duyphong375/uav_payload/docs/presentation/Doc1.docx

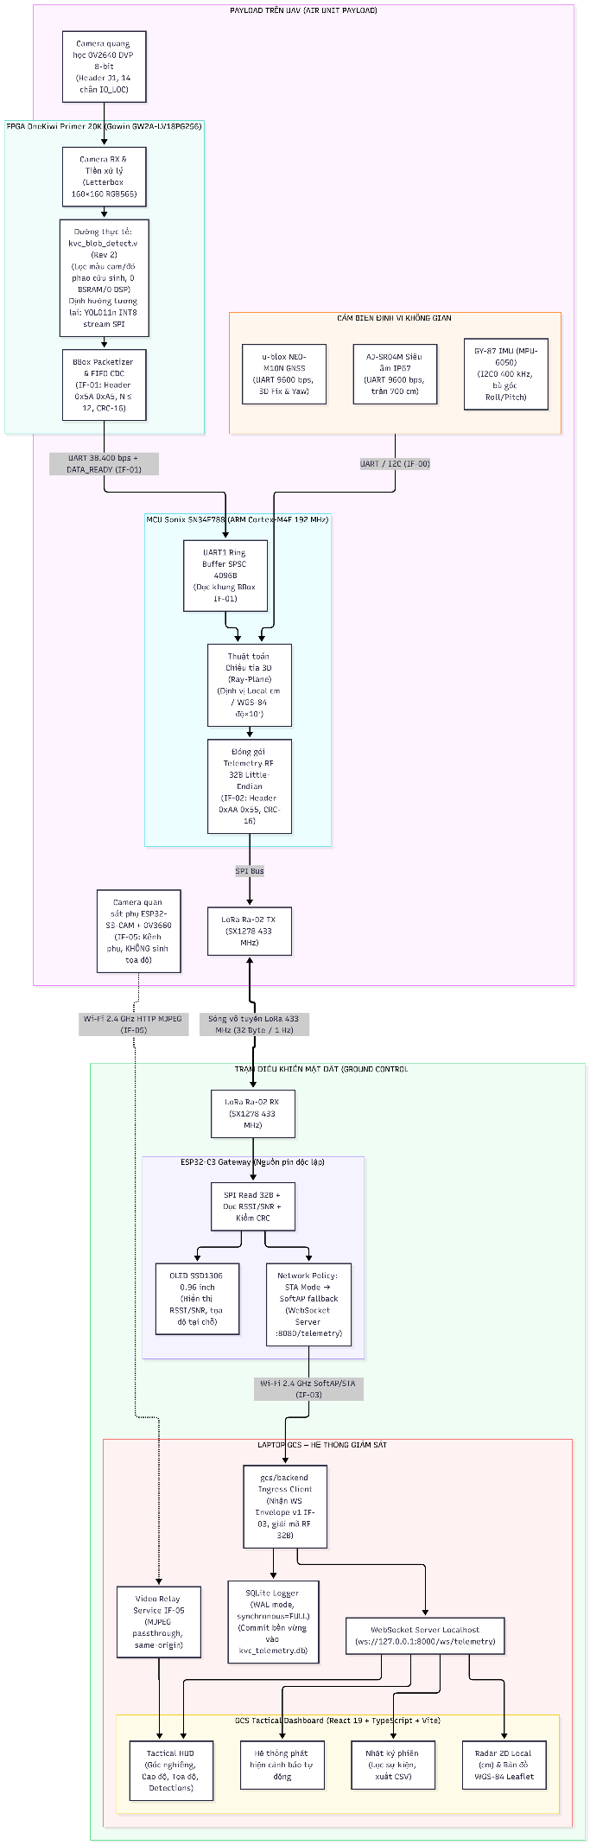
[picture p1: figure]
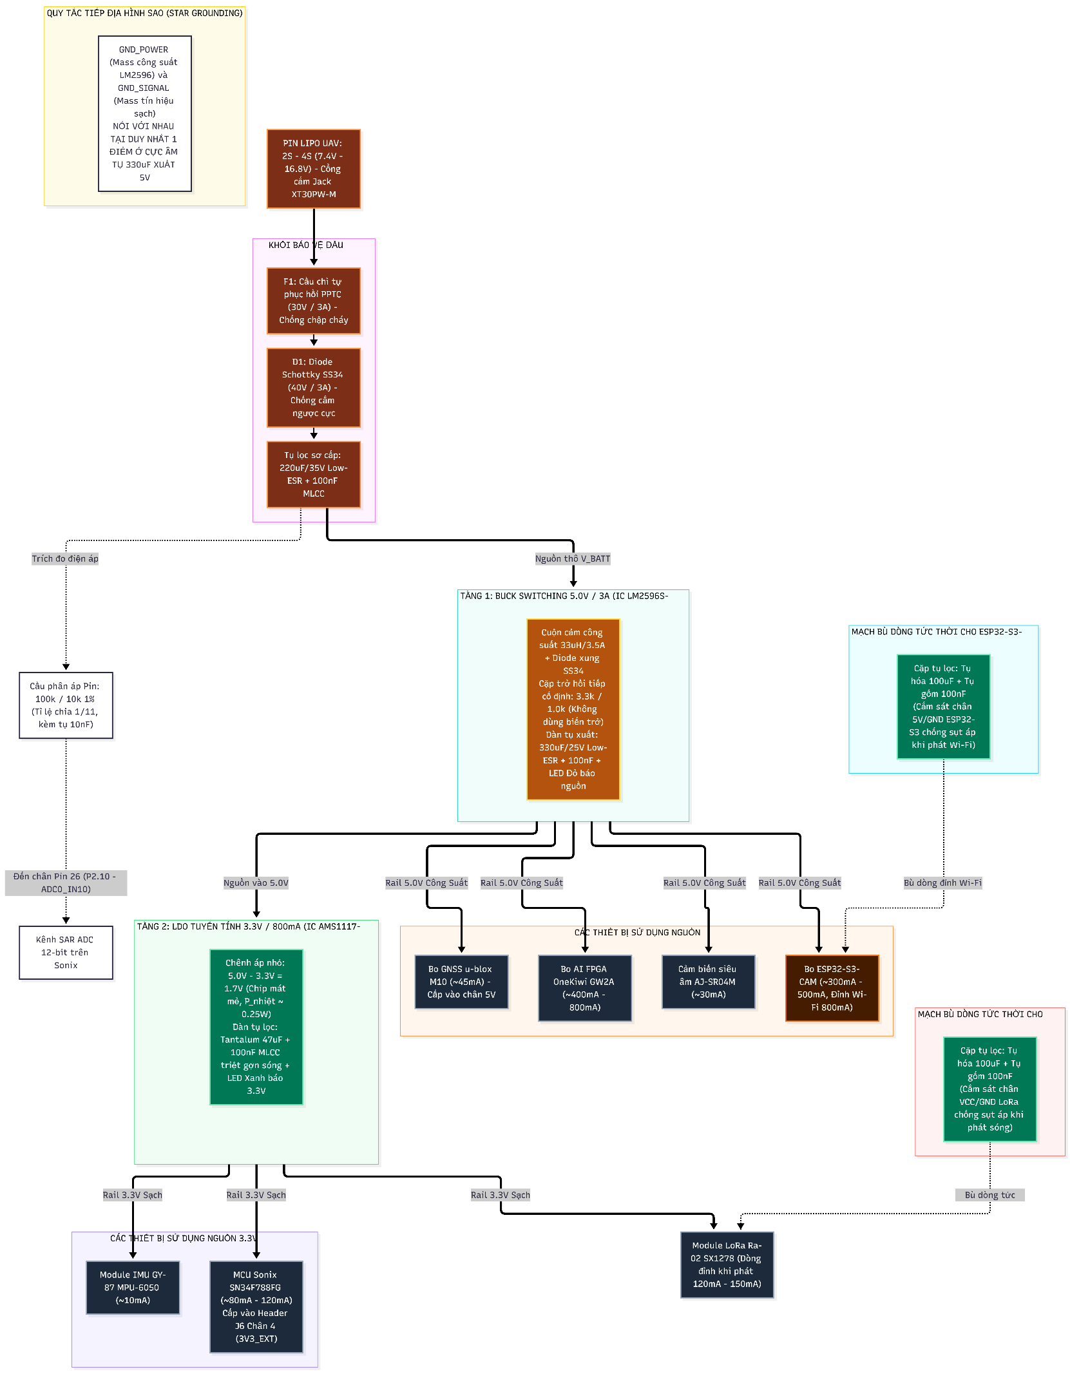
[picture p2: figure]

Kiến trúc toàn hệ thống+Cây phân phối điện năng

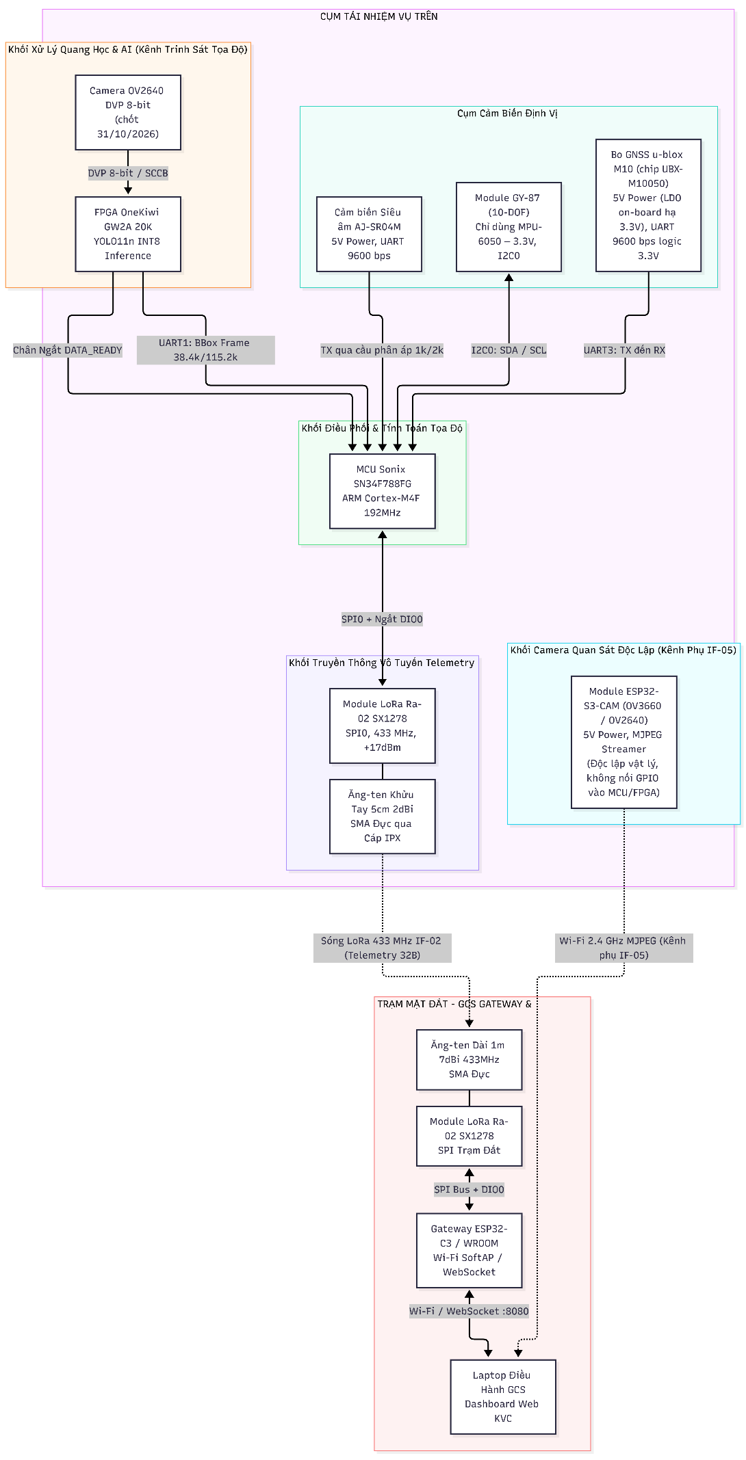
[picture p3: figure]

Sơ đồ khối đấu nối toàn hệ thống

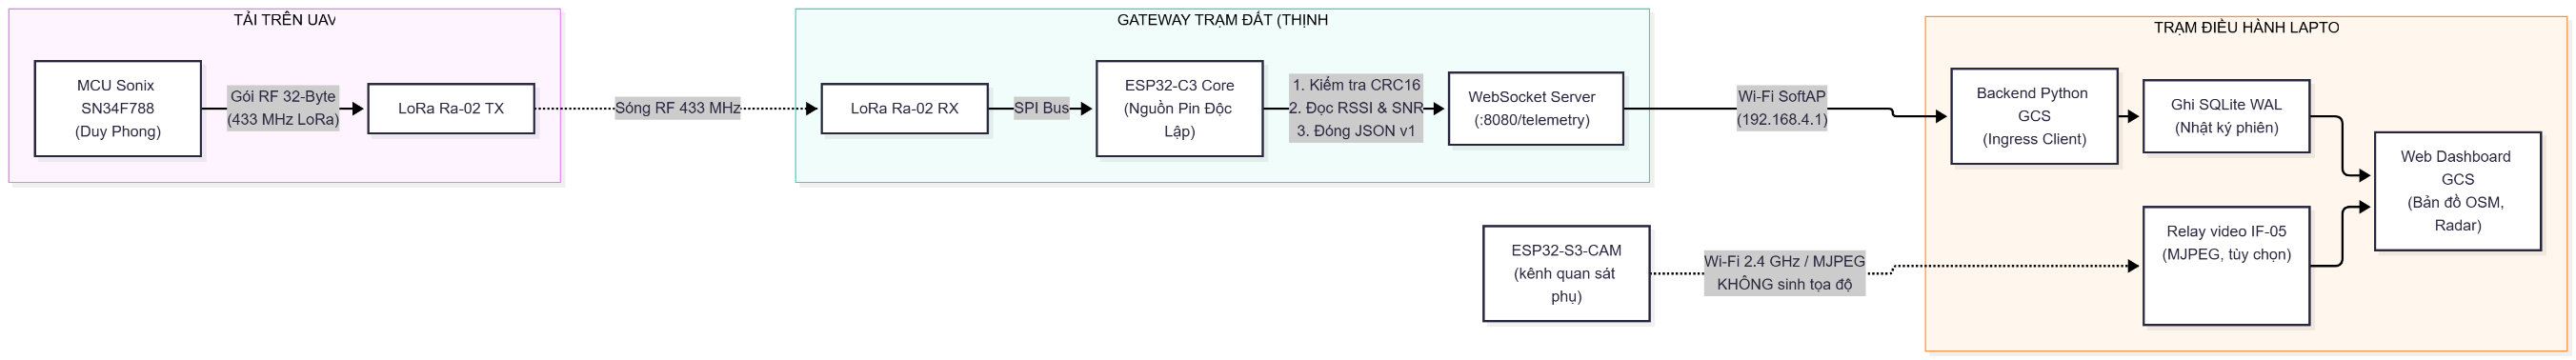
[picture p4: figure]

Luồng telemetry và gateway trạm đất

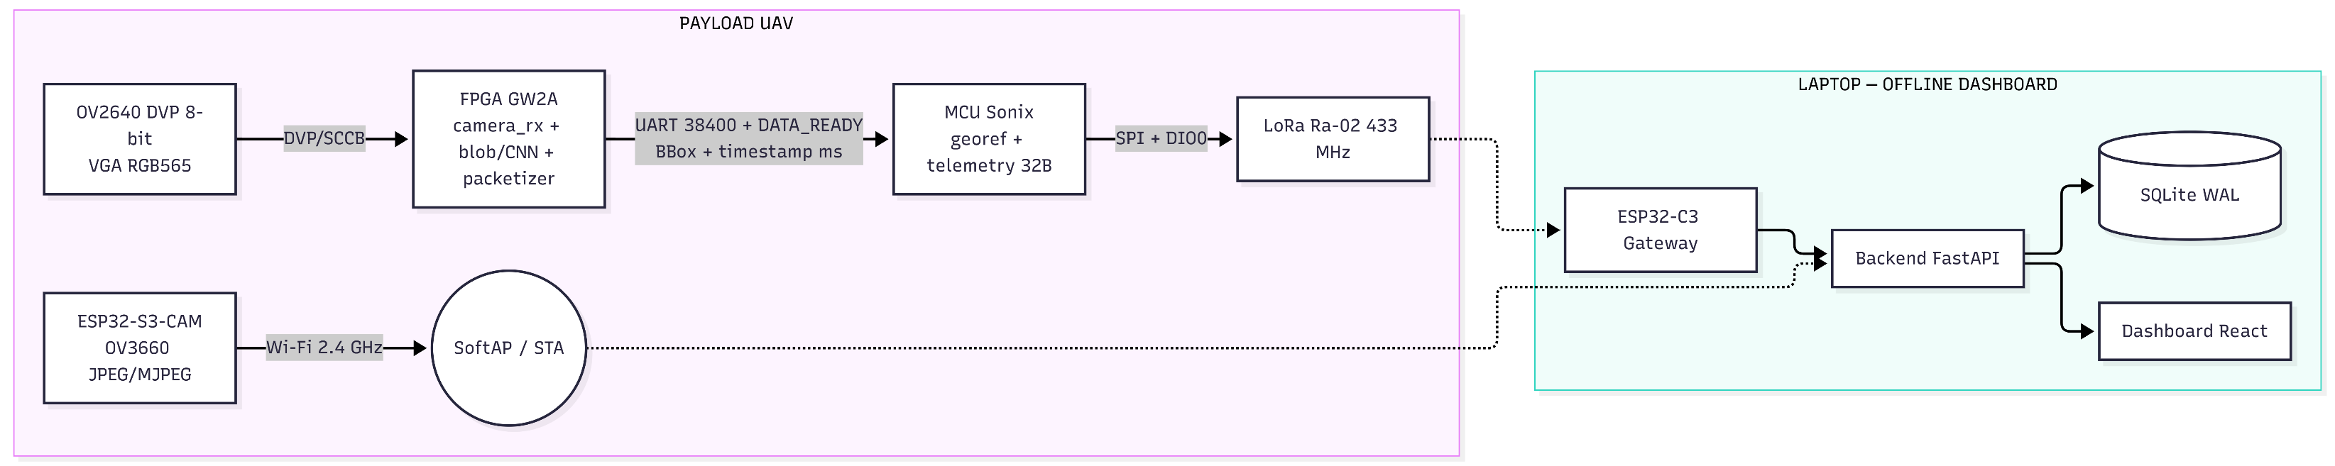
[picture p5: figure]

Sơ đồ phân vai hai camera
