duyphong375/uav_payload/docs/presentation/KVC_Presentation_Deck.pptx

CUỘC THI THIẾT KẾ FPGA VÀ MCU MỞ RỘNG KHU VỰC MIỀN TRUNG 2026
KVC — HỆ THỐNG TẢI NHIỆM VỤ UAV TÌM KIẾM CỨU NẠN BÃO LŨ
Thiết kế tích hợp FPGA Gowin GW2A (Thị giác biên) và MCU Sonix SN34F788 (Định vị 3D) kết hợp truyền tin vô tuyến LoRa 433 MHz
BA ĐỊNH VỊ CỐT LÕI:
• Tải nhiệm vụ (Payload) độc lập, không can thiệp Flight Controller
• Vận hành 100% Offline, không phụ thuộc Internet mặt đất
• Gói tin 32 byte nhị phân thay cho luồng video băng thông cao
Đơn vị: Đội KVC — Đại học Bách Khoa – Đại học Đà Nẵng
Thành viên: Nguyễn Tất Vững (Lead) • Duy Phong • Trường Thịnh • Trung Kiên • Mạnh Cường

## Slide 2

KHỐI 1: TỔNG QUAN
Bài toán cứu nạn thực địa và ràng buộc thiết kế

1:30 | 02/15

Ba nút thắt cứu nạn bão lũ miền Trung
• Hạ tầng tê liệt: Mất điện lưới, trạm BTS ngập úng, không có sóng 4G/5G/Internet.
• Nghịch lý video số: Video HD cần hàng Mbps, sóng cao tần bị mưa bão suy hao cực nặng, trễ lớn hoặc đứt sóng.
• Áp lực thời gian: Cứu hộ viên cần tọa độ trong vài phút, không cần video đẹp; mắt người không quét kịp diện rộng.
• So sánh băng thông: Truyền video HD (Mbps) vs Truyền tọa độ biên (vài chục bps).

Ràng buộc thiết kế & Phạm vi PoC
• Ràng buộc kỹ thuật: Xử lý ảnh tại biên; gói tin siêu nhỏ (Zero-Video); trạm đất tự chủ nguồn pin; offline hoàn toàn.
• Phạm vi trong PoC (Có thể kiểm chứng):
• • Nhận diện trên video lũ có sẵn [SOURCE-VERIFIED]
• • Thử nghiệm bể bơi chứng minh luồng [SIMULATED]
• • Vận hành trực tiếp tại bàn thi, KHÔNG DÙNG SA BÀN.
• Ngoài phạm vi PoC: Khung bay drone, chứng nhận hàng không DO-254/DO-178C, chống nước IP67.

## Slide 3

KHỐI 1: TỔNG QUAN
Kiến trúc tổng thể: Hai nửa hệ thống và bus vật lý

2:00 | 03/15

Phân định phần cứng & Bus truyền dẫn
• AIR UNIT (TẢI UAV):
• ① Camera OV2640 DVP 8-bit nối FPGA OneKiwi 20K.
• ② FPGA nối MCU Sonix qua UART 38.400 bps + DATA_READY.
• ③ Cảm biến: Siêu âm (UART 9600), IMU (I2C0 400k), GNSS (UART 9600).
• ④ MCU nối module LoRa Ra-02 TX qua SPI + DIO0.
• KÊNH VÔ TUYẾN: Sóng LoRa 433 MHz (Khung nhị phân 32 byte).
• GROUND STATION (TRẠM ĐẤT):
• ⑤ LoRa Ra-02 RX nối Gateway ESP32-C3 qua SPI.
• ⑥ ESP32-C3 nối Laptop GCS qua Wi-Fi SoftAP / WebSocket v1.
• Kênh phụ IF-05: ESP32-S3-CAM phát MJPEG Wi-Fi (nét đứt, không qua LoRa).

Bảng phân công nhiệm vụ 5 khối cốt lõi
• FPGA Primer 20K: Trích xuất BBox streaming từ pixel [HARDWARE-VERIFIED]
• MCU Sonix M4F: Dung hợp cảm biến, giải định vị 3D [BUILT]
• LoRa Ra-02 (SX1278): Truyền telemetry 32 byte xuyên bão [HARDWARE-VERIFIED TX]
• ESP32-C3 Gateway: Thu RF, OLED hiện trường, SoftAP [BUILT]
• Laptop GCS: Dashboard, SQLite WAL, Nhật ký phiên [SOURCE-VERIFIED]
• Kênh phụ IF-05: Mắt nhìn video phụ trợ, không sinh tọa độ.

## Slide 4

KHỐI 1: TỔNG QUAN
Nguyên lý cốt lõi: Chỉ truyền kết luận, không truyền video

1:15 | 04/15

Linh hồn thiết kế của đề tài KVC
• CÂU CHỐT CỐT LÕI:
'Biến một luồng video thành một tọa độ trong 32 byte.'
• Ba tầng giá trị thiết kế:
• • Giảm băng thông 5 bậc độ lớn: từ hàng triệu bps xuống đúng 256 bps.
• • Giảm phụ thuộc chất lượng sóng: đường truyền video mất, cứu hộ vẫn chạy.
• • Vẫn bảo đảm đủ 100% dữ liệu để triển khai đội cứu nạn.
• Ranh giới an toàn: Payload không can thiệp điều khiển bay, không arm/disarm, không waypoint.

Chuỗi chuyển hóa 4 bước dữ liệu
• 1. Ảnh quang học thô: OV2640 DVP 640×480 RGB565 (~614 KB/khung).
• 2. Tọa độ BBox: Trích xuất song song trên FPGA (Khung 18 Byte IF-01).
• 3. Tọa độ cứu nạn 3D: MCU giải giao điểm mặt nước (Khung 32 Byte IF-02).
• 4. Hành động cứu hộ: Xuất ca-nô tiếp cận nạn nhân tức thì.
• Ẩn dụ kiến trúc:
• • FPGA = Mắt & Não trích xuất | MCU = Định vị & Đóng gói
• • LoRa = Dây dẫn vô tuyến | ESP32 = Cổng vào | Laptop = Bản đồ chỉ huy
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
