duyphong375/uav_payload/docs/presentation/KVC_ThuyetTrinh_15_Slide.pptx

CUỘC THI THIẾT KẾ FPGA & MCU MỞ RỘNG KHU VỰC MIỀN TRUNG 2026

KVC — Tải nhiệm vụ UAV tìm kiếm cứu nạn bão lũ

Phát hiện tại biên · Định vị bằng cảm biến · Truyền metadata 32 byte · Trạm đất ngoại tuyến

▸ Đội KVC — Trường Đại học Bách Khoa, Đại học Đà Nẵng · 5 thành viên
▸ KVC là payload gắn trên UAV, không phải flight controller
▸ Hai luồng vật lý độc lập: LoRa 433 MHz cho tọa độ, Wi-Fi cho video quan sát
▸ Toàn hệ thống vận hành 100% ngoại tuyến, không phụ thuộc Internet

KVC · Payload UAV tìm kiếm cứu nạn bão lũ

01 / 15

## Slide 2

PHẦN 1 · TỔNG QUAN

Bài toán và ràng buộc thiết kế

Vì sao phải xử lý tại biên thay vì truyền video về trạm đất

▸ Lũ quét: cứu hộ cần vị trí trong vài phút, không cần video chất lượng cao
▸ Mất Internet/4G; truyền video qua sóng dài cần hàng Mbps nên không khả thi
▸ Đánh đổi cốt lõi: truyền video (Mbps) so với truyền metadata (bps)
▸ Ràng buộc rút ra: xử lý tại chỗ, gói tin cực nhỏ, trạm đất tự chủ nguồn, offline hoàn toàn
▸ Phạm vi PoC: video lũ có sẵn, thử bể bơi, test trực tiếp — không chế tạo khung bay
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
