duyphong375/uav_payload/docs/verification/evidence/KVC-CAM-DIAG-20261102-002.md

# `KVC-CAM-DIAG` rev 2 — bucket 2x + bucket glitch + bộ lọc VSYNC

- **Mã:** `KVC-CAM-DIAG-20261102-002` (rev 2, tiếp nối `-001`)
- **Owner:** Kilo · **Ngày:** 02/11/2026
- **Trạng thái:** `BUILT` + `SIMULATED` — **chưa nạp bo**

---

## 1. Vì sao có rev 2

Capture 300 s trên bo (`G6.1_blob_vsyncdiag_20261102-1415.bin`) cho thấy ba vấn
đề của bản rev 1, đều đã phân tích trong
`KVC-CAM-DIAG-20261102-1415-analysis.md`:

| # | Vấn đề rev 1 | Hệ quả |
| :---: | :--- | :--- |
| 1 | `t_bother` ở **trường H slot 9, 8 bit** | 2.191 → 143 (`mod 256`), báo cáo sai một đại lượng quan trọng |
| 2 | **Không có bucket 2x (131 ms)** | 48,3 % chu kỳ rơi vào `other`; không phân biệt được AEC với nhịp 2x |
| 3 | **Không lọc glitch** | `w_min_ms = 1 ms` ở 39/151 cửa sổ; `t_vsync` bị thổi phồng 25 %, làm hỏng kết luận Q2 |

Rev 2 sửa cả ba.

---

## 2. Thay đổi

### 2.1 Bucket mới — phủ kín trục số, không chồng nhau

| Bucket | Dải (ms) | Ghi chú |
| :--- | :--- | :--- |
| **short** | **< 55** | MỚI — gom glitch lọt qua bộ lọc, tách khỏi `other` |
| 1x | 55 – 80 | nhịp 65,5 ms (15,26 fps) |
| **2x** | **120 – 145** | MỚI — nhịp 131 ms (7,6 fps), đúng phép đo 01–02/11 |
| 3x | 180 – 215 | nhịp 197 ms |
| 5x | 310 – 340 | nhịp 328 ms |
| 6x | 380 – 410 | nhịp 394 ms |
| other | còn lại | gồm 4x (~262), 7x…, và giá trị giữa các dải |

### 2.2 Bộ lọc glitch

```verilog
parameter integer GLITCH_MS = 10

wire accept = vsync_pulse && (!have_prev || (since_ok >= GLITCH_TICKS));
wire reject = vsync_pulse && !accept;
```

So sánh với **cạnh đã chấp nhận gần nhất** (`since_ok`), không phải cạnh trước
bất kỳ — nhờ vậy một chuỗi gai ngắn không tự kéo dài thời gian khoá.

### 2.3 `vsync_report` — 12 slot, không còn trường 8 bit

24 giá trị 16 bit ÷ 2 = **12 slot**, vừa đúng `MAX_BBOX = 12` của
`bbox_packetizer` nên không phải đổi tham số đó. Khung 106 byte = 27,6 ms ở
38.400 bps, vẫn ngắn hơn nhiều so với cửa sổ 2.000 ms.

Bản đồ đầy đủ ở đầu `vsync_report.v` và `decode_vsync_diag.py`.

### 2.4 Giới hạn của bộ lọc — đã ghi rõ trong RTL và kiểm bằng testbench

Nếu nhiễu lặp **đầy đủ mỗi 10 ms**, một gai sẽ lọt qua sau mỗi 10 ms. So sánh
thời gian đơn thuần không phân biệt được. Vì vậy:

- `t_rejected` — số gai **bị chặn**
- `t_bshort` — số chu kỳ ngắn **lọt qua**

Cả hai > 0 nghĩa là đường VSYNC **không sạch**, và mọi kết luận về nhịp camera
phải kèm điều kiện đó.

---

## 3. Kiểm chứng

### 3.1 `tb_vsync_monitor` — **42/42 PASS**

| Test | Nội dung | Kết quả |
| :---: | :--- | :--- |
| 1 | 5 xung đều 65,6 ms | `t_b1x=4`, các bucket khác 0 |
| 2 | ngừng bơm 300 ms | `t_vsync` không đổi |
| 3 | 5 xung đều **131 ms** | **`t_b2x=4`** — bucket 2x hoạt động |
| 4 | mẫu 1x/2x/3x/5x/6x | cả 5 bucket = 1, tổng = 5 |
| 5 | **5 gai cách 1 ms** | `t_vsync=2`, `t_rejected=5`, `t_bshort=0` — **lọc đúng** |
| 5b | **gai cách 12 ms** | `t_rejected=0`, `t_bshort=1` — **lọt qua, đúng như tài liệu** |
| 6 | 6 VSYNC / 3 frame | chênh = 3 |
| 7 | chu kỳ 30 ms (> 10, < 55) | `t_bshort=3`, `t_rejected=0` |

Test 5 và 5b cùng tồn tại có chủ đích: 5 chứng minh lọc hoạt động, 5b chứng minh
**giới hạn** của nó để không ai tưởng bộ lọc mạnh hơn thực tế.

### 3.2 Các TB khác

| TB | Kết quả |
| :--- | :--- |
| `tb_vsync_selfmeas` (top-level, `DIAG_MODE=2`) | **10/10 PASS** — N=12, 106 byte, slot order đúng |
| Toàn bộ suite | **24/24 PASS** |

### 3.3 `decode_vsync_diag.py`

- Nhận diện layout theo số slot: **12 → rev 2**, **10 → rev 1** (tự phục hồi
  `t_bother` bị cắt 8 bit và cảnh báo).
- Đọc lại file cũ `…1415.bin` vẫn đúng: `layout N=10`, `t_bother=2191`, cảnh
  báo `other > 40 %`.
- Cảnh báo khi tổng bucket ≠ `t_vsync − 1`.
- Ba phần kết luận Q1 (nhịp) / Q2 (chênh VSYNC-frame) / Q3 (nhiễu).

---

## 4. Bitstream

| Trường | Giá trị |
| :--- | :--- |
| SHA-256 | **`CA6D5137292FEFACAB98DC2097A7611A110F9E052189FDC839D748D4752E4B9D`** |
| File | `review/artifacts/KVC_FPGA_diag_vsync_CA6D5137.fs` |
| Top | `kvc_top_diag_vsync` (`DIAG_MODE = 2`, `DIAG_GLITCH_MS = 10`) |
| Fmax `clk_100m` | **109,546 MHz**, TNS = 0 |
| Fmax `cam_pclk` | **146,857 MHz**, TNS = 0 |
| Tài nguyên | 2.588 LUT / 2.180 FF / 1 BSRAM / 0,5 DSP |
| Đường tới hạn | `bbox_packetizer` 11,365 ns (**không** phải logic mới) |
| Build script | `KVC_PR/tools/build_kvc_diag_vsync.tcl` |

So sánh ba bản:

| Bản | SHA | Fmax | LUT | Slot | Ghi chú |
| :--- | :--- | ---: | ---: | :---: | :--- |
| rev 0 | `C82B9EFE` | 105,030 | 2.437 | 10 | `t_bother` 8 bit |
| rev 1 | `840117FA` | 121,436 | 2.416 | 10 | `t_bother` 16 bit |
| **rev 2** | **`CA6D5137`** | **109,546** | **2.588** | **12** | +2x, +short, +lọc |

Fmax giảm 121 → 110 MHz vì thêm 172 LUT cho bucket và bộ lọc; vẫn trên ngưỡng
100 MHz với biên 9,5 %, và TNS = 0 trên cả ba clock.

---

## 5. Cách dùng

```powershell
# 1. Nạp review/artifacts/KVC_FPGA_diag_vsync_CA6D5137.fs qua SRAM Program

# 2. Kiem chu ky nap: phai thay N=12 va khung 106 byte
python scripts/manual/fpga_uart_capture.py --port COM9 --baud 38400 --seconds 10

# 3. Capture 300 s
python scripts/manual/fpga_uart_capture.py --port COM9 --baud 38400 --seconds 300 `
  --dump docs/verification/evidence/G6.1_blob_vsyncdiag_<YYYYMMDD-HHMM>.bin

# 4. Giai ma
python scripts/manual/decode_vsync_diag.py `
  --file docs/verification/evidence/G6.1_blob_vsyncdiag_<YYYYMMDD-HHMM>.bin
```

**Bước 2 bắt buộc.** Lần 02/11 11:30 đã capture nhầm bitstream release vì bỏ qua
bước này.

---

## 6. Điều rev 2 sẽ trả lời được

| Câu hỏi | Cách đọc |
| :--- | :--- |
| Nhịp VSYNC có phải 1x/2x/3x/5x/6x không? | `t_b2x` và `t_bshort` khác 0 hay không |
| `other` còn lớn không? | nếu vẫn > 40 %, mô hình bucket vẫn chưa phủ — cần đo lại `w_min`/`w_max` thô |
| Đường VSYNC có nhiễu không? | `t_rejected` và `t_bshort` |
| FPGA có rớt frame không? | `t_vsync − t_frame`, **chỉ khi `t_rejected` nhỏ** |

Rev 2 **không** trả lời được: PCLK (chưa đo), exposure (chưa đo), và nguyên
nhân gốc của nhiễu nếu `t_rejected` lớn — khi đó phải xem phần cứng chân A15 và
`cam_vsync_sync` 3FF.

---

## 7. Bitstream chẩn đoán nói cùng dây với MCU — đã kiểm, hiện KHÔNG xảy ra

**Tình huống:** `CA6D5137` đã nạp (SRAM Program OK, Status `0x00006020`).
Cáp UART đang cắm cho cụm Sonix MCU. `R13 (J2-11)` nối cứng tới `P2.3 (JP3 7/8)`
theo `KVC-MCU-FPGA-LORA-20261101-001.md:23`.

Nghĩa là **cùng một đường dây** đang mang báo cáo chẩn đoán `N = 12` vào MCU.

### 7.1 Parser MCU CHẤP NHẬN N = 12

`firmware/mcu_payload/src/sensors/kvc_fpga_bbox.c:239`:

```c
if (ver != KVC_FPGA_VERSION || count > KVC_FPGA_MAX_CANDIDATES) {
    s_fsm_state = STATE_WAIT_SYNC0;   /* huy frame */
}
```

`KVC_FPGA_MAX_CANDIDATES = 20` (`kvc_fpga_bbox.h:30`). Vậy **N = 12 lọt qua**
kiểm tra và được nhận là frame IF-01 hợp lệ. CRC cũng đúng vì `vsync_report`
dùng đúng `bbox_packetizer`.

### 7.2 Hệ quả nếu telemetry đang chạy

12 "bbox" chẩn đoán có `class = 2`, `conf = 100` cố định:

| Trường chẩn đoán | MCU đọc thành |
| :--- | :--- |
| `x = w_vsync` (vd 19) | `x_center = 19` |
| `y = w_periods` (vd 19) | `y_center = 19` |
| `w = chỉ số slot` (0..11) | `width` 0..11 |
| `h = 0` | `height = 0` |

`main.c:2066-2068` sẽ bật `KVC_FLAG_AI_DETECTED`, đặt `class_id = 2`,
`confidence = 100`, rồi gọi `kvc_georef_target()` với `x_center/y_center` là số
đếm chẩn đoán. Telemetry 1 Hz sẽ báo "AI phát hiện" liên tục đến khi hết hạn
frame (`KVC_GEO_BBOX_MAX_AGE_MS = 300`).

### 7.2b KIỂM TRA TRÊN BO — rủi ro **KHÔNG xảy ra**

Đo trực tiếp ngày 02/11/2026, log `[M3]` của Sonix MCU:

```text
[M3] ... | BB n0 v1 crc0 en1 | LORA d1 ver=0x12 | tx=1759 ...
```

| Trường | Giá trị | Nghĩa |
| :--- | :--- | :--- |
| `n0` | 0 mục tiêu | **không phải 12** |
| `v1` | frame hợp lệ | đang nhận khung IF-01 đều đặn |
| `crc0` | 0 lỗi CRC | khung đúng |
| `en1` | driver FPGA bật | đường UART1 hoạt động |

`n` trong log lấy từ `bbox->candidate_count` (`main.c:890`). Nếu rev 2 đang chạy,
`n` sẽ là **12** ở mọi gói. Thực tế là **0** ⇒

> **Bo đang chạy bitstream release `86CCF5DD`, không phải `CA6D5137`.**

Điều này khớp với chữ ký release: `N = 0` khi không có mục tiêu trước ống kính,
một khung mỗi frame (~4,3 fps), `v1` giữ liên tục.

Nhiều khả năng đã có lần nạp lại release sau lần nạp rev 2, hoặc SRAM mất điện.
Không cần xác định chính xác — điều quan trọng là **rủi ro §7 chưa xảy ra**, và
đây là **bằng chứng trực tiếp**, không phải suy đoán.

**Hệ quả cho kế hoạch:** vì cáp `R13` được giữ nguyên cho chuỗi tích hợp, và bo
đang chạy release, trạng thái hiện tại **an toàn**. Nhưng bất kỳ lần nạp rev 2
nào trong tương lai — kể cả vô tình — sẽ **ngay lập tức** làm `n` nhảy lên 12.
Trước khi nạp lại rev 2, phải chọn một trong hai: rút dây `R13`, hoặc chấp nhận
dữ liệu MCU bị nhiễu trong suốt thời gian đó.

### 7.3 Đây không phải lỗi RTL

`vsync_report` làm đúng việc của nó. Vấn đề là **dùng chung một đường UART cho
hai mục đích** mà không có cơ chế loại trừ. `AGENTS.md` cấm đổi ABI IF-01, nên
không thể "sửa" bằng cách thêm mã nhận dạng vào khung.

### 7.4 Cách tránh

| Mục đích | Việc làm |
| :--- | :--- |
| Cần log MCU | **Nạp lại release `86CCF5DD`** trước khi tin telemetry |
| Cần đo VSYNC | **Rút dây `R13` khỏi `P2.3`**, cắm sang USB-UART CH340 |
| Đọc telemetry trong lúc chẩn đoán | **Không** dùng — `AI_DETECTED` và toạ độ mục tiêu là rác |

Chọn phương án 2 cho phiên capture 300 s tới, và ghi vào log là **đã rút dây
MCU** — nếu không, một lần nữa không quy được trách nhiệm.

### 7.5 Đề xuất cho lần sau (chưa làm, cần duyệt)

Một trong hai, cả hai đều **không đổi ABI**:

1. **Dùng `class` riêng** cho báo cáo chẩn đoán (ví dụ `class = 0xFF`) để MCU
   lọc được. Hiện `vsync_report` đặt `class = 2` chỉ để khung "hợp lệ" — nhưng
   `class` **không** tham gia kiểm tra hợp lệ nào trong parser MCU, nên đổi
   sang giá trị riêng an toàn hơn.
2. **Thêm bit chế độ** vào trường `reserved` của header IF-01 nếu ABI cho phép —
   cần HUMAN duyệt vì đụng layout.

Phương án 1 rẻ hơn và không đụng ABI. Nhưng nó vẫn không giải quyết việc MCU
nhận 12 khung sai mỗi 2 s, chỉ giúp lọc.
