duyphong375/uav_payload/docs/verification/evidence/KVC-FPGA-BLOB-20261102-001.md

# KVC — Phân tích `.bin` 02/11 + soak 30 phút, và findings F-04…F-06

- **Mã:** `KVC-FPGA-BLOB-20261102-001`
- **Loại:** phân tích bằng chứng (không sửa RTL, không đổi ABI)
- **Owner:** Kilo · **Ngày:** 02/11/2026
- **Căn cứ:** các file trong chính thư mục này, đọc trực tiếp bằng script CRC-16:

| File | Byte | Khung | Dùng cho |
| :--- | ---: | ---: | :--- |
| `G6.1_blob_light_bright_20261102-0230.bin` | 1.288 | 128 | F-05, định lượng nhịp khung |
| `F02_card240_20261102.bin` | 920 | 84 | F-05 (lặp lại cùng phân bố) |
| `F02_card_20261102.bin` | 890 | 85 | F-04 (timestamp lùi) |
| `G2.7_soak_20261102.txt` | 320 KB | 272 mẫu `[RING]` | G2.7 + độ ổn định |
| `F02_card240_run2.bin` | 3.655 | **0** | **không dùng** — không phải IF-01 |

Mức bằng chứng: `HARDWARE-VERIFIED` cho các số đọc trực tiếp từ file;
`SOURCE-VERIFIED` cho các suy luận từ RTL; `DESIGN` cho giả thuyết cơ chế.

---

## 1. F-04 (P2) — Timestamp IF-01 có thể **bị xé** (torn read)

**Vị trí:** `KVC_PR/src/comm/bbox_packetizer.v:76-79` và `:119-135`.

```verilog
wire [7:0] ts0 = timestamp[7:0];   // đọc TRỰC TIẾP từ counter đang chạy
...
16'd4: get_header_byte = ts0;      // byte 0 phát ở thời điểm T
...
16'd7: get_header_byte = ts3;      // byte 3 phát ở thời điểm T + 7 byte-time
```

`timestamp` là `frame_timestamp`, counter tự do trong `kvc_top_demo.v:527-537`
tăng mỗi 1 ms. Một khung `N=0` phát 8 byte header, mỗi byte 0,26 ms ⇒ **2,08 ms**.
Counter tăng **2 lần** trong lúc header đang được đọc. Không có thanh ghi chốt.

**Bằng chứng đo được** — `F02_card_20261102.bin`, khung thứ 15:

```text
off=148  ts=728063  (0x0B1B3B)
off=158  ts=728004  (0x0B1BC4)   ← LÙI 59 ms, CRC vẫn đúng
```

CRC-16 hợp lệ trên cả hai khung ⇒ các byte **đúng như đã phát**, không phải lỗi
đường truyền. Một counter đơn điệu không thể phát ra giá trị nhỏ hơn sau giá trị
lớn hơn. Nguyên nhân khả dĩ: `ts0` được lấy ở một thời điểm khác với `ts1..ts3`,
nên khi có nhớ (carry) giữa hai lần đọc, giá trị ghép không ứng với một mốc thời
gian nào.

**Ảnh hưởng:** `timestamp_ms` đi vào IF-02 và được georef dùng để ghép BBox với
vị trí UAV. Timestamp lệch vài ms là chấp nhận được; **lùi 59 ms** thì không.
Tần suất: 1/85 khung trong file này (1,2 %). Không xuất hiện trong `.bin` 128
khung, nên đây là lỗi **thỉnh thoảng**, đúng bản chất race với carry.

**Sửa tối thiểu (chưa làm — cần HUMAN duyệt vì đụng RTL):** chốt timestamp một
lần tại `start` trong `bbox_packetizer`, rồi phát 4 byte từ thanh ghi đó.

```verilog
reg [31:0] ts_lat;
...
S_IDLE: if (start) ts_lat <= timestamp;      // 1 thanh ghi 32 bit
```

Không đổi layout/CRC/baud. Thêm ~32 FF. Cần 1 bitstream mới + testbench.

**Phép xác minh:** chạy lại `--dump` 30 s (≈128 khung × 3 lần) và khẳng định
`ts[i+1] > ts[i]` trên **mọi** khung; trước khi sửa phải tái hiện được ≥1 lần
lùi để chứng minh bản sửa có tác dụng.

---

## 2. F-05 (P2) — Nhịp khung lượng tử hoá thành bội số của **65,6 ms**

### 2.1 Số đo

`G6.1_blob_light_bright_20261102-0230.bin`, 128 khung, 127 khoảng:

| Khoảng (ms) | Số lần | % | ≈ N × 65,6 ms |
| ---: | ---: | ---: | :--- |
| 67 – 68 | 9 | 7,1 % | **1×** |
| 196 – 199 | 80 | 63,0 % | **3×** |
| 324 – 328 | 21 | 16,5 % | **5×** |
| 393 – 395 | 17 | 13,4 % | **6×** |

Không có khoảng nào ngoài bốn nhóm. Khớp lưới đơn pha bằng bình phương tối thiểu:
**P = 65,605 ms, rms = 1,25 ms** trên 128 mốc. Kiểm chéo bộ ba đặc trưng:

```text
394 + 325 + 68 = 786 ms = 12 × 65,5 ms
```

`F02_card240_20261102.bin` cho **cùng phân bố** với P = 65,33 ms (rms 1,33 ms),
nên đây không phải hiện tượng của một lần đo.

Hệ quả số học:

```text
Trung bình gia quyền = (9×1 + 80×3 + 21×5 + 17×6) / 127 = 3,59 quantum
3,59 × 65,6 ms = 235,5 ms  ↔ đo được 29.915 / 127 = 235,6 ms   ✓
235,6 ms → 4,24 frame/s  ↔ tool báo 4,245                    ✓
```

### 2.2 Cách đọc đúng

Mỗi khung IF-01 ứng với **một** frame camera (`tgl` chỉ đảo khi `frame_seen = 1`,
`kvc_blob_detect.v:236`), và số khung = 128 = số frame. Vậy **không mất khung**.
Điều xảy ra là **thời lượng từng frame thay đổi**, nhận các giá trị ≈ 1, 3, 5, 6
lần **thời lượng frame ngắn nhất**:

```text
T_min = 65,6 ms  →  trần 15,25 frame/s
```

Ở phòng thiếu sáng, phần lớn frame bị kéo dài 3× (197 ms). Đây là dấu hiệu kinh
điển của **AEC kéo dài thời gian phơi sáng quá frame time**, khiến sensor nới dài
frame. Nó cũng giải thích vì sao mỗi phiên đo cho một số khác nhau:

| Phiên | fPS | Chu kỳ TB | ≈ quantum |
| :--- | ---: | ---: | :--- |
| 01/11 | 5,08 | 197 ms | **3×** |
| 02/11 01:42 (nền) | 7,48 | 133,7 ms | **2×** |
| 02/11 02:30 (đèn) | 4,245 | 235,6 ms | **3,59×** (hỗn hợp 1/3/5/6) |
| 02/11 soak 30 phút | 4,29 | 233 ms | 3,55× |

Bốn phiên, bốn tỷ lệ khác nhau, **tất cả nằm trên cùng một lưới 65,6 ms**. Một bộ
chia PCLK cố định không tạo ra được phân bố rời rạc như vậy.

### 2.3 Hệ quả cho PLAN-005

**(a) Vách PCLK không phải 750 kHz — mà ≥ 9 MHz.** Frame ngắn nhất là 67 ms. Nếu
đầu ra là 640×480 RGB565 (614.400 byte/frame):

```text
PCLK ≥ 614.400 / 0,067 s = 9,17 MHz   (blanking = 0)
với blanking 16 %        ≈ 10,6 MHz
```

Con số ~3 MHz mà bản nháp trước nêu **không thể** tạo ra frame 67 ms. Giả thuyết
"CLKRC chia 8 ⇒ 750 kHz" bị **bác bỏ bằng số đo**, không cần scope.

**(b) Nâng PCLK một mình sẽ KHÔNG đưa fps lên 25–32.** Nó chỉ nâng **trần** từ
15,25 fps. Muốn 30 fps cần:

```text
T_min = 33 ms  ⇒  PCLK ≥ 614.400/0,033 = 18,6 MHz  (blanking 0)
                  ≈ 21,5 MHz với blanking 16 %
```

Nhưng nếu AEC vẫn kéo mỗi frame lên 3× thì fps thực vẫn ≈ 10, không phải 30. Vì
vậy phải **giới hạn exposure** (AEC) song song với nâng PCLK.

**(c) Ưu tiên đổi: AEC trước, PCLK sau.** Khoá exposure/giảm thời gian phơi
(hoặc tăng sáng) là đường ngắn nhất để k = 1. Đo lại fps; nếu chạm 15,25 thì trần
PCLK mới là nút thắt tiếp theo.

---

## 3. G2.7 — Soak 30 phút: **PASS**, trừ nhiệt độ

`G2.7_soak_20261102.txt`, 03:02:31 → 03:32:31 (đúng 30,0 phút).

| Chỉ số | Giá trị | Kết luận |
| :--- | :--- | :--- |
| Mẫu `[RING]FPGA` | 272, phủ 1.788,4 s (29,81 phút) | liên tục |
| `fe` / `oe` / `drop` | **0** trên toàn bộ 272 mẫu | đạt |
| `isr == byt` | đúng trên 272/272 | đạt |
| Byte nhận | 14.972 → 91.722 = **76.750 B** | |
| Tốc độ | **42,92 B/s** = **4,29 frame/s** (`N=0` 10 B) | |
| Độ ổn định | nửa đầu 42,95 B/s, nửa sau 42,87 B/s (**−0,2 %**) | đạt |
| `late_max` | 0 trên 1.456 dòng `[M3]` | đạt |
| `ovr` | 0 trên 1.456 dòng | đạt |
| LoRa | `tx=1691`, `err=0` | đạt |
| `BB` | 1.456 dòng: `v1 crc0 en1` 100 %; `n0`=1.443, `n1`=13 | xem §4 |
| Nhiệt độ FPGA | **CHƯA ĐO** | thiếu |

Tiêu chí G2.7 gồm 4 mục: `fe=0, oe=0, drop=0` ✓ · FPS không giảm > 5 % ✓ (−0,2 %)
· nhiệt < 60 °C **CHƯA ĐO**. Vậy ghi **G2.7 = PASS (3/4, nhiệt NOT MEASURED)**,
không ghi PASS tuyệt đối.

### 3.1 Timebase MCU vẫn lệch và **không ổn định**

`[M3] t=` tăng 1.000 ms giữa 1.380/1.455 lần in, nhưng so với wall-clock:

| Mốc | tỷ lệ MCU/wall |
| :--- | ---: |
| 25 % thời gian | 0,751 |
| 50 % | 0,794 |
| 75 % | 0,815 |
| toàn bộ | 0,817 (MCU chậm **18,3 %**) |

Không phải một hệ số cố định — nó **trôi**. Có hai khả năng: (i) clock MCU trôi
theo nhiệt, (ii) mốc wall bên PC bị trễ do USB gom gói (`min 0,14 s`, `max 3,93 s`
giữa hai dòng liên tiếp, dù MCU chỉ cách 1 s).

> **CẬP NHẬT 02/11/2026 — đã loại trừ (ii), nâng F-06 lên P1.**
>
> Đọc source: `kvc_millis()` (`main.c:133-135`) trả về `kvc_timebase_ms()` — một
> biến đếm **phần mềm**, chỉ tăng khi `delay_ms()` (`main.c:95-106`) hoặc
> `kvc_usound_delay_us()` được gọi. `kvc_timebase_add_us()` **không được gọi ở
> đâu trong firmware production** (chỉ 5 lần trong `tests/test_kvc_timebase.c`).
> Vậy thời gian CPU dùng để chạy code thật **không được đếm**.
>
> Jitter USB có thật nhưng **không thể** tạo bias hệ thống 18 % trên 1.456 mẫu:
> jitter là ngẫu nhiên và dao động quanh giá trị trung bình, còn drift ở đây
> **đổi theo tải** (0,740 → 0,856 qua các đoạn). Trần sai số IHRC ±2 %
> (`main.c:123`) cũng không đủ.
>
> **Chưa tách được** bao nhiêu phần trăm là IHRC và bao nhiêu là thời gian không
> được đếm — muốn tách phải so với `frame_timestamp` của FPGA hoặc 1PPS GNSS.
> Nhưng **dù chia thế nào, kết luận vẫn là P1**: drift 110 s/10 phút so với
> ngưỡng 50 ms.
>
> Chi tiết đầy đủ: `KVC-F02-G27-20261102-001.md` §2.4.

Điều chắc chắn: **P0-02 vẫn mở**, và `timestamp_ms` của IF-02 **không** dùng được
cho georef ở trạng thái hiện tại.

---

## 4. Hai quan sát cần theo dõi

**(a) `BB n1` xuất hiện 13 lần trong soak.** Trong 30 phút, 13/1.456 dòng có
`N = 1`. Baseline âm 01/11 cho `N = 0` trên 409 khung. Chưa rõ lúc soak có mục
tiêu trước ống kính hay không — **không kết luận** đây là false positive, nhưng
phải ghi nhận vì nếu là false positive thì tỷ lệ 0,9 % là đáng kể.

**(b) `[RING]FPGA pend=1` xuất hiện 4/272 mẫu.** `pend` là frame đã có nhưng chưa
ACK. Với `timeout_ms = 100` và chu kỳ khung 236 ms, `timeout_flag` bật ở mọi khung
như phân tích trước đây, nên `pend` cao tạm thời là **bình thường**, không phải
mất dữ liệu: `byt` vẫn tăng đều và `drop = 0`.

**(c) `USND ... fe=` trong log KHÔNG phải framing error.** Mọi dòng đều có
`fe == byt == isr` (ví dụ `fe=5583 byt=5583 isr=5583`), nên trường này mang nghĩa
khác (số cạnh/echo). Đừng đọc thành lỗi khung như `[RING]`. Nên đổi tên trường
trong firmware log để tránh nhầm.

---

## 5. `F02_card240_run2.bin` — không phải dữ liệu IF-01

3.655 byte, **0** khung hợp lệ, không có `5A A5`, chỉ 4 giá trị byte phân biệt
(`0x00 0x78 0x80 0xF8`). Không phải khung IF-01 ở bất kỳ baud nào. File này
**không dùng làm bằng chứng** cho bất cứ kết luận nào. Nếu nó là ảnh/pixel thô
thì phải ghi rõ nguồn và định dạng trong tên file.

---

## 6. Bảng finding

| ID | Mức | Vị trí | Lỗi | Bằng chứng | Trạng thái |
| :--- | :--- | :--- | :--- | :--- | :--- |
| **F-04** | P2 | `bbox_packetizer.v:76-79,119-135` | Timestamp 4 byte đọc từ counter đang chạy → có thể xé; đo được 1 khung lùi 59 ms | `F02_card_20261102.bin` khung 15 | **MỞ.** Đã sửa trong RTL (`ts_lat`), `tb_bbox_packetizer` 109/109 PASS + phép thử âm cho `0000010a`. **Chưa kiểm được trên bo:** capture 02/11 11:30 chạy nhầm bitstream release (thiếu bản sửa); rev 2 `CA6D5137` có bản sửa nhưng **capture 300 s đang PENDING**. Với 163 khung, P(0 lần xé) = 14,5 % kể cả khi **chưa** sửa — không đủ kết luận. Cần ≥ 409 khung trên bitstream có `ts_lat` |
| **F-05** | P2 | camera OV2640 / `ov2640_config.v` | Nhịp khung lượng tử hoá; giả thuyết frame bị kéo 1/2/3/5/6× do AEC | 128 + 84 khung (IF-01), 151 báo cáo (rev 0) | **MỞ.** Chưa xác nhận được: `P=32,77 ms` (30,52 fps) khớp dữ liệu **y hệt** `P=65,54 ms`; nhóm "1x" thực tế là **68–69 ms**; bucket `other` = **48,3 %** sau khi sửa lỗi tràn 8 bit. Rev 2 thêm bucket **2x** + **short** + **lọc glitch** để phân định — **capture PENDING** |
| **F-06** | **CLOSED** | `[M3]` log của MCU · `main.c:95-106,133-135` | `kvc_millis()` chỉ tăng khi `delay_*` được gọi — thời gian chạy code **không được đếm**. Đo ban đầu: 1.466 s MCU / 1.795 s thực = **0,817** | soak 30 phút | **ĐÃ SỬA + ĐÓNG** (`KVC-MCU-TB-001`): `[INIT] Timebase SYSTICK` trên bo, soak 10 phút cho **ratio 1,0023** (trước 0,8166). Chi tiết: `KVC-MCU-TB-001-20261102-003_SOAK2.md` |
| **F-07** | **CLOSED** | UART1 RX · `kvc_fpga_bbox.c:169-193` | 02/11/2026: trong soak2 `fe == byt == isr` (63/63 mẫu), `BB v = 0` (454/454 dòng) — mọi byte lỗi framing, 0 khung IF-01. **Nguyên nhân: tiếp xúc dây** — trước phiên đó R13 được rút sang CH340 capture, cắm lại bị lệch pin/`GND` chung lỏng | `G2.7_soak2_20261102.txt` + capture sau khi cắm lại | **CLOSED 02/11/2026** — cắm lại `R13`→`JP3 7/8`, `GND`→`J5`: `fe=0`, `BB v1` 100 %, `byt` 40–45 B/s. **Không phải hồi quy timebase**: GNSS cùng priority 2 có `fe=0` trên 24.954 B trong chính phiên hỏng. Chi tiết: `KVC-MCU-TB-001-20261102-003_SOAK2.md` §2 |

Không finding nào trong số này chặn IF-01: **layout/CRC/baud không đổi**, và
`fe=oe=drop=0` suốt 30 phút.
