duyphong375/uav_payload/docs/verification/evidence/KVC-FPGA-BLOB-REV10.md

# KVC-FPGA-BLOB-REV10 — Khôi phục cấu hình đã chạy + `RLE_MIN = 5`

- **Task ID:** `KVC-FPGA-BLOB-REV10`
- **Owner:** Kilo (agent có quyền workspace) · **Model:** DeepSeek
- **Ngày:** 04/11/2026
- **Tiền đề:** rev 8/9 cho `BB n0`; bản `8D2F84DE` (~14:20) đã chạy đúng trên bo
- **Scope:**
  - `KVC_PR/src/processing/kvc_blob_detect.v`
  - `KVC_PR/verification/tb/tb_kvc_blob_detect.v`
  - `docs/verification/FPGA_BUILD_RECORD.md`
  - `docs/verification/evidence/KVC-FPGA-BLOB-REV10.md`
- **Status:** `IMPLEMENTED` · `SIMULATED` (25/25 PASS) · `BUILT` · **chưa `HARDWARE-VERIFIED`**

---

## 1. Dòng thời gian các bản trong ngày

| Giờ | Hash | `RLE_MIN` | `ROW_MIN` | `MIN_PIXELS` | `sat` | `hue_hi` | Kết quả trên bo |
| :--- | :--- | ---: | ---: | ---: | ---: | ---: | :--- |
| 14:14 | `4C74C0EF` | 3 | 6 | 48 | 5B (0,80) | 40° | chưa nạp |
| **~14:20** | **`8D2F84DE`** | **3** | **3** | **20** | **5B (0,80)** | **40°** | **CHẠY ĐÚNG** |
| 14:47 | `034DB01B` | 3 | 3 | 16 | 4B (0,75) | 45° | chưa nạp |
| 15:08 | `4E7C1A59` | 3 | 5 | 36 | 5B (0,80) | 40° | `n0` |
| 15:51 | `19C849D4` | 3 | 3 | 20 | 5B (0,80) | 45° | chưa nạp |
| 16:20 | `B65114B3` | 3 | 4 | 50 | 4B (0,75) | 45° | `n0` |
| 16:43 | `1792FFFB` | 3 | 4 | 20 | 4B (0,75) | 45° | `n0` |
| **16:59** | **`DDB3EDE7`** | **5** | **3** | **20** | **4B (0,75)** | **45°** | **chưa nạp** |

`8D2F84DE` chưa từng được archive vào `review/artifacts/` nên không thể nạp lại.
Build record chỉ ghi được ba tham số hình học của nó: `MIN_PIXELS = 20`,
`ROW_MIN = 3`, `CONF_SHIFT = 4`.

---

## 2. Vì sao rev 8/9 thất bại

Cả hai đổi **nhiều tham số cùng lúc** so với bản đã chạy:

| Thay đổi | Ảnh hưởng |
| :--- | :--- |
| `MIN_PIXELS` 20 → 36/50 | loại 38–63 % khung theo số đo `px_rev5.bin` |
| `ROW_MIN` 3 → 4/5 | chặt hơn, làm giảm thêm |
| `sat_ok` 5B → 4B | nới (không gây `n0`) |
| `hue_hi` 40° → 45° | nới (không gây `n0`) |

Bốn thay đổi cùng lúc khiến không thể quy trách nhiệm cho tham số nào. rev 10
chỉ giữ **một** thay đổi so với bản đã chạy.

---

## 3. Vì sao `RLE_MIN = 5`

### 3.1 Số đo

Trên `px_rev5.bin` (65 khung):

| Đại lượng | Giá trị |
| :--- | ---: |
| `pix_count` trung bình | 62.178 px |
| `cnt_hue_ok` trung bình | 2.678 px |
| **Xác suất pixel khớp** | **p = 4,31 %** |

Số run nhiễu kỳ vọng mỗi frame = `p^r × 62.178`:

| `RLE_MIN` | Run nhiễu/frame | Diễn giải |
| ---: | ---: | :--- |
| **3** | **4,98** | mỗi frame đều có ~5 cụm nhiễu |
| 4 | 0,22 | 1 frame trong 4,5 |
| **5** | **0,009** | 1 frame trong 111 |

### 3.2 Cơ chế gây `N = 0`

`min_x`/`max_x`/`min_y`/`max_y` là **cực trị TOÀN CỤC** trên mọi pixel khớp
(`kvc_blob_detect.v:348-353`). Không có connected-component labeling.

Với `RLE_MIN = 3`, mỗi frame có ~5 cụm nhiễu rải rác. Chỉ cần một cụm ở góc
trên-trái và một ở góc dưới-phải:

```text
box_w = 400 > MAX_SPAN = 255  ->  shape_ok = 0  ->  N = 0
```

Đo trên cả hai capture:

| Capture | `max_px` | `max_py` | `box_w×box_h` | `fill` | Bị `MAX_SPAN` loại |
| :--- | ---: | ---: | ---: | ---: | ---: |
| `px_rev4` | 399 | 98–356 | 400×100…357 | 0,046 % | **42/42** |
| `px_rev5` | 399 | 389 | 400×390 | 0,028 % | **65/65** |

`fill = 0,028 %` nghĩa là hộp bao phình kín khung trong khi chỉ 43 pixel khớp.
Một vật thật phải cho `fill` 30–100 %.

Đây là lý do `n1` chỉ hiện ~10 % số khung: chỉ khi nhiễu tình cờ co cụm lại
trong vùng < 255 px.

### 3.3 Vì sao nắp thật không bị ảnh hưởng

Nắp cam cho run **40+ px mỗi dòng** (10 cm @78 cm → 44 px cạnh). `RLE_MIN = 5`
chỉ cắt các run < 5 px, không đụng tới nắp.

---

## 4. Sửa kèm: `cnt` cộng theo `RLE_MIN`

Code cũ (`kvc_blob_detect.v:348`) cộng **cứng** `19'd3`:

```verilog
if (run3) begin
    cnt <= cnt + 19'd3;   // <-- hang so, khong theo RLE_MIN
```

Nếu chỉ đổi `RLE_MIN` mà không sửa, `cnt` sẽ thiếu `RLE_MIN − 3` pixel cho mỗi
run. Rev 10 dùng:

```verilog
localparam [18:0] RLE_MIN_C19 = RLE_MIN;
...
cnt <= cnt + RLE_MIN_C19;
```

---

## 5. Kiểm chứng

### 5.1 Testbench

```
iverilog -g2012 -o tb.vvp KVC_PR/src/processing/kvc_blob_detect.v \
                            KVC_PR/verification/tb/tb_kvc_blob_detect.v
vvp tb.vvp
```

**`=== SUMMARY: PASS=25 FAIL=0 ===`** · exit code 0

### 5.2 Hai test mới cô lập `RLE_MIN`

| Test | Nội dung | Kỳ vọng |
| :--- | :--- | :--- |
| **11b** | 8 vệt × 4 px/dòng, 40 dòng (run = 4) | **KHÔNG** phát |
| **11c** | 8 vệt × 5 px/dòng, 40 dòng (run = 5) | **PHÁT**, `x=37 y=20 w=75 h=40` |

Hai test này dùng chế độ `dash_mode` mới trong testbench, vẽ vệt ngang cách
đều để cô lập `RLE_MIN` mà không bị `MIN_PIXELS` hay `ASPECT_MAX` ảnh hưởng.

**Kiểm chứng test có thực sự cô lập không:** tôi instantiate DUT riêng với
`RLE_MIN = 4` và bơm đúng mẫu vệt 4 px. Kết quả: `bbox_valid pulses = 1` —
tức với `RLE_MIN = 4` thì vệt 4 px **sẽ** phát. Vậy test 11b (kỳ vọng không
phát) là phép thử thật, không phải test luôn PASS.

### 5.3 `git diff --check`

exit code 0.

---

## 6. Bitstream

| Trường | Giá trị |
| :--- | :--- |
| **Bản bàn giao** | **`review/artifacts/KVC_FPGA_release_DDB3EDE7.fs`** |
| **SHA-256** | **`DDB3EDE74ADC66FC8907DC565E3F62FBE02952B099E7E571976EFB9A7A038861`** |
| Kích thước | 4.620.698 B |
| Top module | `kvc_top_demo` |
| Cấu hình | `BBOX_SOURCE = 1`, `DIAG_MODE = 0` |
| Fmax `clk_100m` | **117,252 MHz** (ràng buộc 100) |
| Fmax `cam_pclk` | **87,412 MHz** (ràng buộc 24) |
| Vi phạm setup / hold | **0 / 0** |
| LUT / Register / DSP | 2.033 (1.799 LUT + 234 ALU + 0 ROM16) / 1.314 / 0,5 |
| Trạng thái | `BUILT` — **CHƯA NẠP** |

---

## 7. ⚠️ Điều kiện tiên quyết: capture phải chứa vật

Ba capture hiện có đều **không** chứng minh được nắp nằm trong khung:

| Capture | Giờ | `mean R8` | `max_r5` | `cnt_match` | Nhận xét |
| :--- | :--- | ---: | ---: | ---: | :--- |
| `px_rev4` | 12:44 | 186,6 | 31 | 36 | có pixel đỏ, nhưng `cnt` ngang nhiễu |
| `px_rev5` | 13:59 | 119,2 | 31 | 43 | có pixel đỏ, `cnt` ngang nhiễu |
| **`lid25`** | **17:16** | **9,8** | **2–12** | **0** | **KHÔNG có pixel đỏ** |

`lid25` có `max_r5 = 2…12` trong khi bình thường là **31**. Nếu nắp cam phủ kín
khung ở 25 cm, `mean R8` phải vào khoảng **200–240**. Thực đo 9,8 — khung hình
gần như không có đỏ.

**Tiêu chí capture hợp lệ:**

| Chỉ số | Phải đạt |
| :--- | :--- |
| `mean R8` | **> 180** |
| `max_r5` | **= 31** |

Không đạt hai ngưỡng này ⇒ nắp chưa ở trong khung ⇒ mọi kết luận về ngưỡng
màu đều vô giá trị.

---

## 8. Chưa sửa: `MAX_SPAN = 255`

`bbox_w`/`bbox_h` là **8 bit** (ABI IF-01), `shape_ok` yêu cầu ≤ 255.

Với nắp 10 cm và `fx = 346 px`:

| Khoảng cách | Cạnh nắp | Kết quả |
| ---: | ---: | :--- |
| 10 cm | 346 px | **luôn `N = 0`** |
| 13 cm | 267 px | **luôn `N = 0`** |
| 14 cm | 247 px | có thể `N = 1` |
| 25 cm | 139 px | có thể `N = 1` |
| 78 cm | 44 px | có thể `N = 1` |

Khoảng cách tối thiểu: `d > fx × size / 255`.

| Nắp | Khoảng cách tối thiểu |
| :--- | ---: |
| 5 cm | 6,8 cm |
| 10 cm | **13,6 cm** |
| 15 cm | 20,4 cm |
| 20 cm | 27,2 cm |

Muốn sửa phải mở `bbox_w`/`bbox_h` lên 10 bit ⇒ **đổi ABI IF-01** ⇒ cần human
approval.

---

## 9. Việc tiếp theo

| # | Việc | Điều kiện |
| :---: | :--- | :--- |
| 1 | Nạp `DDB3EDE7` | xác nhận hash trước |
| 2 | Đặt nắp ở **25–30 cm, giữa khung**, xác nhận bằng mắt | nắp phải phủ phần lớn khung |
| 3 | Nạp diag `373CD916`, capture, kiểm `mean R8 > 180` và `max_r5 = 31` | nếu không đạt, chỉnh vị trí rồi đo lại |
| 4 | Nạp lại `DDB3EDE7`, đo tỉ lệ `n1` khi có nắp / `n0` khi bỏ ra | mong `n1` ≥ 95 % |
| 5 | Nếu `n1` vẫn thấp với capture hợp lệ: xét `MAX_SPAN` (cần approval ABI) | |
| 6 | Đóng F-10 (frame mất 60 % dòng) | tăng pixel khả dụng 2,5× |

**Không làm:** đổi nhiều tham số cùng lúc (đó là lỗi của rev 8/9).
