duyphong375/uav_payload/docs/verification/evidence/KVC-G619-20261103-001.md

# G6.1.9 — Capture đầu tiên trên bo: công cụ chạy, nhưng số đo CHƯA dùng được

- **Ngày đo:** 03/11/2026
- **Bằng chứng:** `evidence/G6.1.9_pixel_test.bin` (4.558 B, **43 khung**, 0 lỗi CRC)
- **Bitstream:** `A92E18B9` — **REV 1** (`kvc_top_diag_pixel`, `DIAG_MODE = 3`).
  Không dùng bản này để hiệu chuẩn ngưỡng; xem §7 cho rev 2.
- **Owner ghi nhận:** Kilo

---

## 1. Công cụ chạy đúng — phần này PASS

| Kiểm tra | Kết quả |
| :--- | :--- |
| Khung IF-01 | **43/43**, 0 lỗi CRC |
| Thứ tự slot (`W = 0..5`) | ✅ đúng trên cả 43 khung |
| `max_r5` đỉnh | **28/31** (R8 ≈ 230) |
| `center_pixel` | Đọc được, giá trị hợp lý |
| Bitstream nhận diện | `N=12` + `W=0..11` + dữ liệu có `max_r5` biến thiên ⇒ đúng bản `A92E18B9` |

**Đường ống hoạt động.** RTL, build, wrapper, tool giải mã đều đúng. Đây là giá
trị thật của phiên này.

---

## 2. Ba lý do số đo CHƯA dùng được để hiệu chuẩn ngưỡng

### 2.1 `pix_count` không phải frame đầy đủ — frame bị cắt

> **ĐÍNH CHÍNH 04/11/2026 — mục này suy đoán sai.** Số "số dòng suy ra (÷800)"
> dưới đây **không** phải phép đo: nó giả định chiều rộng = 800 px mà chưa ai
> đo. Bằng chứng ngược lại nằm ngay trong file này: `center_pixel` **khác 0 ở
> 43/43 khung** — slot 5 chỉ cập nhật khi `px == 320 && py == 240`
> (`pixel_stats.v:213`), nên `py` **đã** tới 240. Nếu frame chỉ có 46–150 dòng
> thì `center_pixel` phải bằng 0 ở mọi khung.
>
> Ngoài ra nếu là VGA 640×480 thì 241 dòng đầu đã cần **154.240** pixel, trong
> khi `pix_count` tối đa chỉ **119.911** — **mâu thuẫn**. Vậy **không kết luận
> được** chiều cao frame từ `pix_count`.
>
> Trạng thái đúng: frame **có thể** thiếu pixel, nhưng **chưa biết** thiếu ở đâu.
> Rev 4 của `pixel_stats.v` thêm `max_px`/`max_py` để trả lời dứt điểm. Chi tiết
> đầy đủ: `KVC-G6.1-20261104-001.md` §4.

| Chỉ số | Giá trị |
| :--- | :--- |
| `pix_count` | 36.668 … 119.911 |
| VGA 640×480 | 307.200 |
| **Tỉ lệ thu được** | **12 % … 39 %** |
| Số dòng suy ra (÷800) | **46 / 50 / 100 / 150** — **suy đoán, không phải đo** |

Camera chỉ xuất **46–150 dòng** thay vì 480 (VGA) hoặc 600 (SVGA). Đây là **cùng
hiện tượng F-04/F-05** (frame bị cắt giữa chừng), không phải lỗi của `pixel_stats`.

**Hệ quả:** trung bình tính trên *phần frame nhận được*, không phải toàn cảnh.
Vật đỏ có thể nằm ngoài phần bị cắt.

### 2.2 Ngưỡng "đỏ đậm" tôi viết CHẶT HƠN ngưỡng blob — không so được

Tôi đặt `RED_R_MIN=26, RED_G_MAX=12, RED_B_MAX=8` với ý định "rộng hơn ngưỡng
blob". **Sai.** So sánh thật:

| Kênh | `kvc_blob_detect.v` | `pixel_stats.v` | Ai chặt hơn |
| :--- | :--- | :--- | :--- |
| R5 | ≥ 20 | **≥ 26** | pixel_stats |
| G6 | **10 … 44** (dải rộng) | **≤ 12** | pixel_stats (chặt hơn nhiều) |
| B5 | ≤ 12 | **≤ 8** | pixel_stats |
| Thêm | `r > g/2+3` **và** `r > b+4` | — | blob |

Blob chấp nhận `G6` tới **44**; tôi chỉ cho tới **12**. Vậy `red_count` **không
phải** `cnt` của blob — nó thấp hơn nhiều.

**Hệ quả:** `red_count` 20–33 **không** chứng minh được gì về F-02. Nó chỉ nói
"có 20–33 pixel rất đỏ", không nói "blob sẽ đếm được bao nhiêu".

Đây là **lỗi thiết kế của tôi** trong phiên trước. Ghi lại để không lặp.

### 2.3 Vật đỏ chỉ chiếm ~21 % khung

`mean_r5 = 5,8/31` trên các frame có `red_count > 0`. Nếu vật đỏ thật sự có
`R5 ≈ 28`:

```text
diện tích vật ≈ 5,8 / 28 ≈ 20,7 %
```

Vật chiếm ~1/5 khung, không phải "phủ kín ≥ 80 %" như hướng dẫn yêu cầu. Kết hợp
với §2.1 (frame bị cắt), phần nhìn thấy càng không đại diện.

---

## 3. Điều dữ liệu này NÓI được (giá trị thật)

| # | Kết luận | Căn cứ |
| :---: | :--- | :--- |
| 1 | `pixel_stats` hoạt động đúng | 43 khung, slot order đúng, `max_r5` biến thiên theo vật |
| 2 | Camera **có** pixel đỏ thật | `max_r5 = 28/31` (R8=230) — vượt xa nền (R5=5) |
| 3 | **Vật đỏ chưa bão hoà** | Max 28/31, không đạt 31/31. Cần đo lại với vật đỏ hơn |
| 4 | Frame bị cắt trên bo | 12–39 % diện tích — **xác nhận độc lập F-04/F-05** |
| 5 | Nền phòng xanh/lục | `mean G8=120, B8=115` vs `R8=48` — ánh sáng huỳnh quang |

**Kết luận #3 đáng chú ý cho F-02:** nếu vật đỏ thật chỉ đạt `R5=28` (R8=230),
thì `R_MIN=20` (R8≈160) của blob **vẫn cho qua**. Ngưỡng R không phải vấn đề.
Vấn đề nằm ở **G6** — blob cho `10..44`, nên nền xanh lục (`G6≈30`) **cũng lọt**,
đó là lý do `cnt` thấp mà bbox lại rộng.

Đây là **giả thuyết mới cho F-02**, có số đo hỗ trợ, nhưng **chưa đủ kết luận**.

---

## 4. Sửa gì trước lần đo sau

| # | Việc | Lý do |
| :---: | :--- | :--- |
| 1 | **`pixel_stats` dùng ĐÚNG ngưỡng blob** | Để `red_count` so sánh trực tiếp được với `cnt`. Làm thành `parameter` khớp `kvc_blob_detect` |
| 2 | **Thêm đếm pixel theo từng điều kiện** | Tách `cnt_r_only`, `cnt_g_ok`, `cnt_b_ok` để biết điều kiện nào loại nhiều nhất |
| 3 | Giải quyết frame bị cắt trước | Số trên frame 20 % không đại diện. Xem F-04/F-05 |
| 4 | Vật đỏ **bão hoà** hơn | `max_r5` phải đạt 31, không phải 28 |
| 5 | Vật phủ ≥ 80 % khung | Hiện ~21 % |

**Ưu tiên #1 và #2** — rẻ, và biến phép đo thành thứ trả lời được câu hỏi F-02.

---

## 5. Điều KHÔNG được suy ra

| Không được nói | Vì sao |
| :--- | :--- |
| "6.1.9 PASS" | Vật chưa phủ kín, chưa bão hoà, frame bị cắt |
| "6.1.9 FAIL" | Cũng chưa — số đo chưa hợp lệ để kết luận theo cả hai chiều |
| "F-02 xác nhận do ngưỡng hẹp" | `red_count` dùng ngưỡng khác blob, không so được |
| "Ngưỡng R đúng" | `max_r5=28` chỉ chứng minh **có** pixel đỏ, chưa chứng minh `R_MIN=20` hợp lý trên toàn dải |
| "Camera xuất VGA" | `pix_count` cho thấy chỉ 46–150 dòng |

---

## 6. Trạng thái

| Mục | Trạng thái |
| :--- | :--- |
| Công cụ `pixel_stats` + build + tool | ✅ **HARDWARE-VERIFIED** (chạy đúng trên bo) |
| **Mục 6.1.9** | ⬜ **NOT RUN** — phép đo hợp lệ chưa thực hiện |
| F-02 | **MỞ** — có hướng mới (nghi `G6`), chưa đủ dữ liệu |
| F-04/F-05 (frame cắt) | **MỞ** — được xác nhận độc lập bởi `pix_count` |

---

## 7. Rev 2 — sửa lỗi thiết kế của rev 1 (03/11/2026)

### 7.1 Vì sao phải làm rev 2

Rev 1 dùng ngưỡng **chặt hơn** blob ở cả ba kênh, nên `red_count` của nó **không
so sánh được** với `cnt` của `kvc_blob_detect`. Đây là lỗi thiết kế (§2.2), không
phải lỗi số đo. Rev 2 sửa đúng ba việc:

| # | Thay đổi | Mục đích |
| :---: | :--- | :--- |
| 1 | Ngưỡng về **đúng** ngưỡng blob: `R_MIN=20`, `G_MIN=10`, `G_MAX=44`, `B_MAX=12` | `cnt_match` so sánh trực tiếp được với `cnt` |
| 2 | Thêm điều kiện trội kênh đỏ `r > g/2+3` **và** `r > b+4` | Blob có hai điều kiện này; thiếu thì `cnt_match` cao hơn `cnt` thật |
| 3 | Slot 6..9 = `cnt_r_ok`, `cnt_g_ok`, `cnt_b_ok`, `cnt_rg_ok` | Biết **kênh nào loại nhiều pixel nhất** — dữ liệu trực tiếp cho F-02 |

Slot 4 đổi từ `red_count` (ngưỡng riêng) sang `cnt_match` (ngưỡng blob).

### 7.2 Bản đồ 12 slot rev 2

| Slot | X | Y | Ý nghĩa |
| ---: | :--- | :--- | :--- |
| 0 | `pix_count[15:0]` | `pix_count[18:16]` | tổng pixel hợp lệ |
| 1 | `sum_r[15:0]` | `sum_r[24:16]` | tổng R5 |
| 2 | `sum_g[15:0]` | `sum_g[24:16]` | tổng G6 |
| 3 | `sum_b[15:0]` | `sum_b[24:16]` | tổng B5 |
| 4 | `cnt_match[15:0]` | `cnt_match[18:16]` | khớp **đủ 4 điều kiện blob** |
| 5 | `center_pixel` | `max_r5` | pixel giữa / R5 lớn nhất |
| 6 | `cnt_r_ok[15:0]` | `cnt_r_ok[18:16]` | chỉ xét `R5 ≥ 20` |
| 7 | `cnt_g_ok[15:0]` | `cnt_g_ok[18:16]` | chỉ xét `10 ≤ G6 ≤ 44` |
| 8 | `cnt_b_ok[15:0]` | `cnt_b_ok[18:16]` | chỉ xét `B5 ≤ 12` |
| 9 | `cnt_rg_ok[15:0]` | `cnt_rg_ok[18:16]` | `R` và `G` cùng đạt |
| 10..11 | — | — | chưa dùng, = 0 |

Byte `W` của mỗi slot = chỉ số slot (0..11) để xác nhận thứ tự.

**Bất biến để kiểm dữ liệu:** `cnt_match ≤ min(cnt_r_ok, cnt_g_ok, cnt_b_ok)`.
Nếu vi phạm, bitstream hoặc đường UART sai — không kết luận.

### 7.3 Bitstream rev 2

| Thông số | Rev 2 |
| :--- | :--- |
| SHA-256 | **`0B125CDC9F570B7230BDF37E490CE7D0947E0885028CFCF59BBA5D713A5B794E`** |
| File | `review/artifacts/KVC_FPGA_diag_pixel_0B125CDC.fs` (7.264.154 B) |
| Top | `kvc_top_diag_pixel` (`DIAG_MODE = 3`, `BBOX_SOURCE = 1`) |
| Fmax `clk_100m` | **118,224 MHz** (ràng buộc 100 MHz), logic level 6, slack setup **+1,542 ns** |
| Fmax `cam_pclk` | **106,249 MHz** (ràng buộc 24 MHz) |
| TNS setup/hold | **0,000 / 0,000**, 0 endpoint vi phạm |
| Tài nguyên | 2.015 LUT-ALU (1.787 LUT + 228 ALU) / 1.452 FF / 1 BSRAM / 0,5 DSP |
| Tool | Gowin V1.9.11.03 Education, GW2A-LV18PG256C8/I7 |
| Mức bằng chứng | **BUILT** — chưa nạp bo |

So với rev 1 (`A92E18B9`, ~122 MHz, 1.854 LUT / 1.311 FF): rev 2 **nhiều hơn
161 LUT và 141 FF**, Fmax **thấp hơn ~4 MHz** nhưng vẫn **cao hơn** ràng buộc
100 MHz. Rev 1 **giữ lại** trong `review/artifacts/` nhưng **đánh dấu rev 1 —
không dùng để hiệu chuẩn**.

### 7.4 Kiểm chứng phần mềm

| Kiểm tra | Kết quả |
| :--- | :--- |
| `tb_pixel_stats` (thêm dòng `#FF0000`) | **20/20 PASS** |
| Toàn bộ testbench FPGA | **25/25 PASS**, exit 0 |
| `pytest tests/integration/test_decode_pixel_diag.py` | **19/19 PASS** |
| `pytest gcs/backend/tests` | **85 passed** |
| Tool giải mã trên capture rev 1 (4.558 B) | nhận diện `rev 1`, **không crash**, exit 2 |

`#FF0000` (đỏ thuần) được thêm vào TB để **chứng minh nó bị loại**: `G6 = 0 <
G_MIN = 10`. Xem §8.

### 7.5 Trạng thái sau rev 2

| Mục | Trạng thái |
| :--- | :--- |
| Rev 2 | **BUILT + SIMULATED** — chưa nạp bo |
| **6.1.9** | vẫn **NOT RUN** cho tới khi có capture rev 2 trên bo |
| Rev 1 (`A92E18B9`) | **giữ, đánh dấu rev 1** — số của nó không dùng cho F-02 |

---

## 8. Ba phát hiện phải giữ (dùng cho lần đo rev 2)

### 8.1 `G_MIN = 10` loại ĐỎ THUẦN — nghịch lý của checklist

`kvc_blob_detect.v:32` đặt `G_MIN = 10`. Pixel `#FF0000` có `G6 = 0`, nên
**blob không bao giờ phát hiện được vật đỏ thuần**. Đã kiểm bằng số:

| Màu | R5 | G6 | B5 | `R≥20` | `10≤G≤44` | `B≤12` | trội đỏ | Khớp blob |
| :--- | ---: | ---: | ---: | :---: | :---: | :---: | :---: | :---: |
| `#FF0000` | 31 | **0** | 0 | ✅ | ❌ | ✅ | ✅ | **KHÔNG** |
| `#FF5500` | 31 | 21 | 0 | ✅ | ✅ | ✅ | ✅ | **CÓ** |
| `#FF8800` | 31 | 33 | 0 | ✅ | ✅ | ✅ | ✅ | **CÓ** |
| `#FFFFFF` | 31 | 63 | 31 | ✅ | ❌ | ❌ | ❌ | KHÔNG |
| `#808080` (xám) | 16 | 32 | 16 | ❌ | ✅ | ❌ | ❌ | KHÔNG |

**Nghịch lý:** `BRINGUP_CHECKLIST.md` 6.1.9 yêu cầu vật "đỏ thuần (G/B <
0x2000)" — tức `G6 ≈ 0..4` — nhưng blob đòi `G6 ≥ 10`. **Vật đúng tiêu chí 6.1.9
là vật blob không thể thấy.**

Giả thuyết mới cho **F-02**: vấn đề nằm ở **dải G**, không phải ngưỡng R. Vật đỏ
thật trong phòng (đo ở §3 mục 3) đạt `R5 = 28` — `R_MIN = 20` vẫn cho qua. Nhưng
nếu `G6` của vật nằm ngoài `10..44` (quá thấp vì đỏ bão hoà, hoặc quá cao vì AWB
đẩy lên), blob loại sạch.

**Hệ quả cho lần đo tới:** phải đo **cả `#FF5500`/`#FF8800` (dải G hợp lệ)** để
có mẫu khớp, và đo `#FF0000` để chứng minh nó bị loại. Chỉ đo đỏ thuần thì
`cnt_match` sẽ bằng 0 và không phân biệt được "ngưỡng sai" với "vật không đỏ".

### 8.2 Frame bị cắt trên bo — 12–39 % diện tích VGA

| Chỉ số | Giá trị |
| :--- | :--- |
| `pix_count` | 36.668 … 119.911 |
| VGA 640×480 | 307.200 |
| **Tỉ lệ thu được** | **11,9 % … 39,0 %** |
| Số dòng suy ra (÷ 800 cột) | **45,8 / 49,9 / 99,8 / 149,9** → 46 / 50 / 100 / 150 dòng |

`pix_count` chia thành **ba nhóm** (không liên tục), tức camera chỉ phát một phần
chiều cao thay vì 480 dòng:

| Nhóm | `pix_count` | Số dòng suy ra (÷ 800 cột) |
| :--- | :--- | :--- |
| Thấp | 36.668 … 41.572 | **46 … 52** |
| Giữa | 79.809 … 79.979 | **100** |
| Cao | 119.736 … 119.911 | **150** |

Đây là **cùng hiện tượng
F-04/F-05**, xác nhận **độc lập** bằng một đường đo khác (`pixel_valid` đếm
trong `pixel_stats`, không phải `bbox_packetizer`).

**Hệ quả:** trung bình trên frame bị cắt **không đại diện cho toàn cảnh**. Vật đỏ
có thể nằm ngoài phần bị cắt. Phải sửa F-04/F-05 trước khi tin `mean_r8/g8/b8`
như số đo toàn frame.

### 8.3 Rev 1 không so sánh được với blob

| Kênh | `kvc_blob_detect.v` | rev 1 | Ai chặt hơn |
| :--- | :--- | :--- | :--- |
| R5 | ≥ 20 | **≥ 26** | rev 1 |
| G6 | **10 … 44** | **≤ 12** | rev 1 (chặt hơn nhiều) |
| B5 | ≤ 12 | **≤ 8** | rev 1 |
| Trội đỏ | `r > g/2+3` **và** `r > b+4` | — | blob |

`red_count` 20–33 của capture cũ **không nói gì** về F-02: nó đếm một tập pixel
hẹp hơn hẳn tập blob chấp nhận. Đây là lỗi thiết kế của rev 1, đã sửa ở rev 2.

### 8.4 Số đo lại trên capture rev 1 (sau khi sửa tool)

Chạy `decode_pixel_diag.py` bản mới trên `G6.1.9_pixel_test.bin`:

| Chỉ số | Giá trị |
| :--- | :--- |
| Khung / CRC | 43 / 0 |
| `pix_count` | 36.668 … 119.911 (4 mức) |
| `mean_r8 / g8 / b8` (frame cuối) | **21 / 117 / 156** |
| `cnt_match` (rev 1 = `red_count`) | 0 ở frame cuối; 8/43 khung khác 0 (20–33) |
| `max_r5` | 5 … 28 |
| Rev nhận diện | **1** ✅ |

`mean_g8 = 117` và `mean_b8 = 156` **cao hơn** `mean_r8 = 21`: nền phòng
xanh/lục chiếm phần lớn khung. Đây là lý do **không** được đọc `mean` như màu
của vật khi vật không phủ kín khung.

**Tool đã sửa xong:** trước đó crash `UnicodeEncodeError` trên console cp1252 ở
dòng in `cùng`; nay có wrapper UTF-8 cho `stdout/stderr`. Có test tái hiện đúng
lỗi cũ (chạy tiến trình con với `PYTHONIOENCODING=cp1252`).
