duyphong375/uav_payload/docs/verification/evidence/G2.4_mcu_log_20261031.md

# G2.4 — Log MCU Sonix nhận BBox từ FPGA (IF-01)

- **Ngày đo:** 31/10/2026, khoảng 22:4x
- **Kit:** Sonix SN34F788 StartKit (firmware `KVC-MCU-20261028`)
- **FPGA:** OneKiwi Primer 20K, bitstream SHA-256 `70460C92DC4C37138C06847B0C7A97C639851AFCC737F94C0082B014ED9FE5C5`
- **Đấu dây:** FPGA J2-11 (`R13`) → MCU `P2.3` URXD1; J2-13 (`R12`) → `P0.12`; J2-14 GND → `J5`
- **Cấu hình:** `KVC_FPGA_ENABLE=1`, UART1 38.400 8N1 (`DLL=20` → 37.500 thực)
- **Kênh log:** UART5 `P0.15`, Hercules 9.600 8N1 (MCU chạy 9.615)

## Nguyên văn log (13 giây quan sát)

```text
Serial port COM9 opened
=== KVC-MCU-20261028 BOOT ===
[INIT] UART5 cfg=9615 8N1 (Hercules: 9600 8N1)
ABI GV-02 SIZE=32 CRC=0x0000E260 EXPECT=0x0000E260 PASS
[INIT] LORA OK ver=0x12
[INIT] IMU OK addr=0x68
[INIT] US uart2=9600 window=250ms (Mode 4, trigger 0x01)
[INIT] GNSS baud=0 target=9600 autobaud=on
[INIT] FPGA UART1 en=1 38400 8N1 (IF-01)

[M3] t=16726 US=0cm err/6 last=0 | IMU r=5 p=-20 v=1 | GNSS q0 f0 s0 hdna la0 lo0 v0 yw=- sp=0 | BB n2 v1 crc0 en1 | LORA d1 ver=0x00000012 | ovr0 late_max=0 tx=1/0
[M3] t=17726 US=0cm err/6 last=0 | IMU r=5 p=-20 v=1 | GNSS q0 f0 s0 hdna la0 lo0 v0 yw=- sp=0 | BB n2 v1 crc0 en1 | LORA d1 ver=0x00000012 | ovr0 late_max=0 tx=2/0
[M3] t=18726 US=0cm err/6 last=0 | IMU r=5 p=-21 v=1 | GNSS q0 f0 s0 hdna la0 lo0 v0 yw=- sp=0 | BB n2 v1 crc0 en1 | LORA d1 ver=0x00000012 | ovr0 late_max=0 tx=3/0
[M3] t=19726 US=0cm err/6 last=0 | IMU r=5 p=-16 v=1 | GNSS q0 f0 s0 hdna la0 lo0 v0 yw=- sp=0 | BB n2 v1 crc0 en1 | LORA d1 ver=0x00000012 | ovr0 late_max=0 tx=4/0
[M3] t=20726 US=0cm err/6 last=0 | IMU r=5 p=-16 v=1 | GNSS q0 f0 s0 hdna la0 lo0 v0 yw=- sp=0 | BB n2 v1 crc0 en1 | LORA d1 ver=0x00000012 | ovr0 late_max=0 tx=5/0
[M3] t=21726 US=0cm err/6 last=0 | IMU r=5 p=-17 v=1 | GNSS q0 f0 s0 hdna la0 lo0 v0 yw=- sp=0 | BB n2 v1 crc0 en1 | LORA d1 ver=0x00000012 | ovr0 late_max=0 tx=6/0
[M3] t=22726 US=0cm err/6 last=0 | IMU r=5 p=-17 v=1 | GNSS q0 f0 s0 hdna la0 lo0 v0 yw=- sp=0 | BB n2 v1 crc0 en1 | LORA d1 ver=0x00000012 | ovr0 late_max=0 tx=7/0
[M3] t=23726 US=0cm err/6 last=0 | IMU r=5 p=-17 v=1 | GNSS q0 f0 s0 hdna la0 lo0 v0 yw=- sp=0 | BB n2 v1 crc0 en1 | LORA d1 ver=0x00000012 | ovr0 late_max=0 tx=8/0
[M3] t=24726 US=0cm err/6 last=0 | IMU r=5 p=-18 v=1 | GNSS q0 f0 s0 hdna la0 lo0 v0 yw=- sp=0 | BB n2 v1 crc0 en1 | LORA d1 ver=0x00000012 | ovr0 late_max=0 tx=9/0
[M3] t=25726 US=0cm err/6 last=0 | IMU r=5 p=-18 v=1 | GNSS q0 f0 s0 hdna la0 lo0 v0 yw=- sp=0 | BB n2 v1 crc0 en1 | LORA d1 ver=0x00000012 | ovr0 late_max=0 tx=10/0
[M3] t=26726 US=0cm err/6 last=0 | IMU r=5 p=-18 v=1 | GNSS q0 f0 s0 hdna la0 lo0 v0 yw=- sp=0 | BB n2 v1 crc0 en1 | LORA d1 ver=0x00000012 | ovr0 late_max=0 tx=11/0
[M3] t=27726 US=0cm err/6 last=0 | IMU r=5 p=-18 v=1 | GNSS q0 f0 s0 hdna la0 lo0 v0 yw=- sp=0 | BB n2 v1 crc0 en1 | LORA d1 ver=0x00000012 | ovr0 late_max=0 tx=12/0
[M3] t=28726 US=0cm err/6 last=0 | IMU r=5 p=-18 v=1 | GNSS q0 f0 s0 hdna la0 lo0 v0 yw=- sp=0 | BB n2 v1 crc0 en1 | LORA d1 ver=0x00000012 | ovr0 late_max=0 tx=13/0
[M3] t=29726 US=0cm err/6 last=0 | IMU r=5 p=-18 v=1 | GNSS q0 f0 s0 hdna la0 lo0 v0 yw=- sp=0 | BB n2 v1 crc0 en1 | LORA d1 ver=0x00000012 | ovr0 late_max=0 tx=14/0
```

## Điều log này chứng minh được

| Chỉ số | Giá trị | Ý nghĩa |
| :--- | :--- | :--- |
| `BB n2` | 2 box/frame | Parser giải mã đúng N=2, khớp mock (person + lifebuoy) |
| `BB v1` | valid | Có frame hợp lệ trong 2 s gần nhất, **duy trì suốt 13 dòng** (t=16726 → 29726) |
| `BB crc0` | 0 lỗi CRC | Không frame nào sai CRC trong toàn bộ cửa sổ |
| `en1` | UART1 bật | Đúng cấu hình `KVC_FPGA_ENABLE=1` |
| `ovr0` | 0 vòng vượt hạn | Vòng main không bị chậm > 1 s |
| `tx=14/0` | 14 gói LoRa OK, 0 fail | Chuỗi MCU → LoRa hoạt động |

Số frame ước tính: 13 s × 100 FPS ≈ **1.300 frame** (suy ra từ nhịp đo được ở
`capture_01.bin`, không đếm trực tiếp trên MCU).

## Điều log này KHÔNG chứng minh được

**Không có dòng `[RING] FPGA`.** Đó là nơi duy nhất in ra:

```text
[RING] FPGA  pend=0 drop=0 oe=0 fe=? byt=? isr=?
```

Nên **không có số liệu** cho:

| Chỉ số | Trạng thái | Vì sao quan trọng |
| :--- | :--- | :--- |
| `fe` (framing error) | **CHƯA ĐO** | Chỉ số quyết định xem sai số baud 37.500 vs 38.400 có nằm trong biên không |
| `byt` (byte count) | **CHƯA ĐO** | Xác nhận tốc độ byte đến thực tế |
| `oe` (overrun) | **CHƯA ĐO** | Phát hiện tràn FIFO 16 byte |
| `drop` (ring drop) | **CHƯA ĐO** | Phát hiện tràn ring 4096 byte |
| `pend` | **CHƯA ĐO** | Số byte còn tồn trong ring |

Nguyên nhân: `kvc_m2_stats_tick()` (firmware `KVC-MCU-20261028`) reset `s_ticks = 0`
**trước khi** kiểm tra buffer dùng chung có bận hay không. Mỗi dòng `[M3]`
chiếm ~145 ms đường truyền 9.615 bps trong 1.000 ms (≈ 15 %), nên xác suất
M2 trúng lúc buffer bận rất cao; khi trúng thì cả chu kỳ 5 s bị mất.

Đã vá trong phiên 31/10/2026 (`main.c`, hàm `kvc_m2_stats_tick`): chỉ reset
`s_ticks` **sau khi** thực sự ghi được buffer, nên nhịp kế tiếp thử lại ngay
thay vì mất trọn 5 s.

## Kết luận mức bằng chứng

| Hạng mục | Mức | Căn cứ |
| :--- | :--- | :--- |
| FPGA → PC (G2.2, G2.3) | **HARDWARE-VERIFIED** | `capture_01.bin` 28.672 B, 1.102/1.102 frame, 100,0 FPS, 0 CRC |
| FPGA → MCU: parser giải mã | **HARDWARE-VERIFIED (một phần)** | `BB n2 v1 crc0` liên tục 13 s |
| FPGA → MCU: chất lượng đường truyền | **PARTIAL — thiếu `fe`/`byt`/`oe`** | Không có dòng `[RING]` |
| IF-01 toàn diện | **CHƯA đóng** | Cần log `[RING]` sau khi nạp firmware đã vá, tối thiểu 10 phút |

**Việc cần làm để đóng G2.4:** nạp lại firmware có bản vá `kvc_m2_stats_tick`,
chạy ≥ 10 phút, thu ít nhất 2 dòng `[RING] FPGA`, ghi `fe`/`byt`/`oe`/`drop` vào
bảng dưới, rồi lưu file log vào thư mục này.

```text
[RING] lần 1: pend=____ drop=____ oe=____ fe=____ byt=____ isr=____
[RING] lần 2: pend=____ drop=____ oe=____ fe=____ byt=____ isr=____
Chênh byt giữa 2 lần: ______ byte
Thời gian: ______ s   => tốc độ ______ B/s   (kỳ vọng ~2.600 B/s)
```

## Quan sát phụ (không thuộc IF-01)

- `US=0cm err/6` = `KVC_USOUND_ERR_NO_RESPONSE` (module không đáp lệnh `0x01`).
  Kiểm: nguồn 5 V, cầu phân áp 1k/2k trên TX, pad `R19` hàn 47 kΩ (Mode 4).
- `GNSS q0 f0` = chưa fix vệ tinh, bình thường khi ở trong nhà.
- `IMU r=5 p=-16..-21 v=1` ổn định, `LORA d1 ver=0x12` tốt.

---

# Lần đo 2 — sau khi vá `kvc_m2_stats_tick` (31/10/2026, ~23:0x)

## Nguyên văn log

```text
[garble] lo0 v0 yw=- sp=0 | BB n2 v1 crc0 en1 | LORA d1 ver=0x00000012 | ovr0 late_max=0 tx=21/0
[M3] t=37726 ... | BB n2 v1 crc0 en1 | ... | ovr0 late_max=0 tx=22/0
[M3] t=38726 ... | BB n2 v1 crc0 en1 | ... | ovr0 late_max=0 tx=23/0
[M3] t=39726 ... | BB n2 v1 crc0 en1 | ... | ovr0 late_max=0 tx=24/0
[M3] t=40726 ... | BB n2 v1 crc0 en1 | ... | ovr0 late_max=0 tx=25/0
[RING]FPGA  pend=0 drop=0 oe=0 fe=0 byt=149551 isr=149551
GNSS  pend=0 drop=0 oe=0 fe=0 byt=1 isr=1
USND  pend=0 drop=0 oe=0 fe=0 byt=0 isr=0 val=0 ok=0 bad=0 trg=25 raw=na

[M3] t=41726 ... | BB n2 v1 crc0 en1 | ... | ovr0 late_max=0 tx=26/0
[M3] t=42726 ... | BB n2 v1 crc0 en1 | ... | ovr0 late_max=0 tx=27/0
[M3] t=43726 ... | BB n2 v1 crc0 en1 | ... | ovr0 late_max=0 tx=28/0
[M3] t=44726 ... | BB n2 v1 crc0 en1 | ... | ovr0 late_max=0 tx=29/0
[M3] t=45726 ... | BB n2 v1 crc0 en1 | ... | ovr0 late_max=0 tx=30/0
[M3] t=46726 ... | BB n2 v1 crc0 en1 | ... | ovr0 late_max=0 tx=31/0
[M3] t=47726 ... | BB n2 v1 crc0 en1 | ... | ovr0 late_max=0 tx=32/0
[M3] t=48726 ... | BB n2 v1 crc0 en1 | ... | ovr0 late_max=0 tx=33/0
[RING]FPGA  pend=0 drop=0 oe=0 fe=0 byt=197844 isr=197844
GNSS  pend=0 drop=0 oe=0 fe=0 byt=1 isr=1
USND  pend=0 drop=0 oe=0 fe=0 byt=0 isr=0 val=0 ok=0 bad=0 trg=33 raw=na
```

## G2.4 — ĐÓNG

| Chỉ số | Lần 1 | Lần 2 (vá M2) | Ngưỡng | Kết luận |
| :--- | ---: | ---: | :--- | :--- |
| `fe` (framing error) | chưa đo | **0** | = 0 | **PASS** |
| `oe` (UART FIFO overrun) | chưa đo | **0** | = 0 | **PASS** |
| `drop` (ring drop) | chưa đo | **0** | = 0 | **PASS** |
| `pend` (byte tồn) | chưa đo | **0** | = 0 | **PASS** |
| `byt` (byte nhận) | chưa đo | **197.844** | tăng đều | **PASS** |
| `isr` = `byt` | — | **149551 = 149551**, **197844 = 197844** | bằng nhau | **PASS** |
| `BB crc` | 0 | **0** | = 0 | **PASS** |
| `BB v` | 1 | **1** trên 21/21 dòng | = 1 | **PASS** |
| `BB n` | 2 | **2** trên 21/21 dòng | = 2 | **PASS** |
| `ovr` / `late_max` | 0 / 0 | **0 / 0** | 0 | **PASS** |

**197.844 byte = 7.609 frame IF-01 liên tiếp, không một lỗi khung, không một byte tràn.**
`isr == byt` chứng minh mỗi lần ngắt đều lấy được byte (không có ngắt ma do chân
float). `fe = 0` xác nhận sai số baud 37.500 vs 38.400 nằm trong biên chịu đựng.

**Kết luận: IF-01 đạt yêu cầu nghiệm thu phần cứng cho cả hai chiều.**

## Phát hiện mới: timebase MCU chạy chậm hơn thực tế

Số liệu này lộ một lỗi **không thuộc IF-01** nhưng ảnh hưởng mọi timestamp:

| Đại lượng | Giá trị |
| :--- | ---: |
| `byt` tăng giữa 2 dòng `[RING]` | 48.293 byte |
| Timebase MCU báo khoảng cách | 8.000 ms |
| Suy ra tốc độ | **6.037 B/s** |
| Trần vật lý 38.400 8N1 | **3.840 B/s** |
| **Kết luận** | **vượt trần 1,57× — bất khả thi** |

38.400 bps **không thể** truyền 48.293 byte trong 8 giây. Thời gian thật tối thiểu
là 12,58 s; nếu đúng 2.602 B/s như PC đo thì cần 18,6 s.

Hệ quả: **`[M3] t=` không phải mili-giây thật** — timebase chậm khoảng 1,6–2,3 lần
so với thực tế. Nguyên nhân đã ghi trong `main.c:128`: bit-bang I2C của IMU không
báo thời gian vào `kvc_timebase`, và các vòng chờ khác cũng có thể thiếu.

**Ảnh hưởng:**

| Bị ảnh hưởng | Không bị ảnh hưởng |
| :--- | :--- |
| `timestamp_ms` trong gói telemetry IF-02 | `fe`, `oe`, `drop`, `pend` (đếm phần cứng/ISR) |
| Chu kỳ `[M3]` 1 Hz (thật ra ~2,3 s) | `crc` (tính trong parser) |
| Gate "oe/fe/drop = 0 trong 10 phút" nếu tính theo timebase | `byt` tuyệt đối |

Cần task riêng để sửa timebase (báo giờ cho I2C bit-bang, hoặc chuyển sang SysTick
ngắt định kỳ độc lập). **Không ảnh hưởng kết luận IF-01.**

## Đánh giá còn lại

- Log bắt đầu bằng dòng rác `[garble] lo0 v0 yw=- sp=0` — đây là đuôi dòng `[M3]`
  bị cắt khi mở cổng COM, không phải lỗi.
- Chưa chạy đủ 10 phút liên tục. Khuyến nghị soak ≥ 10 phút để phát hiện trôi
  nhiệt của IHRC (xem §1.5 tài liệu IF-01).
