duyphong375/uav_payload/docs/verification/evidence/KVC-CAM-DIAG-20261102-001.md

# KVC — Hướng dẫn bitstream CHẨN ĐOÁN TỰ ĐO VSYNC (`DIAG_MODE = 2`)

- **Mã:** `KVC-CAM-DIAG-20261102`
- **Bitstream:** `C82B9EFE7F6D7232867FB552495F8E76BF367D4CCA1DE666473843F9E171764C`
  (`review/artifacts/KVC_FPGA_diag_vsync_C82B9EFE.fs`)
- **Owner:** Kilo · **Ngày:** 02/11/2026
- **Trạng thái bằng chứng:** `BUILT` + `SIMULATED` — **chưa nạp bo, chưa có số đo**
- **Cảnh báo 02/11/2026 11:30:** capture `G6.1_blob_vsyncdiag_20261102-1130.bin`
  **KHÔNG** phải của bitstream này. File đó có 163 khung `N=0`/`N=1` và **không có
  khung `N=10`** nào ⇒ bo đang chạy release `86CCF5DD`, không phải `C82B9EFE`.
  Xem `G6.1_blob_vsyncdiag_20261102-1130.txt` §1. Bitstream này vẫn **chưa được
  kiểm trên phần cứng**.

---

## 1. Bitstream này để làm gì

Bàn thí nghiệm **không có scope/LA**, nên Pha 0 của `KVC-CAM-PCLK-20261102-001`
(bước 0.5: đếm ≥ 200 chu kỳ VSYNC) không thực hiện được bằng dụng cụ ngoài.
Module `vsync_monitor` làm việc đó **bên trong FPGA**, dùng clock 100 MHz làm
tham chiếu, rồi đẩy kết quả ra UART qua khung IF-01 — **không đổi layout, không
đổi CRC, không đổi baud**.

## 2. Nạp và chạy

```powershell
# 1. Nap qua SRAM Program (mat dien la ve bitstream cu)
#    File: review/artifacts/KVC_FPGA_diag_vsync_C82B9EFE.fs

# 2. Thu 40 s de co >= 2 bao cao (cua so 2 s)
python scripts/manual/fpga_uart_capture.py --port COM8 --baud 38400 --seconds 40 `
  --dump docs/verification/evidence/G6.1_blob_vsyncdiag_20261102-HHMM.bin

# 3. Giai ma
python scripts/manual/decode_vsync_diag.py `
  --file docs/verification/evidence/G6.1_blob_vsyncdiag_20261102-HHMM.bin
```

`--seconds 40` chứ không 30: cửa sổ là 2.000 ms, cần ít nhất 2 cửa sổ để thấy
báo cáo ổn định. Ở 4,28 Hz, 40 s cho ~171 xung.

## 3. Đọc kết quả

`decode_vsync_diag.py` in sẵn phần **Kết luận** cho hai câu hỏi. Bảng dưới là
cách tự đọc nếu cần.

### 3.1 Câu hỏi 1 — nhịp VSYNC có đều không?

| Điều kiện | Kết luận | Hành động |
| :--- | :--- | :--- |
| `t_b1x = tổng`, các bucket khác `= 0` | Nhịp **đều ~65,6 ms** | Camera phát 15,25 Hz đều ⇒ **F-05 SAI**; lưới 65,6 ms là alias của timestamp. Quay lại đo exposure |
| `t_b1x > 0` và có bucket khác `> 0` | Nhịp **KHÔNG đều** 1/3/5/6× | **F-05 ĐÚNG** ⇒ xử lý AEC (Pha 0b của PLAN-005) |
| `t_bother = tổng` | Đều nhưng **KHÁC** 65,6 ms | Lưới 65,6 ms là alias. Ghi lại giá trị `w_min_ms`/`w_max_ms` thật |

### 3.2 Câu hỏi 2 — FPGA có rớt frame không?

```text
t_vsync − t_frame  =  số frame bị rớt
```

| Kết quả | Nghĩa | Hành động |
| :--- | :--- | :--- |
| `= 0` | Không rớt | Đường FPGA ↔ camera sạch; FPS thấp là do camera |
| `> 0` | **Rớt frame trong FPGA** | Mở task điều tra `camera_rx` / `blob`; **dừng** PLAN-005 |

`t_frame` lấy từ `bbox_last_raw`, tức là frame **nguồn** phát ra trước khi bị
ghi đè bởi báo cáo chẩn đoán — không phải số bao cáo.

### 3.3 Ví dụ đọc

Giả sử báo cáo cuối cho:

```text
t_vsync        : 2261
t_frame        : 2256
t_b1x/t_b3x    : 9 / 80
t_b5x/t_b6x    : 21 / 17
t_bother       : 40
w_min / w_max  : 67 / 395
```

Đọc là: camera phát **2.261** VSYNC, FPGA phát **2.256** frame ⇒ **rớt 5**
(0,2 %). Trong 167 chu kỳ đo được, **9** chu kỳ ~65 ms, **80** chu kỳ ~197 ms,
**21** ~328 ms, **17** ~394 ms, **40** ngoài bucket ⇒ nhịp **không đều**, xác
nhận F-05. Nhưng 40 chu kỳ `other` (24 %) là điểm **chưa giải thích được** —
cần xem `w_min_ms`/`w_max_ms` thật để biết chúng rơi ở đâu.

> Đây là **ví dụ minh hoạ cách đọc**, không phải số đo. Đừng trích vào báo cáo.

## 4. Ràng buộc kỹ thuật đã kiểm

| Hạng mục | Kết quả |
| :--- | :--- |
| **Fmax `clk_100m`** | **105,030 MHz**, TNS setup & hold = 0 |
| **Fmax `cam_pclk`** | **167,628 MHz**, TNS = 0 |
| Tài nguyên | 2.437 LUT / 2.100 FF / 1 BSRAM / 0,5 DSP |
| Đường tới hạn | `bbox_packetizer` 11,757 ns (**không** phải `vsync_monitor`) |
| Testbench | **24/24 PASS** (suite đầy đủ) |

Bản `vsync_monitor` đầu tiên đo bằng `now_ms − prev_ms` (trừ 32 bit) và cho
Fmax **100,153 MHz** — chỉ hơn ngưỡng 0,15 %. Đổi sang bộ đếm reset-theo-VSYNC
đưa Fmax lên 105,030 MHz và giảm 234 LUT. **Không** quay lại cách trừ 32 bit.

## 5. Giới hạn của phương pháp

1. **Không đo được PCLK.** Bitstream này đo **VSYNC**, không đo `cam_pclk`. Muốn
   biết PCLK phải đếm byte giữa hai HREF — chưa làm.
2. **Không đo được exposure.** Chỉ suy ra từ phân bố chu kỳ. AEC và chia xung
   cho cùng một phân bố rời rạc; phép phân biệt là **`t_bother`**: nếu mọi chu kỳ
   đều là bội số của cùng một P thì đó là chia xung, không phải AEC.
3. **Clock tham chiếu là `clk_100m` từ PLL nội.** Nếu PLL sai thì mọi số đều
   sai theo cùng tỷ lệ. Nhưng timestamp IF-01 đã khớp wall-clock trong nhiều
   phiên, nên `clk_100m` được coi là đúng.
4. **Cửa sổ 2 s ở 4,28 Hz chỉ có ~8 xung.** Đọc **bản tích luyện** (`t_*`) khi
   cần kết luận; bản cửa sổ (`w_*`) chỉ để xem xu hướng tức thời.
5. **Chưa nạp bo.** Mọi kết luận ở trên là `BUILT` + `SIMULATED`.

## 6. Sửa F-04 trong cùng bitstream

`bbox_packetizer.v` đã chốt `timestamp` vào `ts_lat` tại `start`. Test
`tb_bbox_packetizer` có 3 case F-04, và **phép thử âm** (tạm bỏ latch) cho:

```text
FAIL F-04: ts phat ra = 0000010a, phai = 000000ff (bi xe)
FAIL F-04: ts phat ra = 0001000a, phai = 0000ffff (bi xe)
FAIL F-04: ts phat ra = 0100000a, phai = 00ffffff (bi xe)
```

Đúng kiểu xé timestamp quan sát được trên bo (`728063 → 728004`). Với latch:
**109/109 PASS**, timestamp phát ra đúng giá trị tại `start` dù counter đổi
50 lần trong lúc phát.

> **Bitstream này KHÔNG sửa lỗi nào khác.** `MIN_PIXELS`, ngưỡng màu RGB565,
> `camera_rx`, `ov2640_config` đều giữ nguyên. Đây là điều kiện để kết quả đo
> quy được trách nhiệm.
