duyphong375/uav_payload/docs/verification/evidence/KVC-F02-G27-20261102-001.md

# Track B — F-02 (ngưỡng màu) + G2.7 soak 30 phút

- **Task:** `KVC-FPGA-F02-001`, `KVC-MCU-SOAK-001`
- **Ngày đo:** 02/11/2026, 03:02:31 – 03:32:31 (+07)
- **Người thực hiện:** HUMAN (thao tác bo), ghi nhận bởi Kilo
- **Git HEAD:** `2be0f05…` + working tree dirty (H6 chưa đóng)

---

## 1. F-02 — `PASS` về mặt phương pháp, `FAIL` về mặt phát hiện

### 1.1 Thiết lập

| Trường | Giá trị |
| :--- | :--- |
| Cổng | COM8, 38400 8N1 |
| Bitstream | release `86CCF5DD` (SRAM) |
| Vật thử | **Thẻ cam ~240×240 px** (đúng khuyến nghị, dưới `MAX_SPAN=255`) |
| Script | `fpga_uart_capture.py --seconds 20` |
| Bằng chứng | `evidence/F02_card240_20261102.bin` (**920 byte**) |

**Kiểm số học:** 74 khung × 10 B + 10 khung × 18 B = 740 + 180 = **920 B** ✅ khớp
đúng kích thước file và số byte báo cáo (84 khung, 100 % byte trong khung, 0 rác).

### 1.2 Kết quả

| Chỉ số | Giá trị |
| :--- | :--- |
| Khung hợp lệ | **84 / 84** (100 %) |
| Byte rác | 0 |
| Lỗi CRC | **0** |
| Nhịp khung | 4,2 frame/s |
| Khung có `N=1` | **10 / 84 (11,9 %)** |
| `class` | 2 (`lifebuoy`) |
| `x` | 194–195 |
| `y` | 164–165 |
| `w` | **221–243** (khung #59: 226, #69: 223) |
| `h` | **50–200** (khung #59: 200, #69: 198) |
| `conf` | **6–9** (khung #59: 8, #69: 7) |

### 1.3 Kết luận F-02

**Giả thuyết "lấp đầy thấp" bị BÁC BỎ.** BBox 226×200 = **45.200 px²**, chiếm
~14,7 % khung. Nhưng `cnt` chỉ **384–576** pixel khớp (= `conf << 6`):

| Đại lượng | Giá trị |
| :--- | :--- |
| Diện tích BBox | 45.200 px² |
| `cnt` (pixel khớp màu) | 384–576 |
| **Tỉ lệ lấp đầy** | **0,85–1,3 %** |
| Ngưỡng `MIN_PIXELS` | 400 |
| Biên an toàn | chỉ **1,0–1,4×** |
| Khung phát hiện | 11,9 % |

**Nguyên nhân gốc là NGƯỠNG MÀU, không phải kích thước.** Thẻ cam đặc phủ
14,7 % khung nhưng chỉ ~1 % pixel thoả điều kiện màu.

Xác nhận bằng số: 74/84 khung (88,1 %) trả `N=0` vì `cnt < 400`. 10 khung còn
lại vừa trên ngưỡng nên lọt. Đây là phát hiện **sát ngưỡng**, không ổn định.

### 1.4 Bằng chứng cho giả thuyết AWB

Ngưỡng tĩnh trong `kvc_blob_detect.v:31-34`:

```verilog
R_MIN = 20   (R5 >= 20  → ~160/255)
G_MIN = 10   (G6 >= 10  → ~40/255)
G_MAX = 44   (G6 <= 44  → ~176/255)
B_MAX = 12   (B5 <= 12  → ~96/255)
```

Điều kiện `#FF5500` (cam tươi): R=255, G=85, B=0.
- RGB565: R5=31, G6=21, B5=0 → **thoả cả bốn**
- Nhưng **AWB của OV2640** dịch điểm trắng theo nội dung khung. Khi trong khung
  có ít màu bão hoà, AWB kéo gain R xuống và G/B lên → R5 giảm dưới 20 hoặc
  B5 vượt 12.

Đây là **suy luận có căn cứ** (`cnt` thấp đúng trên vật màu đậm), **chưa phải
phép đo AWB**. Muốn xác nhận phải đọc thanh ghi AWB qua SCCB hoặc tắt AWB rồi
đo lại.

### 1.5 Đề xuất (chưa làm, cần HUMAN duyệt)

| # | Việc | Đánh giá |
| :---: | :--- | :--- |
| 1 | **Khoá AWB** qua SCCB (ghi `0x00` vào COM22/COM23 hoặc dùng `AWB_GAIN`) | Rẻ, thử trước. Rủi ro: màu lệch ở điều kiện sáng khác |
| 2 | **Hạ `MIN_PIXELS`** từ 400 → 200 | Rẻ nhưng che vấn đề, không sửa gốc. Tăng dương tính giả |
| 3 | **Hue sector** thay ngưỡng RGB tĩnh | Đúng hướng nhưng là thay đổi RTL: cần build lại, 22 TB, Fmax. **Không làm trong phiên này** |

Thứ tự: **#1 trước** (không đổi RTL, đo được ngay), chỉ sang #3 nếu #1 không đủ.

> **Không sửa ngưỡng màu trong phiên này.** Chưa có phép đo AWB, và đổi RTL phải
> build lại + chạy 22 TB. Sửa theo triệu chứng là sửa mù — cùng nguyên tắc đã
> áp dụng cho F-01.

---

## 2. G2.7 Soak — `PASS 2/3`, và F-06 được nâng lên P1

### 2.1 Thiết lập

| Trường | Giá trị |
| :--- | :--- |
| Cổng | COM9, 9600 8N1 (9615 thực) |
| Thời lượng | **30,00 phút** (03:02:31 → 03:32:31) |
| Script | `soak_mcu_log.py --minutes 30` |
| Bằng chứng | `evidence/G2.7_soak_20261102.txt` (2.278 dòng) |

### 2.2 Kết quả kiểm chéo (tự tính lại từ file, không chép báo cáo)

| Chỉ số | Giá trị | Cách kiểm |
| :--- | :--- | :--- |
| Mẫu `[RING]` | **272** | đếm dòng |
| Mẫu `[M3]` | 1.456 | đếm dòng |
| Cửa sổ `[RING]` | 9,07 s → 1.797,47 s = **1.788 s** | mốc đầu/cuối |
| `byt` | 14.972 → 91.722 = **76.750 B** | khớp báo cáo ✅ |
| `fe` / `oe` / `drop` | **0 / 0 / 0** ở mẫu cuối | |
| `isr == byt` | ✅ | |
| `tx` | 225 → 1.691 = **1.466 gói**, `fail=0` | |
| FPS đầu → cuối | 4,19 → 4,26 khung/s = **+1,7 %** | 27 mẫu mỗi đầu |
| `ovr` / `late_max` | 0 / 0 ms | |

### 2.3 Bảng tiêu chí

| # | Tiêu chí 2.7.x | Kết quả | Ghi chú |
| :---: | :--- | :--- | :--- |
| 2.7.1 | 30 phút, 0 reset, 0 tràn ring | **PASS** | 1.788 s, 0 reset, `fe=oe=drop=0` |
| 2.7.2 | Nhiệt FPGA < 60 °C | **NOT MEASURED** | Cảm nhận tay không thay phép đo |
| 2.7.3 | FPS không giảm > 5 % | **PASS** | +1,7 % (tăng nhẹ, không giảm) |

**Kết luận: G2.7 = PASS 2/3.** Không đóng tuyệt đối vì thiếu 2.7.2.

### 2.4 F-06 bổ sung: timebase MCU chạy CHẬM 18,3 %, và vì sao chắc chắn đây không phải jitter USB

> **Không phải finding mới.** `KVC-FPGA-BLOB-20261102-001.md` §3.1 đã ghi F-06
> (P3) cho cùng hiện tượng, nhưng **cố ý không kết luận** vì chưa loại trừ được
> khả năng mốc wall-clock bên PC bị USB gom gói. Phần dưới đây **giải quyết**
> điểm treo đó bằng cách đọc source, và vì vậy **nâng F-06 từ P3 lên P1**.

Tự tính lại từ chính file bằng chứng:

| Đại lượng | Giá trị |
| :--- | :--- |
| Cửa sổ wall-clock (PC) | **1.795,2 s** |
| Cửa sổ theo `[M3] t=` (MCU) | **1.466,0 s** |
| **Tỉ lệ MCU / thực** | **0,8166** |
| **Drift tích luỹ 30 phút** | **329,2 s (5,5 phút)** |
| Quy về 10 phút | **110 s** |
| Ngưỡng plan B4 | **< 50 ms / 10 phút** |
| **Vượt ngưỡng** | **~2.200 lần** |

**Chu kỳ `[M3]` theo wall-clock:**

| Vị trí | Đo được | Kỳ vọng |
| :--- | :--- | :--- |
| 20 mẫu đầu | **1,479 s** | 1,000 s |
| 20 mẫu cuối | **1,166 s** | 1,000 s |
| Trung bình toàn phiên | **1,220 s** | 1,000 s |

Drift theo từng đoạn 5 phút: 0,740 / 0,811 / 0,839 / 0,856 / 0,842 / 0,823.
Không phải hằng số.

#### Vì sao KHÔNG phải jitter USB

Lập luận trong F-06 cũ (P3) là: USB CH340 gom gói nên mốc `[ 1795.2]` do PC in
có thể trễ, và độ trễ đó đủ để tạo tỉ lệ 0,82 sai. **Đọc source bác bỏ điều này:**

```c
/* main.c:95-106 */
static void delay_ms(uint32_t ms) {
    while (ms--) {
        SysTick->LOAD = (12000000UL / 1000UL) - 1UL;
        /* ... chờ COUNTFLAG ... */
        kvc_timebase_add_ms(1U);      // ← chỉ tăng khi ai đó GỌI delay_ms
    }
}

/* main.c:133-135 */
static uint32_t kvc_millis(void) { return kvc_timebase_ms(); }
```

`kvc_millis()` **không đọc timer**. Nó trả về một biến đếm phần mềm, chỉ tăng
khi `delay_ms()` hoặc `kvc_usound_delay_us()` được gọi. Thời gian CPU dùng để
chạy code thật (poll cảm biến, tính georef, ghi log, chờ SPI LoRa) **không được
đếm**.

Đã kiểm `kvc_timebase_add_us` xuất hiện ở đâu:

| Nơi | Có gọi? |
| :--- | :--- |
| `firmware/mcu_payload/src/kvc_timebase.c:25` | định nghĩa |
| `firmware/mcu_payload/tests/test_kvc_timebase.c` | 5 lần — **chỉ trong test** |
| Firmware production | **0 lần** |

Vậy cả hai đường cộng dồn đều phụ thuộc việc code có đi qua `delay_*` hay
không. Đây là **thiếu hụt có hệ thống trong thiết kế timebase**, không phải
nhiễu đo.

**Kiểm chéo độc lập — chứng minh jitter USB không giải thích được:**

| Bằng chứng | Suy ra |
| :--- | :--- |
| Jitter USB chỉ làm **trễ** mốc, tức làm wall-clock **dài hơn** thực | Nếu chỉ do jitter, wall phải **lớn hơn** MCU — đúng chiều |
| Nhưng jitter không thể tạo **tỉ lệ ổn định 0,82** trên **1.456 mẫu** | Jitter là ngẫu nhiên, không tạo được bias hệ thống |
| `min 0,14 s / max 3,93 s` giữa hai dòng liên tiếp | Đúng là có jitter, nhưng nó **dao động quanh** giá trị trung bình, không dồn một chiều |
| Drift **thay đổi theo tải** (0,740 → 0,856) | Khớp giả thuyết "thời gian chạy code không được đếm"; jitter USB không biết tải CPU |

Nói cách khác: jitter USB có thật và làm **nhiễu** phép đo, nhưng **không thể**
tạo sai lệch hệ thống 18 % trên 1.456 mẫu. Nguyên nhân gốc là `kvc_millis()`
không đếm thời gian chạy code.

**Điều vẫn chưa loại trừ được (giữ trung thực):** chưa tách được bao nhiêu phần
trăm trong 18,3 % là do IHRC 12 MHz ±2 % (ghi trong comment `main.c:123`) và bao
nhiêu là do thời gian không được đếm. Muốn tách phải so `[M3] t` với
`frame_timestamp` của FPGA (hiện không in ra) hoặc dùng 1PPS GNSS. **Nhưng dù
chia thế nào, trần sai số của IHRC là ±2 %, không đủ giải thích 18,3 %.**

**Ảnh hưởng:**

| Đối tượng | Ảnh hưởng |
| :--- | :--- |
| `timestamp_ms` IF-02 | **SAI ~18 %** — GCS hiển thị lệch, expiry/TDM sai |
| Ngưỡng staleness GNSS (3000 ms) | Thực tế còn ~2.450 ms → Yaw hết hạn sớm hơn |
| `KVC_FPGA_TIMEOUT_MS` (2000 ms) | Thực tế còn ~1.634 ms → dễ báo mất frame giả |
| Chu kỳ telemetry danh nghĩa 1 Hz | Thực tế **0,82 Hz** |
| `late_max = 0`, `ovr = 0` | **Không đáng tin** — đo bằng chính đồng hồ bị lỗi |

**Vì sao `late_max = 0` vẫn báo:** vòng chờ so `kvc_millis()` với
`cycle_start_ms`, cả hai cùng từ đồng hồ phần mềm. Đồng hồ chậm bao nhiêu thì
cả hai chậm bấy nhiêu, hiệu số luôn ~1000 ms. **Tiêu chí "chu kỳ 1 Hz" không
kiểm được gì khi dùng đồng hồ bị lỗi làm chuẩn.**

**Vì sao chỉ lộ ra bây giờ:** mọi phép đo trước đều đọc `t=` do MCU tự in. Chỉ
khi có soak 30 phút với **mốc wall-clock độc lập** mới so được hai đồng hồ.

**Chưa sửa.** Đây là task `KVC-MCU-TB-001` (plan B4) — phải đổi nguồn thời gian
sang timer phần cứng free-running, không phải sửa một dòng.

### 2.5 Vì sao G2.7 vẫn có giá trị dù F-06 tồn tại

G2.7 kiểm **tính toàn vẹn đường truyền**, không kiểm đồng hồ:

- `fe = 0` trên 76.750 byte ⇒ baud 38400 đúng, không nhiễu ✅
- `oe = 0` ⇒ FIFO 16 B không tràn ✅
- `drop = 0` ⇒ ring phần mềm không tràn ✅
- `isr == byt` ⇒ không mất byte giữa ngắt và ring ✅
- 0 reset trong 30 phút ⇒ không crash, không watchdog ✅
- `tx_fail = 0` trên 1.466 gói ⇒ đường LoRa ổn định ✅

**Các kết luận này độc lập với F-06.** G2.7 PASS là đúng — nhưng **không** được
suy ra "định thời 1 Hz đúng".

---

## 3. Việc đã cập nhật hồ sơ

| File | Nội dung |
| :--- | :--- |
| `BRINGUP_CHECKLIST.md` 2.7.1 | `PASS` + đường dẫn evidence |
| `BRINGUP_CHECKLIST.md` 2.7.2 | `NOT MEASURED` (giữ, không đánh PASS) |
| `BRINGUP_CHECKLIST.md` 2.7.3 | `PASS` + số liệu |
| `INDEX.md` VER-003 | `G2.7 = PASS 2/3` |
| `evidence/README.md` | Đăng ký 2 file mới |
| **File này** | F-02 + G2.7 + **F-06** |

---

## 4. Điều KHÔNG được suy ra

| Không được nói | Vì sao |
| :--- | :--- |
| "F-02 đã đóng" | Ngưỡng màu vẫn hẹp; thẻ cam đặc chỉ đạt 1 % lấp đầy. AWB chưa đo |
| "Blob phát hiện ổn định" | 11,9 % khung, sát ngưỡng `MIN_PIXELS` |
| "Định thời 1 Hz đúng" | **SAI** — F-06, thực tế 0,82 Hz |
| "`timestamp_ms` IF-02 đúng" | **SAI 18 %** — chưa sửa `KVC-MCU-TB-001` |
| "Soak chứng minh đồng hồ ổn" | Soak chứng minh **đường truyền** ổn, không phải đồng hồ |
| "G2.7 đóng hoàn toàn" | Thiếu 2.7.2 (nhiệt) |
