duyphong375/uav_payload/docs/verification/evidence/KVC-FPGA-BLOB-20261101-001_T1-T13.md

# KVC-FPGA-BLOB-20261101-001 — Bằng chứng thực hiện (T1–T13)

- **Ngày:** 01/11/2026
- **Task:** `KVC-FPGA-BLOB-20261101-001`, các bước T1–T13 của plan
  `.kilo/plans/1793469962520-fpga-blob-real-bbox.md`
- **Owner:** Kilo (agent/công cụ), model `deepseek-ai/deepseek-v4.1-flash-1017`
- **Git HEAD khi thực hiện:** `2be0f05f92a0a31e0bd80d237eff2da939995e78`
  (working tree có thay đổi chưa commit — đúng với trạng thái bàn giao)
- **Mức bằng chứng:** `SIMULATED` + `BUILT`. **Không phải**
  `HARDWARE-VERIFIED`. Chưa nạp bo, chưa có capture UART thật.
- **Review:** **CHƯA CÓ REVIEW ĐỘC LẬP.** Người dùng đã quyết định bỏ qua
  (01/11/2026). Toàn bộ kiểm chứng dưới đây là **self-check của owner**, không
  được coi là approval. Không nâng mức bằng chứng cho tới khi có capture trên
  bo.

---

## 1. Tóm tắt

| Hạng mục | Kết quả |
| :--- | :--- |
| Testbench | **22 PASS, 0 FAIL, 0 SKIP** (`scripts/run_fpga_tb.ps1`, exit 0) |
| Build release (`BBOX_SOURCE=1, DIAG_MODE=0`) | OK, exit 0 |
| Fmax `clk_100m` | **113,277 MHz** (constraint 100 MHz) — dư 13,3 % |
| Fmax `cam_pclk` | **140,757 MHz** (constraint 24 MHz) |
| TNS setup/hold | **0,000 / 0,000** trên cả ba clock |
| LUT | 1.616 / 20.736 (8 %) |
| Register | 1.218 / 16.173 (8 %) |
| BSRAM | 1 / 46 (3 %) — **không tăng**, blob chỉ dùng thanh ghi |
| DSP | 0,5 / 24 (3 %) — **không tăng**, chỉ là `data_ready_ctrl` sẵn có |
| SHA-256 bitstream release | `86CCF5DDAA12DED9D66C9729E27EBB828FF3A3D2B1B46170E79B61277C38ED13` |
| SHA-256 bitstream diag (G0.1) | `3620B802C010993DCF98E56691C5496132CB5347D6776D5B5EAA88BD5DFC5EBB` |

Build release được chạy **hai lần từ cùng source** (`814A9987` và `86CCF5DD`);
timing và tài nguyên giống hệt, chỉ SHA khác — đúng hiện tượng PnR không tất
định đã ghi ở `FPGA_BUILD_RECORD.md` §7.

## 2. File thay đổi

### 2.1 File mới

| File | Nội dung |
| :--- | :--- |
| `KVC_PR/src/processing/kvc_blob_detect.v` | Module phát hiện blob (304 dòng) |
| `KVC_PR/verification/tb/tb_kvc_blob_detect.v` | Unit test, 12 kịch bản |
| `KVC_PR/verification/tb/tb_kvc_top_blob.v` | Integration test qua top-level |

### 2.2 File sửa

| File | Sửa |
| :--- | :--- |
| `KVC_PR/src/kvc_top_demo.v` | `USE_MOCK_BBOX` → `parameter BBOX_SOURCE` (0 mock / 1 blob / 2 CNN); `DIAG_VSYNC_IN_X` → `parameter DIAG_MODE` + ghi đè Y = `{14'd0,cfg_error,cfg_done}`; thêm generate `g_blob_gen`; mux 3 nguồn; drive CNN net = 0 ở nhánh không dùng CNN để hết `EX1998` |
| `KVC_PR/KVC_FPGA.gprj` | Thêm `src/processing/kvc_blob_detect.v` |
| `KVC_PR/constraints/kvc_top_demo.sdc` | Thêm `set_false_path -from cam_pclk -to clk_100m` |
| `scripts/run_fpga_tb.ps1` | Thêm 2 entry TB (20 → 22) |
| 4 TB cũ | Override `#(.BBOX_SOURCE(0), .DIAG_MODE(...))` |

## 3. Testbench

| TB | PASS | Nội dung |
| :--- | ---: | :--- |
| `tb_kvc_blob_detect` | 12 | 10 kịch bản plan + hồi phục sau skip + nguồn gốc |
| `tb_kvc_top_blob` | 8 | Blob thật → IF-01: N=1, x=130 y=80 w=60 h=40 class=2 conf=37; khung rỗng N=0; R7 |

Hai bổ sung so với 8 kịch bản trong plan §11:

- **Test 9** (25×25 = 625 px, span 24) — chứng minh `MAX_SPAN` không chặn oan
  blob nhỏ, tức `MIN_PIXELS` không phải cổng duy nhất.
- **Test 10** (20×20 = 400 px đúng bằng `MIN_PIXELS`) — chặn biên `>=` vs `>`
  bị đảo khi refactor.

## 4. Khác biệt so với plan (có lý do)

### 4.1 Công thức hộp bao

Plan §7.3 ghi `q_w = span_x = max-min` và `q_x = (min+max)>>1`. Với khối rộng
100 px tại x∈[200,299], công thức đó cho `w=99, x=249`, **lệch so với chính
bảng kỳ vọng của plan** (`w=100, x=250`). Module dùng định nghĩa hình học:

```verilog
w = max - min + 1
x = (min + max + 1) >> 1
```

Nhờ vậy `w <= MAX_SPAN` bảo đảm W/H 8-bit không bị cắt, và test 1 khớp bảng.

### 4.2 `frame_valid` không dùng trực tiếp được

`camera_rx.frame_valid` chỉ cao trong lúc `vsync` cao (duty < 2 %), vì
`camera_rx.v:95,121` hạ nó khi `vsync` xuống. Nếu `kvc_blob_detect` dùng trực
tiếp tín hiệu này làm cổng tích lũy, **không pixel nào được đếm**. Module chốt
`frame_valid` vào `frame_active` tại **cạnh xuống VSYNC** rồi dùng cờ đó suốt
frame. Đã kiểm bằng test 8/8b.

### 4.3 Thêm `bbox_last` cho frame rỗng

Plan yêu cầu "0 hoặc 1 bbox/frame" và "tgl đảo mỗi VSYNC rising". Nếu frame
rỗng mà không phát `bbox_last`, packetizer không bao giờ `start` → MCU không
nhận được gì, mất khả năng phân biệt "không có phao" với "FPGA chết". Module
phát `bbox_last` một mình khi `q_valid = 0`, cho khung N=0 (8 header + 2 CRC =
10 byte). Layout IF-01 không đổi.

### 4.4 `tgl` chỉ đảo khi frame có pixel

Nếu camera ngừng quét (VSYNC nhiễu hoặc mất XCLK), `vsync_rising` vẫn có thể
xuất hiện. Đảo `tgl` vô điều kiện sẽ phát khung N=0 liên tục, trông giống
"camera sống, không thấy phao" — sai. Module chỉ đảo khi `frame_seen = 1`, tức
đã thực sự nhận pixel trong frame đó.

## 5. Cảnh báo của tool sau build

| Mã | Nội dung | Đánh giá |
| :--- | :--- | :--- |
| `CV0016` ×1 | `spi_miso` không dùng | Đúng thiết kế (không cóCNN/SPI ở chế độ blob) |
| `CK3000` | Không tính được quan hệ `cam_pclk` ↔ `clk_100m` | Đúng — hai clock bất đồng bộ; đã có `set_clock_groups` + `set_false_path` |
| `PR1014` | `cam_pclk_d` dùng generic routing clock | **Không đổi so với bitstream trước**. Ở 24 MHz (`cam_pclk` Fmax 140,757 MHz) biên rất rộng. Cần xem lại nếu nâng tần số hoặc kéo dài dây camera |

**Đã hết `EX1998`** (8 cảnh báo net không driver cho `cnn_out_*`) bằng cách
gán 0 ở nhánh `g_mock_path`.

Không có cảnh báo trùng constraint của `set_false_path`; không có cảnh báo
đường không được constrain mới.

## 6. Gate G0.1 (T12) — build diag

| Task | Kết quả |
| :--- | :--- |
| G0.1 — `gw_sh tools/build_kvc_fpga.tcl` với `BBOX_SOURCE=0, DIAG_MODE=1` | ✅ **BUILT**, exit 0. SHA `3620B802C010993DCF98E56691C5496132CB5347D6776D5B5EAA88BD5DFC5EBB`. Fmax `clk_100m` 127,823 MHz / `cam_pclk` 170,149 MHz, TNS 0. LUT 1.349, Register 839, BSRAM 1, DSP 0,5 |
| G0.2 — nạp `.fs` | **NOT RUN** |
| G0.3 — capture UART ≥ 10 s, kỳ vọng `x` tăng 27–33/giây | **NOT RUN** |
| G0.4 — đọc `y` của bbox 1, kỳ vọng `y = 1` | **NOT RUN** |

**Lưu ý khi thực hiện G0.3/G0.4:** build diag không chứa `kvc_blob_detect`
(`BBOX_SOURCE=0`), nên `cam_href`/`cam_data` không dùng — Gowin báo `CV0016` cho
hai cổng này. Đó là đúng thiết kế: build diag chỉ để trả lời "camera có phát
VSYNC và SCCB có ACK không", không phải để kiểm blob.

Sau khi G0 PASS, phải **nạp lại bitstream release `86CCF5DD`** (build diag không
có blob). Hai file được giữ ở `review/artifacts/`.

## 7. Việc chưa làm (T14, T15)

| Task | Trạng thái | Lý do |
| :--- | :--- | :--- |
| T14 — nạp bo + A1–A10 | **NOT RUN** | Không có phần cứng trong phiên |
| T15 — capture `.bin` | **NOT RUN** | Phụ thuộc T14 |

Rollback: bản `948D697E...` (mock, camera-capable) đã được giữ tại
`review/artifacts/KVC_FPGA_948D697E.fs` (thư mục `review/` nằm trong `.gitignore`).

## 8. Giới hạn đã biết — phải ghi vào tài liệu nghiệm thu

| # | Giới hạn | Nguồn |
| :--- | :--- | :--- |
| 1 | Da người (200,160,120) → RGB565 (25,40,15) **lọt ngưỡng** → false positive | Plan §8 |
| 2 | `W/H` là 8-bit, không biểu diễn span > 255 px; cần khoảng cách ≥ 1,6 m | Plan H3 |
| 3 | Chỉ 1 blob/frame; nhiều vật cam gộp thành một hộp bao | Plan §2 |
| 4 | `CONF_SHIFT = 6` cho conf thấp (phao 130 px → conf 2). Cần tinh chỉnh sau A2 | Bàn giao |
| 5 | Ngưỡng màu là **ước lượng**, chưa đo dưới nắng thật | Plan R3 |
