duyphong375/uav_payload/docs/verification/evidence/KVC-FPGA-G0G6-20261101-001.md

# Track B trên bo thật — G0 (gián tiếp) + G6.1 (pixel thật → blob → IF-01)

- **Task:** `KVC-FPGA-G0-001` (B1), `KVC-FPGA-G6-001` (B2)
- **Ngày đo:** 01/11/2026 (Asia/Saigon)
- **Người thực hiện:** HUMAN (đo trên bo), ghi nhận bởi Kilo
- **Mức bằng chứng:** **`HARDWARE-VERIFIED`** cho *"pixel OV2640 thật → kvc_blob_detect
  → khung IF-01 hợp lệ CRC"*. **KHÔNG** `HARDWARE-VERIFIED` cho A8 (nhịp khung) và
  cho G6.1 §6.1.9 (ngưỡng màu).
- **Git HEAD:** `2be0f05f92a0a31e0bd80d237eff2da939995e78` + working tree dirty
  (H6 chưa đóng — HUMAN quyết định giữ nguyên)

---

## 1. Thiết lập đo

| Trường | Giá trị |
| :--- | :--- |
| Kit | FPGA Gowin **GW2A-18C** trên OneKiwi **Primer 20K** |
| Camera | **OV2640** (cắm qua FPC 24 chân, XCLK 24 MHz từ `J1-12/B13`) |
| Bitstream | **`86CCF5DD…`** — bản **RELEASE**, `BBOX_SOURCE=1`, `DIAG_MODE=0` |
| Nạp | Gowin Programmer, **SRAM Program** |
| Cổng đo | **COM8**, USB-UART **CH340**, baud **38400 8N1** |
| Dây | `R13` (J2 pin 11) → RX; GND chung |
| Script | `scripts/manual/fpga_uart_capture.py` |
| MCU Sonix | **KHÔNG nối** trong lần đo này |

**Lưu ý quan trọng về cấu hình:** lần này nạp **release**, không phải bản diag
`3620B802`. Hệ quả ở §4.

---

## 2. Kết quả đo

### 2.1 Nền (không có mục tiêu)

| Chỉ số | Giá trị |
| :--- | :--- |
| Số khung hợp lệ | **67** |
| Byte nhận | **670** = 67 × 10 |
| Byte trong khung | **100,0 %** |
| Byte rác | **0** |
| Lỗi CRC | **0** |
| `N` | **0** ở toàn bộ 67 khung |
| Timestamp | tăng đơn điệu, ~**197 ms/khung** |
| Nhịp khung | **~4,5–5,1 khung/s** |

### 2.2 Có mục tiêu (màn hình phát màu cam `#FF5500`)

| Chỉ số | Giá trị |
| :--- | :--- |
| Số khung hợp lệ | **69** |
| Byte nhận | **746** = 62 × 10 + 7 × 18 |
| Byte trong khung | **100,0 %** |
| Byte rác | **0** |
| Lỗi CRC | **0** |
| Khung `N = 1` | **7 / 69** (10,1 %) |
| Khung `N = 0` | 62 / 69 |
| `class` | **2** (`lifebuoy`) ở cả 7 khung |
| `x` | 202 … 211 |
| `y` | 80 … 92 |
| `w` | 236 … 253 |
| `h` | 50 … 56 |
| `conf` | 9 … 12 % |

**Kiểm tra số học:** 62 × 10 + 7 × 18 = 620 + 126 = **746** — khớp đúng số byte
nhận được, 0 byte rác. Đây là dấu hiệu mạnh cho thấy bộ tách khung phía PC tách
đúng layout IF-01, không phải "đọc được gì cũng tính".

---

## 3. Điều bằng chứng này CHỨNG MINH

| # | Kết luận | Vì sao chắc chắn |
| :---: | :--- | :--- |
| 1 | **OV2640 phát pixel thật vào FPGA** | `86CCF5DD` có `BBOX_SOURCE=1` → đường dữ liệu là `blob_sel`, **không** phải `mock_sel`. Không có mạch nào khác sinh ra bbox này |
| 2 | **SCCB cấu hình sensor thành công** | Sensor không được cấu hình thì không phát DVP; không có DVP thì `frame_seen` không bật và không có khung nào được phát |
| 3 | **VSYNC / HREF / PCLK tới FPGA thật** | `kvc_blob_detect` chỉ phát khi `tgl` đảo, mà `tgl` chỉ đảo khi `frame_seen`, tức khi đã có `pixel_valid` trong một frame `frame_active` |
| 4 | **BBox phụ thuộc PIXEL, không phải hằng số** | `N` chuyển 0 → 1 khi đưa mục tiêu vào, và 62 khung còn lại vẫn `N = 0`. Nếu là hằng số thì `N` không đổi |
| 5 | **Đúng layout IF-01** | Khung `N=1` đo được đúng **18 byte**, khung `N=0` đúng **10 byte**; 746 = 62×10 + 7×18 |
| 6 | **`class_id = 2` (lifebuoy) đúng IF-01/IF-02** | `CLASS_LIFEBUOY = 8'd2` trong `kvc_blob_detect.v:62` |
| 7 | **CRC-16/CCITT-FALSE đúng, 0 lỗi** | Trên **136 khung** (01/11) + **409 khung** (02/11) = **545 khung**, 0 lỗi |
| 8 | **Timestamp FPGA đúng đơn vị ms** | `MS_DIV = 100_000` tại 100 MHz; nhịp ~197 ms là số hợp lý, không tràn như lỗi trước 01/11 |
| 9 | **Hình học hộp bao khớp công thức đã sửa** | `w = max−min+1`, `x = (min+max+1)>>1`; `w ≤ MAX_SPAN = 255` được tôn trọng (w max 253) |
| 10 | **Đường blob → packetizer → UART TX hoạt động end-to-end** | 136 khung liên tiếp (01/11) + 409 khung (02/11), 0 byte rác, 0 CRC |

Đây là **lần đầu tiên** đường blob thật được chứng minh trên phần cứng. Trước đó
chỉ có `SIMULATED` (`tb_kvc_blob_detect` 12/12, `tb_kvc_top_blob` 8/8).

---

## 4. Điều bằng chứng này KHÔNG chứng minh

### 4.1 G0.3 / G0.4 chưa chạy đúng thủ tục

`BRINGUP_CHECKLIST.md` §6.1.8b định nghĩa G0.3/G0.4 dựa trên **bitstream diag
`3620B802`** (`BBOX_SOURCE=0, DIAG_MODE=1`), trong đó trường `x` **bị ghi đè**
bằng bộ đếm VSYNC và `y` bằng trạng thái SCCB.

Lần đo này dùng **release `86CCF5DD`** (`DIAG_MODE=0`), nên:

- `x`, `y` là **toạ độ bbox thật**, không phải số đếm chẩn đoán.
- **Không thể** đọc "x tăng 27–33/giây" hay "y = 1" từ capture này.

**Nhưng:** hai sự thật mà G0.3/G0.4 muốn chứng minh lại được chứng minh **mạnh
hơn** bằng đường khác:

| Gate | Cách G0 định nghĩa | Cách lần đo này chứng minh | Đánh giá |
| :--- | :--- | :--- | :--- |
| G0.3 (có VSYNC) | `x` tăng đều | 136 khung IF-01 liên tiếp, mỗi khung ~197 ms, chỉ phát khi có pixel thật | **Mạnh hơn** — số khung thật tốt hơn bộ đếm |
| G0.4 (SCCB OK) | `y = 1` | Sensor phát DVP được ⇒ SCCB đã cấu hình xong | **Mạnh hơn** — hệ quả trực tiếp |

Kết luận: **G0.3 và G0.4 coi như ĐẠT về mặt kỹ thuật**, nhưng ghi rõ là *đạt
qua đường release, không qua thủ tục diag*. Nếu cần bản ghi đúng thủ tục cho hồ
sơ, nạp `3620B802` và capture thêm một lần — chi phí thấp.

### 4.2 G6.1 §6.1.9 (ngưỡng màu) chưa đo

Checklist yêu cầu: *"Chụp vật đỏ thuần, R > 0xF000, G/B < 0x2000"*. Đây là phép
đo **giá trị màu RGB565**, không phải phép đo blob. Lần này không đo.

Bằng chứng thu được (**target cam → 1 bbox**) là loại bằng chứng **khác và có giá
trị hơn**, nhưng **không thay thế** §6.1.9. Ghi `6.1.9 = NOT RUN`.

### 4.3 A8 (nhịp khung 25–32 frame/s) **KHÔNG ĐẠT**

| | Giá trị |
| :--- | :--- |
| Plan A8 yêu cầu | **25–32 frame/s** |
| Đo 01/11/2026 (ánh sáng yếu) | **5,08 frame/s** (197 ms/khung) |
| Đo 02/11/2026 (sáng hơn) | **7,48 frame/s** (133,7 ms/khung) |
| Kết luận | **FAIL / NOT MET** ở cả hai lần |

Hai lần đo cùng bitstream, cùng script, khác ánh sáng ⇒ nhịp khung **phụ thuộc
điều kiện sáng**. Nhưng cả hai đều cách ngưỡng 25–32 rất xa, nên **không thể**
quy toàn bộ khoảng cách cho AEC. Cần kiểm chia tần PCLK và cửa sổ zoom (F-01 ứng
viên 2 và 3).

Đây là finding **F-01**, xem §5.

### 4.4 Các mục A khác

| Mục | Yêu cầu | Trạng thái |
| :--- | :--- | :--- |
| A1 | che ống kính 10 s → `n=0` | **Tương đương** — nền không mục tiêu cho `N=0` trên 67 khung, nhưng không phải "che kính" |
| A2 | phao cam → `n=1`, `class=2` | **PASS** |
| A3 | di chuyển mục tiêu → `x` thay đổi | **NOT RUN** (chỉ có một vị trí) |
| A4 | ra khỏi khung → `n=0` | **Một phần** (thứ tự ngược: nền trước, mục tiêu sau) |
| A5 | áo cam ngoài khung → `w<255` | **NOT RUN** (chưa thử áo cam) |
| A6 | `crc_err=0` / 1.000 frame | **Một phần** — 0 lỗi trên **136 + 409 = 545** frame (01–02/11), vẫn < 1.000 |
| A7 | `fe=oe=drop=0` | **NOT RUN** — cần nối MCU |
| A8 | 25–32 frame/s | **FAIL** — xem F-01 |
| A9 | LUT < 1.800, BSRAM = 0, DSP = 0 | **Chưa đọc lại** — hồ sơ ghi 1.616 LUT / 1 BSRAM / 0,5 DSP, **vượt cả hai ngưỡng** |
| A10 | Fmax ≥ 100 MHz, TNS = 0 | **Đạt theo hồ sơ build** (113,277 MHz, TNS 0) |

> **A9 đáng chú ý:** hồ sơ build ghi `BSRAM = 1` và `DSP = 0,5`, trong khi plan
> yêu cầu `BSRAM = 0, DSP = 0`. Đây là **lệch hồ sơ**, chưa phải lỗi chức năng,
> nhưng phải sửa lại tiêu chí hoặc giải thích. Xem F-03.

---

## 5. Findings

### F-01 (P2) — Nhịp khung ~5 frame/s, thấp hơn kỳ vọng 25–32

**Bằng chứng:** timestamp FPGA tăng ~197 ms/khung trên cả hai lần đo (67 và 69
khung); 1000 × 66 / 13002 ≈ **5,08 frame/s**.

**Ảnh hưởng thực tế:**

| Ảnh hưởng | Mức độ |
| :--- | :--- |
| Băng thông IF-01 | **Không phải vấn đề** — 10–18 byte @ 5 Hz = 50–90 B/s, rất xa trần 3.840 B/s |
| `KVC_FPGA_TIMEOUT_MS` phía MCU | **Không phải vấn đề** — 197 ms ≪ 2.000 ms |
| Cập nhật vị trí mục tiêu | **5 Hz**, không phải 30 Hz. Với UAV tìm kiếm thì chấp nhận được, nhưng phải ghi rõ trong tài liệu thay vì giả định 30 Hz |
| Giả định tải UART 68 % trong tài liệu | **Sai** — thực tế thấp hơn nhiều. An toàn dư, nhưng con số trong docs không còn đúng |

**Chưa xác định nguyên nhân.** Các ứng viên cần kiểm, theo thứ tự rẻ nhất:

1. **Phơi sáng/AGC (khả năng cao nhất).** Trong ánh sáng yếu OV2640 tự kéo dài
   thời gian phơi → giảm khung/giây. Kiểm: chiếu sáng mạnh hơn rồi đo lại.
   Nếu fps tăng → xác nhận.
2. **Chia tần PCLK.** `ov2640_config.v:365-370` đặt `CLKRC = 0x87` (clk_div = 7)
   và `R_DVP_SP = 0x88`. Cần đối chiếu với bảng frame-rate của OV2640 datasheet.
3. **Cửa sổ SVGA → zoom 640×480.** Đang chạy SVGA rồi downscale; nếu cửa sổ/zoom
   đặt sai, frame rate có thể bị chia.

**Cập nhật 02/11/2026 — đo lại trong điều kiện sáng hơn:** **7,48 frame/s**
(133,7 ms/khung, 409 khung). Cùng bitstream `86CCF5DD`, cùng script; chỉ khác ánh
sáng. So với 5,08 frame/s lần trước ⇒ **nhịp khung thay đổi theo ánh sáng**, củng
cố giả thuyết AEC ở ứng viên 1. Chi tiết:
`evidence/G6.1_blob_baseline_neg_20261102-0142.txt`.

Đây là **suy luận từ hai điểm đo**, chưa phải phép đo exposure. Vẫn **không sửa
gì**: muốn kết luận cần đo ở ≥ 3 mức sáng và ghi lại điều kiện chiếu sáng.

**Hệ quả cho tiêu chí A8:** dù 5,08 hay 7,48 frame/s, cả hai đều **FAIL** ngưỡng
25–32. Khoảng cách quá lớn để giải thích bằng ánh sáng đơn thuần; cần kiểm thêm
ứng viên 2 và 3.

### F-02 (P2) — Phát hiện biên: `conf` 9–12 %, chỉ 7/69 khung

**Bằng chứng:** `conf = cnt >> 6` (`kvc_blob_detect.v:207`) với trần 100.

| Suy ra | Giá trị |
| :--- | :--- |
| `conf` 9 … 12 | `cnt` ∈ **[576, 831]** pixel khớp |
| Diện tích hộp `w×h` | 236×50 … 253×56 ≈ **11.800–14.200 px** |
| **Tỉ lệ lấp đầy** | **≈ 5–7 %** |
| Ngưỡng `MIN_PIXELS` | **400** → `cnt` chỉ cao hơn ngưỡng **1,4–2,1 lần** |
| Số khung có mục tiêu | **7 / 69 (10,1 %)** |

**Diễn giải:** hộp bao rộng 236–253 px nhưng chỉ ~600–800 pixel khớp màu. Nếu là
một khối cam đặc phủ kín hộp thì `cnt` phải ~12.000 (conf bão hoà 100). Vậy vùng
khớp là **một dải/strip mảnh**, không phải khối đặc — có thể là **mép màn hình**
hoặc dải màu, không phải toàn bộ màn hình cam.

**Ảnh hưởng:** đây là phát hiện **sát ngưỡng**. Chỉ cần ánh sáng đổi nhẹ hoặc cân
bằng trắng trôi là `cnt` rơi dưới 400 → mất phát hiện. Một mục tiêu cứu hộ cần
được phát hiện trên **phần lớn** khung, không phải 10 %.

**Chưa kết luận đây là bug.** Có thể màn hình chỉ chiếm một dải trong khung nhìn.
Cần một phép thử sạch: **tấm bìa cam đặc, lấp đầy 1/3 khung hình**, rồi đọc
`w`, `h`, `conf`. Nếu `conf` vẫn thấp thì là vấn đề ngưỡng màu.

### F-03 (P3) — Tiêu chí A9 trong plan mâu thuẫn với hồ sơ build

Plan A9 ghi `LUT < 1.800, BSRAM = 0, DSP = 0`. `FPGA_BUILD_RECORD.md` §1 ghi
**1.616 LUT / 1 BSRAM / 0,5 DSP**. Vậy A9 **không đạt** đúng như viết.

Nhiều khả năng tiêu chí A9 được viết cho `kvc_blob_detect` (0 BSRAM) nhưng con số
trong hồ sơ là **toàn top-level** (có BSRAM cho buffer camera/mock). Cần sửa tiêu
chí thành "phần tăng thêm so với baseline" thay vì số tuyệt đối.

---

## 6. Việc cập nhật hồ sơ đã thực hiện

| File | Mục | Nội dung |
| :--- | :--- | :--- |
| `docs/verification/FPGA_BUILD_RECORD.md` | §8 | G0.2–G0.4 và A1–A10 chuyển sang trạng thái đo thật |
| `docs/verification/BRINGUP_CHECKLIST.md` | §6.1 | Cập nhật 6.1.8 và thêm ghi chú G6.1 đạt qua đường blob |
| `docs/verification/BRINGUP_CHECKLIST.md` | §6.2 | Gỡ `BLOCKED` (AJ-SR04M đã hoạt động theo HUMAN), giữ các mục đo là `NOT RUN` |
| `docs/INDEX.md` | dòng VER-003/VER-004 | Mức bằng chứng + ngày |
| `docs/verification/evidence/README.md` | bảng | Thêm dòng cho file này |

---

## 7. Đề xuất bước tiếp theo

Xem câu trả lời trong phiên: nối `R13` → `P2.3` để kiểm IF-01 trên MCU là bước
đúng và rẻ, **nhưng** phải chấp nhận trước rằng **georef sẽ trả `NONE`** khi
không có GNSS fix và không có Yaw (quyết định H4). Giá trị của phép thử là
`fe`/`crc`/`N`/`AI_DETECTED` và khung LoRa 32 byte, **không** phải toạ độ thật.
