duyphong375/uav_payload/docs/verification/evidence/KVC-S3CAM-20261101-001_A3-A5.md

# IF-05 — Relay video: sửa lệch trạng thái, nhịp publish, boundary + công cụ đo

- **Task:** `KVC-S3CAM-004` (A3), `KVC-S3CAM-005` (A4), `KVC-S3CAM-006` (A5)
- **Ngày:** 01/11/2026 (Asia/Saigon)
- **Owner:** Kilo — model/provider `deepseek-ai/deepseek-v4.1-flash-1017`
- **Loại bằng chứng:** `SOURCE-VERIFIED + SIMULATED`. **Không** `HARDWARE-VERIFIED`.
- **Lý do:** chưa có module ESP32-S3-CAM. Mọi kết quả dưới đây chạy trên host với
  camera TCP giả qua loopback.
- **Git HEAD khi làm:** `2be0f05f92a0a31e0bd80d237eff2da939995e78` (working tree
  có thay đổi chưa commit — xem `docs/verification/FPGA_BUILD_RECORD.md:18`)

---

## 1. Việc đã làm

| # | File | Thay đổi | Vì sao |
| :---: | :--- | :--- | :--- |
| 1 | `gcs/backend/video_relay.py` | `status()` tính `last_frame_age_ms` từ `_last_frame_at` trên đồng hồ relay | Trước đó luôn `None`, trong khi `MissionStore.video_with_age()` tính tuổi khác → hai nguồn lệch nhau |
| 2 | `gcs/backend/state.py` | `_apply` neo `times["video"] = now_ms() - reported_age` | Một nguồn tuổi duy nhất; `video_with_age()` cộng thêm thời gian trôi, không reset về 0 |
| 3 | `gcs/backend/video_relay.py` | Nhịp publish `VIDEO_STATUS` theo `_STATUS_INTERVAL_SEC = 1.0` thay cho `frame_count % 30` | Nhịp cũ phụ thuộc FPS thực tế: FPS cao phát dồn, FPS thấp im lặng đúng lúc cần biết khung cuối cũ |
| 4 | `gcs/backend/video_relay.py` + `gcs/backend/main.py` | Hằng `BOUNDARY` dùng chung; header phát `boundary=<token>` (bỏ `--`) | RFC 2046: tham số `boundary=` là token, dấu phân cách trên dây là `--` + token. Trước đó header sai dạng và hardcode ở hai nơi |
| 5 | `gcs/backend/main.py` | Xóa comment sai "kết nối duy nhất", xóa biến `hub` không dùng, ghi rõ `1 + số_người_xem` kết nối | Comment cũ mô tả sai kiến trúc |
| 6 | `gcs/backend/tests/test_video_relay.py` | Thêm 7 test: tuổi khung đo được, neo vào store, `None` khi chưa có khung, camera giả chạy dài, reconnect sau khi đóng stream, lỗi kết nối có `error_message` | A3 yêu cầu "test camera giả chạy dài + reconnect" |
| 7 | `gcs/frontend/src/features/video/VideoPanel.tsx` | `hasStream` chặn `<img src="">`; REAL không cấu hình IF-05 hiện "Chưa có nguồn video" thay vì pattern giả; bỏ chữ "BBOX ĐỒNG BỘ"; `onError` theo URL thay vì cờ kẹt vĩnh viễn; sửa `infoTip` sai | REAL + video NONE đang hiển thị pattern mô phỏng như ảnh thật; nhãn "ĐỒNG BỘ" trái với §2.3 IF-05 |
| 8 | `gcs/frontend/src/features/video/VideoPanel.test.tsx` | **Mới** — 6 test cho nhãn/hành vi panel | A4 trước chỉ có 1 test gián tiếp qua `RealityVerification.test.tsx` |
| 9 | `gcs/frontend/src/state/missionReducer.test.ts` | Thêm 4 test: REAL+video NONE, `source_type` không kẹt MOCK, chỉ RELAY mới LIVE | Ca biên plan nêu ở A4 mục 5 chưa được phủ |
| 10 | `scripts/manual/measure_mjpeg_stream.py` | **Mới** — client MJPEG đo thật, xuất CSV | A5 cần số đo, không suy từ `frame_count` |
| 11 | `docs/interfaces/IF_ESP32_CAM_GCS.md`, `docs/configuration/DASHBOARD_BACKEND.md`, `docs/INDEX.md`, `docs/architecture/KVC_DUAL_CAMERA_DESIGN_PROPOSAL.md` | Sửa §3.1/§3.3/§3.4/§5/§6/§7; ghi `1 + viewers`; số test thực | Tài liệu đang ghi số cũ và mô tả sai kiến trúc |

---

## 2. Lệnh đã chạy và kết quả

Tất cả chạy trong workspace, ngày 01/11/2026.

| Lệnh | Exit | Kết quả |
| :--- | :---: | :--- |
| `.venv/Scripts/python.exe -B -m pytest gcs/backend/tests/test_video_relay.py -q -p no:cacheprovider` | 0 | **22 passed** (sau khi thêm 2 test khung cắt/vượt trần ở phiên A1) |
| `.venv/Scripts/python.exe -B -m pytest gcs/backend/tests -q -p no:cacheprovider` | 0 | **84 passed** (sau A1) |
| `cd gcs/frontend; npm test` | 0 | **173 passed / 27 file** |
| `cd gcs/frontend; npm run typecheck` | 0 | không output |
| `cd gcs/frontend; npm run lint` | 0 | 10 warning có sẵn ở file không sửa; **0 error** |
| `cd gcs/frontend; npm run build` | 0 | `✓ built in 652ms` |
| `.venv/Scripts/python.exe -B scripts/manual/measure_mjpeg_stream.py --fake-camera --seconds 6 --warmup 1` | 0 | **TỰ KIỂM**: 29,75 khung/s trên nguồn 30 khung/s |
| Chunked decoder, cắt chunk ở mọi vị trí (test cục bộ) | 0 | khớp bản gốc; 3 khung liên tiếp tách đúng |

**Cập nhật 01/11/2026 (phiên A1):** lỗi P1 **L-01** trong `FrameExtractor` (ghép
khung bị cắt thành khung hỏng) đã được phát hiện và sửa. Chi tiết:
`KVC-S3CAM-20261101-002_A1.md` §3. Số test backend tăng 65 → 84.

**Ghi chú về lint:** 10 warning đều ở `Map2DView.tsx`, `ThemeProvider.tsx`,
`MissionProvider.tsx`, `routes.tsx`, `badge.tsx`, `button.tsx`,
`LocalRadarPanel.tsx` — không file nào thuộc allowed files của task này. Không
thêm warning mới.

---

## 3. Điều KHÔNG được suy ra từ bằng chứng này

| Không được nói | Vì sao |
| :--- | :--- |
| "Video HARDWARE-VERIFIED" | Chưa có module ESP32-S3-CAM; mọi kết nối là loopback |
| "Camera chịu được 2 client" | Chưa đo. Hạ tầng cho phép `1 + viewers`, chưa có số về giới hạn thật |
| "FPS của kênh video là X" | Script tự kiểm chạy trên camera giả. Số thật chỉ có sau A5 với phần cứng |
| "Độ trễ end-to-end" | Chưa đo; phải quay slow-motion điện thoại + cảnh thật |
| "`has_overlay` sẽ bật" | Vẫn `false`; cần cơ chế ghép cặp khung + HUMAN duyệt |

---

## 4. Việc chưa làm (giữ `NOT RUN`)

| Việc | Lý do |
| :--- | :--- |
| A0 — chốt biến thể S3-CAM | Chưa có hàng (H2/Q3) |
| A1 — firmware S3 phát MJPEG | Chưa có module; chưa chọn writer (Q4) |
| A2 — topology mạng | Chưa chốt (H3/Q2) |
| A5 — đo camera thật | Chưa có thiết bị. Công cụ đã sẵn sàng |
| A6 — nguồn/nhiệt/cơ khí | Cần thiết bị đo |
| A7 — fault injection trên bo thật | Cần S3 + C3 cùng phiên |
| B0–B7 (Track B) | Cần bo + người thao tác; xem `FPGA_BUILD_RECORD.md` §8 |

---

## 5. Rủi ro đã biết sau thay đổi này

| # | Rủi ro | Ghi chú |
| :---: | :--- | :--- |
| 1 | `last_frame_age_ms` giờ là số thật, không còn `None` | UI nào đang kỳ vọng `None` sẽ thấy số. `missionReducer` đã xử lý cả hai |
| 2 | Nhịp publish 1 Hz thay vì mỗi 30 khung | Ở 30 FPS, tần suất gần như không đổi (1,0 s so với 1,0 s); ở 5 FPS, cũ tốn 6 s mới publish một lần — giờ là 1 s |
| 3 | `boundary` bỏ `--` trong header | Client nào hardcode chuỗi header cũ sẽ lệch. Backend không parse boundary nên không ảnh hưởng nội bộ; VLC/trình duyệt cần đúng dạng RFC |
| 4 | REAL không còn hiện pattern khi thiếu IF-05 | Đây là hành vi mong muốn, nhưng thay đổi hình ảnh so với trước |
