duyphong375/uav_payload/docs/verification/evidence/KVC-S3CAM-20261101-002_A1.md

# A1 — Firmware ESP32-S3-CAM (IF-05) + hợp đồng dây dẫn với backend

- **Task:** `KVC-S3CAM-A1` (A1), kèm bổ sung cho A3/A5
- **Ngày:** 01/11/2026 (Asia/Saigon)
- **Owner:** Kilo — model/provider `deepseek-ai/deepseek-v4.1-flash-1017`
- **Loại bằng chứng:** `SOURCE-VERIFIED` + `BUILT`. **Không** `HARDWARE-VERIFIED`.
- **Lý do:** Chưa nạp firmware lên module. Build xanh chỉ chứng minh mã biên dịch
  được cho `esp32s3`, **không** chứng minh OV3660 nhận cấu hình.
- **Git HEAD:** `2be0f05f92a0a31e0bd80d237eff2da939995e78` + working tree dirty
  (H6 chưa đóng — HUMAN quyết định 01/11/2026 giữ nguyên)

---

## 1. Quyết định HUMAN đã chốt trong phiên này

| Mã | Nội dung chốt |
| :--- | :--- |
| **H1** | **Phê duyệt** kiến trúc hai camera. S3-CAM là camera quan sát phụ (`RELAY`), **không sinh tọa độ**. FPGA + OV2640 là nguồn tọa độ **duy nhất** |
| **H2** | Module **ESP32-S3-CAM + OV3660 3 MP** |
| **H3** | Hotspot **2.4 GHz laptop/router**. S3 **STA**. C3 **USB Serial** trực tiếp |
| **H4** | Đứng yên → **`N/A`**, không marker/tọa độ giả |
| **H5** | Rail **5 V riêng** LM2596 **600–800 mA**, gá chống rung, **không câu GPIO** |
| **H6** | **Giữ nguyên** working tree chưa commit |
| **Bổ sung** | **AJ-SR04M đã hoạt động ổn định — Gate G6.2 UNBLOCKED** |

Ghi chú về G6.2: mở khoá G6.2 **không** đổi kết luận H4. Có `alt_dist_cm` thật
vẫn không có Yaw khi đứng yên (vận tốc GNSS = 0 → `kvc_gnss_neo_m10.c` từ chối
Yaw), nên georef vẫn trả `KVC_GEO_POS_NONE`. `N/A` vẫn là hành vi đúng.

---

## 2. File đã tạo/sửa

| # | File | Loại | Nội dung |
| :---: | :--- | :--- | :--- |
| 1 | `firmware/esp32_s3_cam/platformio.ini` | mới | Board N16R8, `esp32-camera` qua git tag `v2.0.15`, `-Wall -Wextra` |
| 2 | `firmware/esp32_s3_cam/include/camera_config.h` | mới | Toàn bộ hằng số hiệu chỉnh + `static_assert` khoá dải |
| 3 | `firmware/esp32_s3_cam/include/wifi_secrets.h.example` | mới | Mẫu credential; file thật bị gitignore |
| 4 | `firmware/esp32_s3_cam/src/main.cpp` | mới | Camera + MJPEG HTTP + Wi-Fi STA + giám sát + `/status` |
| 5 | `firmware/esp32_s3_cam/README.md` | mới | Bảng chân, mã lỗi init, quy trình nạp, giới hạn |
| 6 | `gcs/backend/video_relay.py` | **sửa** | **Sửa lỗi bỏ khung MJPEG bị cắt** (xem §3) |
| 7 | `gcs/backend/tests/test_s3cam_wire_contract.py` | mới | **17 test** hợp đồng byte firmware ↔ backend |
| 8 | `gcs/backend/tests/test_video_relay.py` | sửa | +2 test cho khung cắt và buffer vượt trần |
| 9 | `docs/verification/TRACK_B_RUNBOOK.md` | mới | Runbook G0 trên bo thật |
| 10 | `.gitignore` | sửa | Bỏ qua `wifi_secrets.h` |
| 11 | `docs/INDEX.md`, `docs/interfaces/IF_ESP32_CAM_GCS.md`, plan | sửa | Ghi H1–H6, trạng thái A1 |

---

## 3. Lỗi thật phát hiện trong phiên này

### L-01 (P1) — `FrameExtractor` ghép khung bị cắt thành khung hỏng

**Vị trí:** `gcs/backend/video_relay.py:82-102` (trước khi sửa)

**Lỗi:** Khi một khung mất `FF D9` (Wi-Fi rớt giữa khung, client đóng đột ngột),
bộ tách vẫn tìm `FF D9` tiếp theo — nằm ở **khung kế tiếp** — và trả về một blob
ghép đôi. `frame_count` đếm blob đó là **một khung hợp lệ**.

**Bằng chứng:** `test_s3cam_wire_contract.py::TestSendChunkErrorPath::test_truncated_frame_is_discarded`
đỏ trước khi sửa. Blob trả về bắt đầu bằng `KVC-FRAME-A` và kết thúc bằng đuôi
của `KVC-FRAME-B`.

**Điều kiện kích hoạt:** Rớt gói Wi-Fi giữa khung, hoặc trình duyệt/backend ngắt
kết nối giữa response. Đây là **sự kiện bình thường** trên Wi-Fi, không phải
tình huống hiếm.

**Rủi ro:** Mọi số liệu dựa trên `frame_count` (kể cả phép đo A5) đều cao hơn
thực tế. Nghiêm trọng hơn: khung hỏng **không** gây lỗi, nên không ai biết.

**Sửa tối thiểu:** Tìm `FF D8` lồng bên trong trước `FF D9`. Nếu có → bỏ phần
dở, bắt đầu lại từ SOI mới (`video_relay.py:104-109`).

**Xác minh:** 17/17 test hợp đồng PASS; 84/84 backend PASS.

### Vì sao lỗi này chỉ lộ ra bây giờ

Firmware S3 là bên **tạo** khung đầu tiên có thể bị cắt trong thực tế. Trước
phiên này, relay chỉ được kiểm bằng camera giả phát khung **hoàn chỉnh**, nên
nhánh "khung dở" không bao giờ chạy.

### L-02 (P2) — Vòng khởi tạo lại camera không có backoff

**Vị trí:** `firmware/esp32_s3_cam/src/main.cpp` `camera_monitor()` (bản nháp
đầu tiên của phiên này, chưa nạp bo nên **chưa từng chạy**)

**Lỗi:** Bản nháp reset `g_attempts_since_ok = 0` và dời `g_last_ok_ms = now()`
**sau mỗi lần** restart. Dời mốc nghĩa là lần sót kế tiếp được tính từ lần
restart trước, nên nếu camera hỏng hẳn (đứt cáp FPC, mất nguồn 5 V) thiết bị sẽ
`deinit` / `init` lại **mỗi 10 giây mãi mãi**.

**Điều kiện kích hoạt:** Camera hỏng vật lý, hoặc cáp FPC lỏng. Đây chính là
tình huống A6/A7 muốn quan sát, nên vòng lặp dày sẽ che mất log lỗi thật.

**Rủi ro:** Module nóng, log ngập, và tình trạng "restart thành công" giả tạo
che mất nguyên nhân gốc.

**Sửa:** Backoff nhân đôi 10 s → 120 s (`KVC_CAM_RESTART_MAX_BACKOFF_MS`), reset
về mức ngắn nhất khi init thành công. Thêm cờ `g_cam_ready` để không gọi
`esp_camera_deinit()` khi driver chưa từng init.

**Xác minh:** **Build only** — chưa có test tự động vì đường này cần phần cứng.
Khi A7 (fault injection) chạy, phải thấy backoff tăng dần trong log chứ không
phải chu kỳ đều 10 s.

### L-03 (P3) — `esp_camera_deinit()` gọi trên driver chưa init

**Vị trí:** cùng hàm, cùng bản nháp.

**Lỗi:** `camera_restart()` gọi `esp_camera_deinit()` vô điều kiện. Nếu
`setup()` đã fail `camera_init()` (`g_cam_ready = false`), lời gọi đó thao tác
trên driver chưa khởi tạo.

**Sửa:** Cờ `g_cam_ready` chặn lời gọi. **Build only**, cùng lý do với L-02.

---

## 4. Lệnh đã chạy

| Lệnh | Exit | Kết quả |
| :--- | :---: | :--- |
| `pio run -d firmware/esp32_s3_cam` (clean build) | 0 | `[SUCCESS] 71.60 s` — RAM 41.608/327.680 B (12,7 %), Flash 531.727/6.553.600 B (8,1 %). **0 warning** với `-Wall -Wextra` |
| `pio run -d firmware/esp32_s3_cam` (sau sửa camera_monitor) | 0 | `[SUCCESS]` — RAM 41.616 B, Flash 531.863 B. **0 warning** |
| `.venv/Scripts/python.exe -B -m pytest gcs/backend/tests -q -p no:cacheprovider` | 0 | **84 passed** |
| `.venv/Scripts/python.exe -B -m pytest gcs/backend/tests/test_s3cam_wire_contract.py` | 0 | **17 passed** |
| `cd gcs/frontend; npm test` | 0 | **173 passed / 27 file** |
| `git diff --check` | 0 | không lỗi whitespace (chỉ cảnh báo LF/CRLF có sẵn) |

**SHA-256 `firmware.bin`** (chưa nạp bo):

| Build | SHA-256 | Ghi chú |
| :--- | :--- | :--- |
| Incremental | `63F92A1EFEE16E9861B6F117EB70E15A3ED85CC48F3D4E5925C373FFAC0DA29B` | |
| Clean rebuild | `407CE3ED56A177F154186A1FFD5F6F14E1DD0A6C4DB0DC7B61A399296A998C99` | **khác** |

**Hai build từ cùng source cho hai SHA khác nhau.** Đây không phải lỗi mã nguồn:
ESP-IDF nhúng timestamp/ELF-hash vào ảnh, nên `firmware.bin` của S3 **không
tái lập bit-chính-xác**. Hệ quả cho bằng chứng:

- **Không được** dùng SHA của `firmware.bin` để chứng minh "đã nạp đúng bản".
  Thứ tái lập được là **source + `platformio.ini` + Git HEAD**.
- Muốn đối chiếu sau khi nạp: dùng `esptool.py image_info` trên binary đọc lại
  từ flash, hoặc đơn giản là đọc `/status` xem `ver` = `a1.0.0`.
- Ghi `KVC_FW_VERSION` trong `camera_config.h` là cách duy nhất để biết bo đang
  chạy bản nào; tăng số này mỗi lần đổi hành vi.

Binary trong `.pio/` bị `.gitignore` bỏ qua; copy ra `review/artifacts/` nếu cần
giữ đúng artifact đã kiểm.

### Môi trường — sự cố đã xử lý

`framework-arduinoespressif32-libs` bị **thiếu thư mục `esp32s3`** (package 651 MB
nhưng khuyết SoC), nên mọi build S3 đều chết ở
`missing SConscript .../esp32s3/pioarduino-build.py`. Không liên quan tới mã
nguồn — build gateway C3 (vốn dùng `esp32c3`) vẫn PASS cùng lúc. Đã cài lại:

```powershell
pio pkg install --global --force -t "https://github.com/espressif/arduino-esp32/releases/download/3.3.11/esp32-core-3.3.11-libs.tar.xz"
```

**Ghi chú cho lần build sau:** nếu build S3 chết ở `pioarduino-build.py`, kiểm
`Test-Path ~\.platformio\packages\framework-arduinoespressif32-libs\esp32s3`
trước khi nghĩ tới lỗi mã nguồn.

---

## 5. Quyết định kỹ thuật trong firmware (kèm lý do)

| # | Quyết định | Vì sao |
| :---: | :--- | :--- |
| 1 | Dùng `esp_http_server` thay `WebServer` Arduino | MJPEG không bao giờ kết thúc; `WebServer` buffer toàn bộ vào `String`. `httpd` gửi chunk và có `lru_purge_enable` |
| 2 | **Serialize** bằng mutex thay vì chia sẻ framebuffer | `esp_camera_fb_get()` không an toàn đa task. Hệ quả: N client → mỗi client ~1/N khung. Muốn tăng thì gộp fan-out ở backend, **không** thêm client thứ ba |
| 3 | Bỏ **nguyên khung** khi vượt 160 KiB | Cắt ngắn tạo JPEG hỏng mà backend vẫn đếm là hợp lệ |
| 4 | Trần firmware (160 KiB) < trần backend (512 KiB) | Có `static_assert` + test. Firmware phải bỏ trước khi backend coi là hỏng |
| 5 | Không reboot khi camera init lỗi | Boot loop giấu lỗi. Giữ thiết bị sống để đọc `/status` và log |
| 6 | Chỉ restart camera khi `active_streams == 0` | `esp_camera_deinit()` trong lúc handler đang giữ con trỏ framebuffer là use-after-free |
| 7 | Không từ chối chạy khi PID ≠ OV3660 | A0 vẫn cần log khi hàng giao sai biến thể. Chỉ `LOGW` |
| 8 | Wi-Fi credential trong file gitignore | Không đưa SSID/mật khẩu vào `platformio.ini` đã commit hay tài liệu |
| 9 | Serial (UART0) thay USB-CDC | USB-CDC có thể bị tắt trên một số module; mất log đúng lúc cần nhất |
| 10 | Target **ESP32-S3-CAM**, không phải ESP32-CAM | H2 chốt OV3660 3 MP; ESP32-CAM cổ dùng OV2640 |

---

## 6. Điều KHÔNG được suy ra

| Không được nói | Vì sao |
| :--- | :--- |
| "Camera chạy được" | Chưa nạp. Build xanh ≠ cảm biến nhận cấu hình |
| "OV3660 đã xác nhận" | PID chỉ đọc được sau khi `esp_camera_init` thành công trên bo thật |
| "Stream ổn định 10 phút" | Chưa chạy. Cần A5 + soak |
| "FPS = X" | `frames` trong `/status` là số đếm tích luỹ, không phải tần số đo được |
| "Đã giảm tải camera" | Chưa đo. Serialize làm **chậm** mỗi client; giảm tải cần gộp fan-out ở backend |

---

## 7. Việc chưa làm

| Việc | Lý do | Cần gì |
| :--- | :--- | :--- |
| Nạp firmware lên module | Chưa thao tác phần cứng | Module + cáp USB |
| A0 — xác nhận marking/PID | Cần `esp_camera_init` chạy được | Đã nạp firmware |
| A5 — đo MJPEG thật | Cần thiết bị | Công cụ đã sẵn sàng |
| A6 — nguồn/nhiệt | Cần thiết bị đo | VOM/thermometer |
| A7 — fault injection | Cần S3 + C3 cùng phiên | Cả hai bo |
| Track B (G0, G6.1, A1–A10) | Cần bo + người thao tác | `docs/verification/TRACK_B_RUNBOOK.md` |

---

## 8. Mức bằng chứng

| Hạng mục | Mức |
| :--- | :--- |
| Firmware biên dịch cho `esp32s3` | **BUILT** (log + exit 0) |
| Hợp đồng byte firmware ↔ backend | **SIMULATED** (17 test) |
| Backend relay | **SOURCE-VERIFIED + SIMULATED** (84 test) |
| Frontend hiển thị | **SOURCE-VERIFIED + SIMULATED** (173 test) |
| Camera thật phát khung | **NOT RUN** |
| Track B / G0 / G6.1 / A1–A10 | **NOT RUN** |
