duyphong375/uav_payload/docs/verification/G6.1.9_PIXEL_COLOR_PROCEDURE.md

# G6.1.9 — Đo giá trị màu RGB565 (hướng dẫn thao tác)

**Mục đích:** trả lời câu hỏi mà 6.1.10 **không** trả lời được — *ngưỡng màu trong
`kvc_blob_detect.v` có đúng không*.

| Mục | Câu hỏi | Cách trả lời |
| :--- | :--- | :--- |
| 6.1.10 (đã PASS) | "Có phát hiện được mục tiêu không?" | `BB n1` trên log MCU |
| **6.1.9 (mục này)** | **"Màu thật là gì?"** | Đọc giá trị R/G/B trên frame |

Đây cũng là dữ liệu cần để đóng **F-02** (lấp đầy chỉ ~1 %, sát ngưỡng
`MIN_PIXELS`).

---

## 1. Tại sao phải nạp bitstream khác

Đường dữ liệu release chỉ mang **bbox** ra ngoài, không mang giá trị pixel. Không
có cách nào đọc R/G/B qua bitstream release.

Vì vậy cần bitstream chẩn đoán `kvc_top_diag_pixel` (`DIAG_MODE = 3`):

| Thông số | Giá trị (rev 4) |
| :--- | :--- |
| SHA-256 | **`EC4BC0081339729AD8CAFA4551A3076908E0FCC04CF4A8827A61B9CF153971A4`** |
| File | `review/artifacts/KVC_FPGA_diag_pixel_EC4BC008.fs` |
| Top | `kvc_top_diag_pixel` |
| Fmax `clk_100m` | **119,792 MHz** (ràng buộc 100 MHz, TNS setup & hold = 0) |
| Tài nguyên | 2.296 LUT-ALU (1.958 LUT + 338 ALU) / 1.525 FF / 1 BSRAM / 0,5 DSP |

> **Rev 1 `A92E18B9`, rev 2 `0B125CDC` và rev 3 `05288FA6` vẫn nằm trong
> `review/artifacts/` nhưng đã bị thay thế.** Rev 1 dùng ngưỡng **chặt hơn** blob cũ
> (`R≥26`, `G≤12`, `B≤8`), nên `red_count` của nó không so sánh được. Rev 2 dùng
> đúng ngưỡng blob **cũ**, nhưng ngưỡng đó đã bị thay bằng bộ lọc tỷ lệ. Rev 3 dùng
> đúng bộ lọc tỷ lệ nhưng `d`/`n` **tràn 8 bit**, làm `cnt_hue_ok`/`cnt_tone_ok`
> vô nghĩa. **Không dùng rev 1/2/3 để hiệu chuẩn ngưỡng màu.** Tool
> `decode_pixel_diag.py` nhận diện rev và cảnh báo khi gặp dữ liệu cũ.

---

## 2. Chuẩn bị vật thử

**Bốn yêu cầu, thiếu một là số đo vô nghĩa:**

| # | Yêu cầu | Vì sao |
| :---: | :--- | :--- |
| 1 | Vật **đỏ/cam ĐẶC**, không bóng, không trong suốt | Bóng tạo điểm sáng trắng; vải bóng phản xạ đèn → G/B tăng |
| 2 | Vật **phủ kín khung hình** (≥ 80 %) | Đo trung bình cả frame; nền chiếm nhiều thì kết quả là màu nền |
| 3 | **Không dùng màn hình điện thoại** | Đã sai lần trước (F-02): viền đen + AWB + phản xạ → lấp đầy chỉ 1 % |
| 4 | Đo **ba mẫu**: `#FF8800` (cam), `#FF5500` (đỏ-cam), `#FF0000` (đỏ thuần) | Mẫu cam/đỏ-cam là **dương**; đỏ thuần là **âm** kiểm bộ lọc |

### 2.1 Bộ lọc đã đổi sang tỷ lệ — đọc trước khi chọn vật

Rev 2 của `kvc_blob_detect.v` (04/11/2026) **bỏ ngưỡng biên độ tuyệt đối**. Lý do
đã đo được: `R_MIN=20, G_MIN=10, G_MAX=44, B_MAX=12` trượt theo cường độ sáng và
AWB, và `G_MIN=10` loại đúng vật đỏ-cam bão hoà. Trên bo thật chỉ đạt 12,1–15,5 %
(`evidence/KVC-G6.1-20261103-001.md`, `KVC-G6.1-20261103-002_release.md`).

Bộ lọc hiện tại so **tỷ lệ**, với `R8=r5*8`, `G8=g6*4`, `B8=b5*8`, `d=R8-B8`,
`n=G8-B8`:

| Điều kiện | Công thức | Ý nghĩa |
| :--- | :--- | :--- |
| Thứ tự | `R8 > G8 > B8` | màu "nóng", đỏ nhất |
| Độ sáng | `R8 >= 32` | chống nhiễu sensor ở vùng tối |
| Chroma | `d >= 24` | chống màu gần xám |
| Hue thấp | `6n >= d` | `H >= ~10°` (loại đỏ thuần) |
| Hue cao | `3n <= 2d` | `H <= ~40°` (loại vàng) |
| Bão hoà | `5·B8 <= R8` | `S >= 0,80` (loại da người, bùn, phù sa) |

Kiểm bằng số (đơn vị 8 bit mở rộng):

| Màu | R8/G8/B8 | `S` | Kết quả | Ghi chú |
| :--- | :--- | ---: | :---: | :--- |
| Phao cam `#FF8800` | 248/136/0 | 1,00 | **PASS** | mẫu dương chuẩn |
| Áo cam `#FF8C1E` | 248/140/24 | 0,90 | **PASS** | mẫu dương thực tế |
| Cam tối 25 % | 64/36/0 | 1,00 | **PASS** | **bất biến với gain** |
| Đỏ thuần `#FF0000` | 248/0/0 | 1,00 | loại | `G8 > B8` sai ⇒ `ord_ok=0` |
| Vàng `#FFE63C` | 248/228/56 | 0,77 | loại | `3n > 2d` (H ≈ 54°) |
| Trắng `#FFFFFF` | 248/252/248 | 0,00 | loại | `d=0` |
| **Da người TB** `#C68642` | 192/132/64 | 0,67 | loại | **mấu chốt: `S<0,80`** |
| **Da tối** `#8D5524` | 136/84/32 | 0,76 | loại | sát ngưỡng, cần đo lại |
| **Bùn ướt** `#6E4628` | 104/68/40 | 0,62 | loại | |
| **Nước phù sa** `#8B5A2B` | 136/88/40 | 0,71 | loại | |

**Hệ quả cho phép đo:** ba mẫu cho ba mục đích khác nhau.

1. **`#FF8800` / `#FF8C1E`** — mẫu dương: `cnt_match` **phải** cao (≈ 100 % nếu
   phủ kín khung). Nếu thấp, bộ lọc hoặc AWB có vấn đề.
2. **`#FF0000`** — mẫu âm: `cnt_match` **phải** ≈ 0 trong khi `cnt_ord_ok` ≈ 0 và
   `cnt_sat_ok` ≈ 100 %. Chứng minh bộ lọc loại đỏ thuần vì **thứ tự kênh**, không
   phải vì quá tối (khác hẳn rev 1).
3. **Da người / gỗ / bùn** (tuỳ chọn) — mẫu nhiễu: `cnt_sat_ok` phải thấp. Đây là
   phép đo trực tiếp kiểm chứng ngưỡng `S >= 0,80` có an toàn không.

**Ánh sáng:** phòng sáng đều, tránh đèn chiếu trực tiếp tạo điểm cháy. AWB cần
ảnh có màu tham chiếu; nếu khung toàn một màu, AWB có thể kéo màu theo hướng
khác — **đây chính là hiện tượng cần đo**, không phải tránh.

> **Vì sao vẫn cần đo:** ngưỡng `S >= 0,80` được suy ra từ bảng màu lý thuyết.
> AWB đang bật (`ov2640_config.v`: `COM8=0xE5`, `COM9=0x48`) nên **màu thật trên
> bo chưa biết**. Nếu áo cam thật có `B` cao hơn dự kiến (AWB kéo xanh), nó có
> thể rơi xuống `S < 0,80` và bị loại — đúng kiểu thất bại cũ, chỉ đổi chỗ. Chỉ
> số đo mới trả lời được.

---

## 3. Thao tác

```powershell
# 1. Kiem SHA truoc khi nap (rev 3)
Get-FileHash review\artifacts\KVC_FPGA_diag_pixel_05288FA6.fs -Algorithm SHA256
# Phai ra 05288FA6...

# 2. Gowin Programmer -> SRAM Program -> file tren

# 3. Dat vat do-cam truoc ong kinh, phu kin khung (xem §2.1)

# 4. Capture 10 s
python scripts/manual/fpga_uart_capture.py `
    --port COM8 --baud 38400 --seconds 10 `
    --dump docs/verification/evidence/G6.1.9_pixel_<YYYYMMDD-HHMM>.bin

# 5. Giai ma (in rev + 4 bo dem chan doan)
python scripts/manual/decode_pixel_diag.py `
    --file docs/verification/evidence/G6.1.9_pixel_<YYYYMMDD-HHMM>.bin

# 6. NAP LAI release truoc khi lam viec khac
Get-FileHash review\artifacts\KVC_FPGA_release_<SHA>.fs -Algorithm SHA256
```

> **Đổi bitstream release:** bitstream release cung da doi (blob rev 2). Sau khi
> do, nạp lại bản release **mới nhất** ghi trong `FPGA_BUILD_RECORD.md §1`, không
> phải `86CCF5DD` của rev 1.

---

## 4. Đọc kết quả

Tool in (ví dụ với vật cam phủ kín khung):

```text
[*] Khung IF-01: 43 hop le, 0 loi CRC
[*] Bao cao co pixel: 43

--- Báo cáo #1  (ts=62225 ms, rev 3) ---
  pix_count   : 307200
  sum R/G/B   : 76206000 / 41779200 / 7372800
  mean R5/G6/B5: 31.00 / 34.00 / 3.00   (thang 0..31 / 0..63 / 0..31)
  mean R8/G8/B8: 255 / 138 / 24         (thang 0..255)
  cnt_match   : 307200 (100.00% — cùng bộ lọc với blob)
  max_r5      : 31/31
  chẩn đoán   : R>G>B 100.0% · hue 100.0% · S>=0,80 100.0% · sáng+chroma 100.0%
  center_pixel: 0xFA06 (R5=31 G6=34 B5=6)
```

**Tiêu chí 6.1.9** (theo `BRINGUP_CHECKLIST.md`):

| Tiêu chí | Ngưỡng |
| :--- | :--- |
| R trung bình | **> 240/255** |
| G trung bình | **< 32/255** |
| B trung bình | **< 32/255** |

> **Lưu ý về tiêu chí G < 32/255:** tiêu chí này viết cho **đỏ thuần**, không cho
> cam. Màu cam cứu hộ thật có `G8 ≈ 130–150`, nên nó **luôn FAIL** tiêu chí G nếu
> đem áp lên mẫu cam. Đây là chỗ checklist và bộ lọc mâu thuẫn nhau về mặt định
> nghĩa, không phải lỗi RTL. Khi đọc kết quả:
>
> - Mẫu **đỏ thuần** → áp cả ba tiêu chí (đây là mục đích gốc của 6.1.9).
> - Mẫu **cam** → chỉ cần `cnt_match` cao và `mean_r8` cao; bỏ qua tiêu chí G.
> - `cnt_ord_ok` = 0 trên đỏ thuần **là kết quả đúng**, không phải lỗi.

### 4.1 Đọc ba kịch bản

| Kết quả | Nghĩa | Làm gì |
| :--- | :--- | :--- |
| `mean_r8 > 240`, `mean_g8/b8 < 32` trên ĐỎ THUẦN | **PASS** — 6.1.9 đạt yêu cầu gốc | Đóng 6.1.9 |
| `cnt_match` ≈ `pix_count` trên CAM | bộ lọc nhận đúng vật cam | kết hợp với `cnt_match` capture blob để đóng F-02 |
| `max_py < 479` (rev 4) | Frame **bị cắt** — số liệu không dùng để hiệu chuẩn | F-04/F-05; xem `evidence/KVC-G6.1-20261104-001.md` §4 |
| `mean_r8` thấp (< 200) | AWB kéo R xuống, hoặc vật không đỏ đặc | Kiểm ánh sáng; thử khoá AWB |
| `mean_g8/b8` cao (> 60) trên đỏ thuần | Nền chiếm nhiều, hoặc vật phản xạ | Phủ kín khung hơn |
| `pix_count = 0` | Camera không phát, hoặc frame bị skip | Kiểm `cfg_done`, dây camera |
| `pix_count` chỉ 36.668–119.911 | Frame không đủ pixel cho một khung đầy đủ | Đọc `max_px`/`max_py` (rev 4) để biết bị cắt ở đâu. **Không** suy chiều cao từ `pix_count` — xem `evidence/KVC-G6.1-20261104-001.md` §4 |
| `cnt_match` thấp trên CAM | **bão hoà thật < 0,80** (AWB kéo B lên) | Đọc §4.2, nới `sat_ok` thành `4·B8 ≤ R8` nếu cần |

### 4.2 Bốn slot chẩn đoán — trả lời F-02

Rev 4 đếm **riêng từng điều kiện** của bộ lọc tỷ lệ:

| Slot | Trường | Điều kiện | Dùng để |
| ---: | :--- | :--- | :--- |
| 4 | `cnt_match` | đủ **4** điều kiện + run-length | So trực tiếp với `cnt` của blob |
| 6 | `cnt_ord_ok` | `R8 > G8 > B8` | thứ tự kênh có phải nút thắt? |
| 7 | `cnt_hue_ok` | `6n ≥ d` và `3n ≤ 2d` | **dải hue** có phải nút thắt? |
| 8 | `cnt_sat_ok` | `5·B8 ≤ R8` (`S ≥ 0,80`) | **bão hoà** có phải nút thắt? |
| 9 | `cnt_tone_ok` | `R8 ≥ 32` và `d ≥ 24` | sáng + chroma có phải nút thắt? |

> **Rev 3 chỉ dùng được slot 4/6/8.** Slot 7 và 9 của rev 3 bị **tràn 8 bit**
> (`d`/`n` khai báo 8 bit nên âm thành dương lớn) và đếm cả pixel xanh/tím. Tool
> `decode_pixel_diag.py` nhận diện rev 3 và **bỏ qua** hai slot đó. Rev 4 mới
> dùng được cả bốn.

Tool in thêm tỉ lệ % của từng bộ đếm trên `pix_count`.

**Cách đọc — chọn kết luận theo bộ đếm thấp nhất:**

| Bộ đếm thấp nhất | Kết luận | Hành động |
| :--- | :--- | :--- |
| `cnt_ord_ok` thấp | vật không "nóng" hoặc AWB kéo lệch thứ tự | kiểm AWB; ghi `mean_r8/g8/b8` |
| `cnt_hue_ok` thấp | vật ngoài dải 10–40° (quá đỏ hoặc quá vàng) | điều chỉnh `hue_lo`/`hue_hi` theo số đo |
| **`cnt_sat_ok`** thấp | **`S ≥ 0,80` quá chặt** cho áo cam thật | đổi `sat_ok` từ `5·B8 ≤ R8` sang `4·B8 ≤ R8` (`S ≥ 0,75`) và chấp nhận tăng nhầm da |
| `cnt_tone_ok` thấp | vật quá tối hoặc gần xám | hạ `LUM_MIN`/`CHROMA_MIN`, kiểm ánh sáng |

**Bất biến kiểm dữ liệu:** `cnt_match ≤ min(cnt_ord_ok, cnt_hue_ok, cnt_sat_ok,
cnt_tone_ok)` phải luôn đúng. Nếu sai, bitstream/đường UART có vấn đề — **không
kết luận**.

### 4.3 `cnt_match` — chỉ số quyết định cho F-02

`cnt_match` đếm pixel thoả **đúng** bộ lọc `kvc_blob_detect.v` rev 2 (kể cả
run-length ≥ 3). Vì vậy `cnt_match` phải bằng `cnt` của blob trên cùng frame
(cùng bitstream không thể đo cả hai, nên so với **capture blob riêng** trên cùng
cảnh).

Nếu `cnt_match / pix_count` **thấp** trên một vật cam đặc phủ kín khung ⇒
**ngưỡng bão hoà quá chặt**, và slot 8 chỉ ra điều đó. F-02 được xác nhận bằng
số đo, không bằng suy đoán.

> **Rev 1 (`A92E18B9`) và rev 2 (`0B125CDC`) không làm được việc này.** Rev 1
> dùng `R≥26, G≤12, B≤8`, chặt hơn blob cũ ở cả ba kênh. Rev 2 dùng đúng ngưỡng
> blob **cũ** — nhưng ngưỡng đó đã bị thay bằng bộ lọc tỷ lệ, nên số của rev 2
> không còn so sánh được với blob hiện tại. Tool vẫn đọc được cả hai để tra cứu
> capture cũ, nhưng in cảnh báo. **Rev 3** đúng bộ lọc nhưng có lỗi tràn ở slot
> 7/9. **Rev 4** là bản duy nhất dùng được cả bốn slot.

---

## 5. Giới hạn của phép đo

| Giới hạn | Ảnh hưởng |
| :--- | :--- |
| Trung bình toàn frame | Vật không phủ kín ⇒ kết quả là **màu trung bình của vật + nền**, không phải màu vật |
| Không đo độ đồng đều | Một vật có gradient vẫn cho trung bình "đúng" dù nửa sáng nửa tối |
| `max_px`/`max_py` (rev 4) chỉ là biên | Không nói pixel có liên tục hay không; phải xem thêm `pix_count` |
| `center_pixel` (rev ≤ 3) chỉ 1 điểm | Có thể **stale** nếu frame không tới dòng 240; không dùng để kết luận |
| Chỉ 1 frame mỗi lần chụp | Cần chạy vài lần để thấy ảnh hưởng AWB |
| Không đo được AWB setting | Phải đọc thanh ghi SCCB — nằm ngoài phạm vi 6.1.9 |

**Phép đo này KHÔNG chứng minh:** blob phát hiện đúng, georef chính xác, hay
ngưỡng đã tối ưu. Nó chỉ trả lời *"màu thật là gì"*.

---

## 6. Sau khi có số

Cập nhật:

| File | Mục |
| :--- | :--- |
| `BRINGUP_CHECKLIST.md` | 6.1.9 → `PASS`/`FAIL` kèm số đo |
| `KVC-F02-G27-20261102-001.md` | Thêm số `cnt_match/pix_count` + slot 6..9 để xác nhận/bác bỏ F-02 |
| `FPGA_BUILD_RECORD.md` | Ghi bitstream rev 3 và các bản cũ đã thay thế |
| `evidence/README.md` | Đăng ký file `.bin` mới |

**Nhớ:** nạp lại bitstream release mới nhất (`FPGA_BUILD_RECORD.md §1`) ngay sau
khi đo xong. Bitstream SRAM mất khi mất điện, nhưng để nguyên bản diag thì phiên
sau sẽ đọc nhầm số (đã xảy ra một lần với `n12`).

---

## 7. Vì sao rev 4 phải thay rev 3

| Hạng mục | Blob rev 1 (cũ) | Rev 1 `A92E18B9` | Rev 2 `0B125CDC` | Rev 3 `05288FA6` | **Rev 4 `EC4BC008`** |
| :--- | :--- | :--- | :--- | :--- | :--- |
| Bộ lọc | biên độ `R≥20, G 10..44, B≤12` + trội đỏ | `R≥26, G≤12, B≤8` | đúng ngưỡng blob **cũ** | tỷ lệ: thứ tự + hue + S≥0,80 | **tỷ lệ, giống rev 3** |
| Run-length ≥ 3 | không có | không có | không có | có (khớp blob) | **có** |
| Slot 4 | — | `red_count` (ngưỡng riêng) | `cnt_match` (ngưỡng cũ) | `cnt_match` | **`cnt_match`** |
| Slot 5 | — | `center_pixel` + `max_r5` | same | same | **`max_px` + `max_py`** |
| Slot 6..9 | — | 0 | `cnt_r/g/b/rg_ok` | `cnt_ord/hue/sat/tone_ok` — **hue/tone bị tràn 8 bit** | **`cnt_ord/hue/sat/tone_ok` — đã sửa tràn** |
| Slot 10 | — | 0 | 0 | `PIXSTAT_REV = 3` | **`PIXSTAT_REV = 4`** |
| Slot 11 | — | 0 | 0 | 0 | **`max_r5`** |
| So được với `cnt` của blob hiện tại | — | **không** | **không** | **có** (slot 4/6/8) | **có** (cả 4 điều kiện) |

Rev 1 chặt hơn blob ở cả ba kênh. Rev 2 đúng ngưỡng blob nhưng ngưỡng đó đã bị
thay. Rev 3 dùng đúng bộ lọc tỷ lệ, nhưng `d`/`n` khai báo 8 bit nên **tràn** khi
`R8 < B8` / `G8 < B8`: `cnt_hue_ok` đếm dư 10.581/16.192 mã và `cnt_tone_ok` đếm
dư 24.192/51.968 mã. Vì vậy **chỉ slot 4/6/8** của rev 3 dùng được; slot 7/9
không. Rev 4 sửa gốc và thêm `max_px`/`max_py` để phát hiện frame bị cắt.

Lịch sử đầy đủ: `evidence/KVC-G619-20261103-001.md` §7–§8 và
`evidence/KVC-G6.1-20261104-001.md`.
