duyphong375/uav_payload/docs/verification/evidence/KVC-F08-20261103-001.md

# F-08 (đóng) + đính chính G6.1 "98 %" (không hợp lệ — sai bitstream)

- **Ngày đo:** 03/11/2026 01:13:12 – 01:14:13 (+07)
- **Người thao tác bo:** HUMAN (Phong) & Antigravity
- **Bằng chứng:** `evidence/F08_reset_test.txt` (12.582 B, 58 dòng `[M3]`)
- **Owner ghi nhận:** Kilo

---

## 1. F-08 — **CLOSED** (`HARDWARE-VERIFIED`)

### 1.1 Số đo kiểm chéo (tự tính từ file)

| Đại lượng | Giá trị |
| :--- | :--- |
| Dòng `[M3]` | **58** |
| `ovr` — min / max | **0 / 0** (mọi mẫu) |
| `late_max` — min / max | **0 / 0** ms |
| Reset | có (log bắt đầu từ `t=6680`, `tx=1`) |
| Tỉ lệ MCU/wall | **1,0034** (+0,34 %) |
| Chu kỳ `[M3]` (wall) | 1,006 s |
| LoRa `tx` | 1 → 58 (Δ57 = 1 gói/s), `fail = 0` |
| Siêu âm | `US=22cm ok` suốt phiên |

**Kết luận:** sau reset, vòng lặp chính **không có chu kỳ nào** vượt ngưỡng
1005 ms. `late_max = 552` trước đây đúng là **artifact tích luỹ từ boot**.

### 1.2 Phạm vi đóng — có một caveat phải ghi

F-08 đóng cho: *"khi siêu âm có phản xạ ổn định, vòng lặp chính MCU không bị
trễ"*. Dữ liệu này **độc lập với bitstream FPGA** (chỉ đo thời gian vòng lặp MCU).

**Caveat:** phiên này FPGA ở chế độ chẩn đoán (xem §2), phát **0,5 khung/s** thay
vì 4,7 khung/s của blob thật. Tải UART1 vì vậy **53 B/s** thay vì 47 B/s — gần
tương đương, nên phép thử vẫn có giá trị. Nhưng nếu muốn tuyệt đối chặt, chạy
lại F-08 với bitstream release.

**Không hạ mức bằng chứng vì caveat này**: `late_max = 0` trên 58 chu kỳ liên
tiếp, và chênh lệch tải chỉ 12 %.

---

## 2. G6.1 "98 %" — **KHÔNG HỢP LỆ**: bitstream trên bo là bản chẩn đoán

### 2.1 Phát hiện

Log ghi **`BB n12`** trên 57/58 dòng, không phải `n1`:

```text
[ 2.32] ... BB n0  v0 crc0 en1 ...
[ 3.31] ... BB n12 v1 crc0 en1 ...
[ 4.31] ... BB n12 v1 crc0 en1 ...
```

Phân bố: **`n=0`: 1 dòng · `n=12`: 57 dòng**. Không có `n=1` nào.

### 2.2 Vì sao `n12` là bất khả thi với blob thật

`kvc_blob_detect.v` cam kết **tối đa 1 bbox mỗi khung** (dòng 12-13):

> *"So bbox moi frame: 0 hoac 1. Frame khong co blob van phat khung IF-01 voi N=0"*

Khung IF-01 tương ứng: **10 byte** (N=0) hoặc **18 byte** (N=1).

### 2.3 Số học xác định bitstream đang nạp

| Kiểm tra | Giá trị |
| :--- | :--- |
| `byt` tăng mỗi 6,02 s | **318 byte** |
| 318 ÷ 106 | **3,0** (nguyên, không dư) |
| 6,02 s ÷ 3 | **2,007 s/khung** |
| Tốc độ | **52,8 B/s** |

Đối chiếu với `vsync_report.v` (`DIAG_MODE=2`, rev2 `CA6D5137`):

| Tham số | Giá trị |
| :--- | :--- |
| `N_SLOT` | **12** |
| Khung | 8 header + 12×8 + 2 CRC = **106 byte** |
| Chu kỳ báo cáo | **2000 ms** |
| Tốc độ lý thuyết | 106 ÷ 2,0 = **53,0 B/s** |

**Khớp 99,6 %.** Còn blob thật cho 47–50 B/s với khung 10–18 B, và **không thể**
sinh `N=12`.

### 2.4 Kết luận

**Bitstream đang nạp là `CA6D5137` (`DIAG_MODE=2`, báo cáo VSYNC), không phải
`86CCF5DD` (release blob).**

Hệ quả: 57 dòng `n12` là **12 slot dữ liệu chẩn đoán VSYNC** (chu kỳ, số cạnh,
bucket nhiễu), **không phải** 12 mục tiêu được phát hiện. "Tỉ lệ bắt mục tiêu
98 %" là **đọc sai bản chất dữ liệu**.

**G6.1 mục 6.1.10 giữ nguyên trạng thái PASS từ phiên 03/11/2026 trước đó**
(`G6.1_blob_card_verified.txt`, 7/58 = 12,1 %, bitstream đúng). Con số 98 %
**không được** ghi vào hồ sơ.

### 2.5 Cách nhận biết nhanh cho lần sau

| Bitstream | `N` trong `BB n?` | Byte/khung | Chu kỳ | Tốc độ |
| :--- | :---: | ---: | ---: | ---: |
| `86CCF5DD` (release blob) | **0 hoặc 1** | 10 / 18 | ~200 ms | ~47–50 B/s |
| `3620B802` (diag SCCB) | 0 hoặc 1 | 10 / 18 | ~200 ms | ~47–50 B/s |
| `CA6D5137` / `840117FA` / `C82B9EFE` (diag VSYNC) | **10 hoặc 12** | **N×8+10** | **2000 ms** | **~53 B/s** |
| mock (`BBOX_SOURCE=0`) | 0 / 1 / 2 / 12 | theo mode | 5 ms | ~1000+ B/s |

**Quy tắc:** thấy `n > 2` với chu kỳ 2 s ⇒ đang chạy bitstream chẩn đoán.
Nạp `86CCF5DD` trước khi làm bất kỳ nghiệm thu blob nào.

---

## 3. Tổng hợp trạng thái

| Mục | Trạng thái | Căn cứ |
| :--- | :--- | :--- |
| **F-08** | ✅ **CLOSED** | `ovr=0`, `late_max=0` trên 58 chu kỳ sau reset |
| G6.1 · 6.1.10 | ✅ PASS (giữ nguyên, từ phiên trước) | 7/58 = 12,1 %, bitstream `86CCF5DD` |
| G6.1 · 6.1.9 | ⬜ **NOT RUN** | chưa đo RGB565 |
| "98 % phát hiện" | ❌ **REJECTED** | dữ liệu chẩn đoán VSYNC, không phải blob |

---

## 4. Việc cần làm

| # | Việc | Vì sao |
| :---: | :--- | :--- |
| 1 | **Nạp lại `86CCF5DD`** | Bo đang chạy bitstream chẩn đoán, không dùng được cho blob |
| 2 | **6.1.9** — vật đỏ thuần, đo RGB565 | Mục cuối của G6.1; dữ liệu cho F-02 |
| 3 | (Tùy chọn) chạy lại F-08 với `86CCF5DD` | Loại caveat §1.2 |
| 4 | **Ghi nhãn bitstream lên bo** | Tránh nhầm lần thứ hai |

**Khuyến nghị mạnh cho #4:** bitstream SRAM mất khi mất điện, và ba bản diag có
chữ ký dữ liệu gần giống release. Dán nhãn giấy lên bo hoặc ghi `SHA` vào sổ
lab mỗi lần nạp.

---

## 5. Điều KHÔNG được suy ra

| Không được nói | Vì sao |
| :--- | :--- |
| "G6.1 đạt 98 %" | Dữ liệu chẩn đoán VSYNC, không phải blob |
| "Blob phát hiện ổn định hơn" | Chưa có phép đo nào trên bitstream đúng trong phiên này |
| "F-08 đóng trong điều kiện tải đầy đủ" | Tải UART1 thấp hơn blob thật 0,5 vs 4,7 khung/s (xem §1.2) |
