duyphong375/uav_payload/fpga/src/fifo_hs/cam_fifo.v

//
//Written by GowinSynthesis
//Tool Version "V1.9.12.03 (64-bit)"
//IP Version: 1.0
//Thu Oct 22 15:10:08 2026

//Source file index table:
//file0 "\D:/GOWIN9.12.03/Gowin/Gowin_V1.9.12.03_x64/IDE/ipcore/FIFO_HS/data/fifo_hs.v"
//file1 "\D:/GOWIN9.12.03/Gowin/Gowin_V1.9.12.03_x64/IDE/ipcore/FIFO_HS/data/fifo_hs_top.v"
`timescale 100 ps/100 ps
`pragma protect begin_protected
`pragma protect version="2.3"
`pragma protect author="default"
`pragma protect author_info="default"
`pragma protect encrypt_agent="GOWIN"
`pragma protect encrypt_agent_info="GOWIN Encrypt Version 2.3"

`pragma protect encoding=(enctype="base64", line_length=76, bytes=256)
`pragma protect key_keyowner="GOWIN",key_keyname="GWK2023-09",key_method="rsa"
`pragma protect key_block
jJkv9wmfPZge5o3Q8sIP4k5DnHNw/9yyTd+im3iLxObtpibBEXw5wbt3zngEohU3WbaF6Ww66Zg1
EL2UCUUwGjVarZtbjSXG7IV6RYqoUr/XBekvmV5j1yA0TVKMB7HjYfoUKD46sKdenGi7TbkpEjx7
yp35eTr5WO6ccS5fJNC9Cf1mMAup+emcW99IGVTcXS58rZhf6BuurigZKxKoevVzP4QhRA4XdXkY
aqjmkaCaOUmkt7pmE/QFiQMpAyXkX/41JjhXrsEvAJfuVNx8HIF4HPnoc1W6WY7We4wy4B1Mz+tf
s1BTOkxmyX6PFWrDTqy0+/y6zNkSp53cQVdlZg==

`pragma protect encoding=(enctype="base64", line_length=76, bytes=19952)
`pragma protect data_keyowner="default-ip-vendor"
`pragma protect data_keyname="default-ip-key"
`pragma protect data_method="aes128-cfb"
`pragma protect data_block
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
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
