duyphong375/uav_payload/(commit log)

2026-10-26 feat(firmware): GNSS/UBX config, timebase, RF decode and net policy
    MCU: NEO-M10 NMEA parser hardening, UBX-CFG helpers, shared monotonic timebase, pinout and sensor header updates. Gateway: RF frame decoding and Wi-Fi policy split into testable modules with host tests. Docs: sensor package manifest, interface and wiring updates. Adds scripts/test_firmware.ps1.
2026-10-26 docs(hardware): version sensor datasheets in repo
    Owner accepted redistribution risk: drop docs/hardware/sensors/**/*.pdf from .gitignore and track the eight reference PDFs so a fresh clone has the documents the drivers were verified against. SENSOR_PACKAGES.md keeps source and SHA-256 for integrity checks.
2026-10-26 Revert "docs(hardware): version sensor datasheets in repo"
    This reverts commit c64ab243653e8a0f67a019d3813f5ea30cdfe8a6.
2026-10-26 fix(mcu): low-pass filter IMU roll/pitch before publishing
    Log M3 showed 3.9 deg roll / 7.1 deg pitch jumps between consecutive 1 Hz
    samples with the board standing still: each cycle took a single raw accel
    sample straight through atan2, and MPU-6050 noise plus frame vibration make
    that unreliable. Apply a first-order EMA (1/4) to the resulting angles.
    The filter cannot fix swapped or mis-oriented axes; a large non-zero
    roll/pitch on a level board is a hardware mapping issue.
2026-10-26 fix(mcu): widen ultrasound RX window and split frame decoder
    The 120 ms window dropped the module's whole No-Echo burst about 1/65
    triggers, so the driver reported err/6 ('module did not answer 0x01')
    while the module had in fact answered late. Measured on the kit:
    val/trg went from ~4 to 9.7 frames per trigger with bad=0 once the
    window was 250 ms.
    Also split the 4-byte FSM out of the hardware header into
    kvc_usound_decode.{h,c} so it can be host-tested. The new test found two
    real defects:
    - the plan's sample frame FF 03 E8 01 for 1000 mm is wrong; the correct
    checksum is 0xEA (0xFF + 0x03 + 0xE8 = 0x1EA)
    - the range gates compared calc_mm / 10 against the cm limits, so integer
    trunca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
2026-10-26 feat(mcu): use GNSS track_made_good as georef yaw
    Georef assumed the camera always pointed north, so rotating the UAV
    displaced the target coordinate by exactly the yaw angle. Parse RMC field
    8 (course over ground; field 7 is speed) into course_deg10 and expose
    kvc_gnss_get_course_deg10(), which only returns a value for status 'A'
    RMC, a course no older than 3 s, and ground speed >= 0.5 knot.
    Rotation uses an integer sin table (src/kvc_geo_math.c) rather than libm:
    Cortex-M4F here runs IHRC at 12 MHz without PLL, and the interpolation
    error is 0.09 % (about 9 mm at 1 m), adequate for this approximation.
    When no yaw is available the georef keeps the previous north assumption
    and the M3 log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
2026-10-26 docs: record MCU-1.1 to 1.3 closed and MCU-1.5 software done
    MCU-1.1 and 1.3: replace the fe=0 acceptance criterion with bad=0. The
    three ports all show fe == byt because the sensor TX line idles low, so
    the UART sees a false start bit on every byte; GNSS still reports bad=0
    with a 3D fix, and ultrasound bad=0 with val/trg around 4..10. Chasing
    fe=0 in firmware was the wrong direction.
    MCU-1.2: document the decoder split, the 14 test cases and the two real
    defects the test found. MCU-1.5: record what was implemented, the 157 new
    assertions, and the limits that remain (track is direction of travel, no
    yaw while hovering, unmeasured 0.5 knot threshold, unchanged nominal
    camera intrinsics).
2026-10-26 docs(mcu): correct FPGA RX ring sizing rationale
    The comment still described the removed 3-sample ultrasound read (340 ms).
    The driver now does one measurement with a 250 ms window, so the longest
    non-consumer span is ~650 ms and the 4096-byte ring keeps a 1.64x margin
    at 38400 baud instead of the stated 1.44x. Comment only.
2026-10-29 feat(mcu): bench bring-up updates, sensor logging and schematic guide
    Add KVC_FPGA_ENABLE macro to support running MCU bench without FPGA.
    Add KVC_GNSS_SKIP_AUTOBAUD macro and active baud reporting.
    Fix ultrasound outlier rejection logic in kvc_usound_read_robust.
    Add boot banner, [INIT] sensor status, and tx counter to UART5 log.
    Add KVC_CIRCUIT_SCHEMATIC_GUIDE.md and MCU_BENCH_TEST_PLAN.md.
2026-10-29 feat(mcu): tach georef + usound filter, them host test ABI/georef/filter, sua ovr metric
2026-10-30 feat(gcs, gateway, mcu): gcs ui refactor, gateway session id and track registry
    Update GCS frontend UI layout, tactical dock, design tokens, and stale state handling.
    Add ESP32 gateway session ID generator and unit tests.
    Add GCS backend track registry for target correlation.
    Update docs and exclude local experiment folders in .gitignore.
2026-10-31 chore(fpga): add KVC_PR Gowin project baseline before P1 repair
    Baseline snapshot truoc khi sua 4 loi P0 (uart_tx start bit,
    bbox_packetizer endianness, yolo_nms IOU_THRESH, top datapath).
    Trang thai do duoc:
    - 129 tep source/constraint/tai lieu; build artifacts loai qua .gitignore
    - Bitstream cu: Fmax 14.6 MHz / 100 MHz, khong chua kvc_yolo_top
    - gen/weights.bin va quant.hex la du lieu gia (0.083% byte khac 0)
    - 3 testbench khong co assertion/\
    Refs: KVC-FPGA-REPAIR-20261030-001 P0 baseline
2026-10-31 fix(fpga): P1 - sua 4 loi P0 UART, 3 TB co assertion, timing PASS
    Sua:
    - uart_tx.v: bo bit start lap (shifter 10->9 bit, bit_cnt 9->8).
    Truoc: start keo 2 bit-time -> receiver nhan (tx_data << 1).
    - bbox_packetizer.v: Little-Endian toan bo (timestamp, bbox, CRC),
    them 1 chu ky S_PREP de crc_start khong bi mat.
    - yolo_nms.v: IOU_THRESH 32768 -> 16384 (0.5), sua NMS no-op.
    - mock_bbox.v + kvc_top_demo.v: packing Little-Endian khop parser C MCU;
    width/height khong con lay tu X/Y.
    - kvc_top_demo.v: USE_MOCK_BBOX=1 tam loai CNN/NMS khoi datapath;
    clear_timeout noi cam_vsync_pulse thay vi hard-wire 0;
    mock trigger 200 Hz (MOCK_DIV=500_000).
    Testbench (co \, da xac nhan bat duoc loi cu):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
2026-10-31 fix(fpga): P2 - CDC FIFO 2-FF sync, timestamp ms, camera comment
    - async_fifo_cdc.v: synchronizer 1-FF -> 2-FF cho ca hai chieu;
    empty/full dung con tro DA DONG BO (truoc day dung con tro tho
    bang qua mien clock); gray pointer cap nhat cung nhip voi bin
    (truoc day lech 1 do dung gia tri truoc khi tang).
    - kvc_top_demo.v: frame_timestamp chia 100000 (MS_DIV) -> don vi ms
    khop IF-01 va khong tran sau 42.9 s.
    - camera/camera_rx.v: sua header comment OV5640 -> OV2640.
    Hoan sang P3 (nam trong CNN path dang tat):
    - line_buffer_3x3 ADDR_W >= 17
    - ov2640_config kiem chung RGB565 bang anh that
    - PCLK routing PR1014 (can IO_LOC CLOCK hoac BUFG)
    Kiem chung:
    - tb_async_fifo_cdc PASS (TB c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
2026-10-31 fix(fpga): P3 - engine requant Q31, window per-pixel, golden verify PASS
    Sua 4 loi trong conv_engine_dynamic_fsm.v:
    - E-01: weight_addr giu du 24 bit (truoc: [15:0] cat mat 8 bit cao,
    bien p_weight_base=0x400000 thanh 0x0000)
    - E-02: them ham requant() dung Q31 (truoc: clamp_q(acc*mult+bias)
    thieu shift, tich 32x32 bi cat, khong round)
    - E-08: MOI (khong co trong review luot 2) - FSM chi vao ST_WAIT_WIN
    mot lan, nen dung lai window cua pixel dau cho toan bo anh.
    Phát hiện qua tb_conv0_golden: 987/1024 mismatch.
    - E-09: sum_acc khong reset khi sang pixel moi
    Phu:
    - mult_mem: 32 -> 40 bit ({shift[7:0], mult_q31[31:0]}), zero hoa
    - bias_mem: xoa gia tri mau 1,2,3,4, zero hoa
    - tools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
2026-10-31 fix(mcu): P5 - tran sieu am 700cm, MAX_FRAME_MM 8000, alt_quality
    - kvc_usound_decode.h: KVC_USOUND_MAX_RANGE_CM 500 -> 700 (B-7)
    - kvc_usound_decode.h: KVC_USOUND_MAX_FRAME_MM 6000 -> 8000
    PHAT HIEN QUAN TRONG: MAX_FRAME_MM cu = 6000, TRUNG voi NO_ECHO_MM.
    decode.c loai moi khung calc_mm > MAX_FRAME_MM thanh BAD_CHECKSUM
    TRUOC khi kiem range, nen nang MAX_RANGE_CM mot minh VO HIEU:
    module tra 7000mm cho 7m nhung firmware loai ngay o checksum.
    Nay: MAX_FRAME_MM (8000) > MAX_RANGE_CM*10 (7000) > NO_ECHO_MM (6000).
    - kvc_usound_ajsr04m.h: KVC_USOUND_TIMEOUT_MS 250 -> 350
    (echo @7m can ~41ms + jitter + module timeout noi bo)
    - kvc_georef.h: them KvcGeoAltQuality (GOOD/FAIR/POOR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
2026-10-31 fix(fpga): E-03/E-05/E-06 - depthwise groups, SPI MSB, win_vec
    Sua 3 loi con mo trong engine:
    E-03 (groups/depthwise):
    - conv_engine_dynamic_fsm.v: them parameter GROUPS + port p_groups
    - Them ic_g (kenh toan cuc) tach khoi ic (kenh trong nhom)
    - Vong lap MAC dung in_c_per_g thay IN_C, window index dung ic_g
    - Dia chi weight dung oc*in_c_per_g*K*K (weight shape grouped)
    - tb_depthwise.v: PASS 146/146 voi C=4, GROUPS=4
    E-05 (SPI mat byte MSB):
    - spi_flash_wrapper.v:151-155: rdata <= {rx_data, word_buf[23:0]}
    thay vi rdata <= word_buf (dung gia tri CU do nonblocking)
    E-06 (win_vec cung 27 phan tu):
    - PHAT HIEN MOI: reg [7:0] win_vec [0:26] co dinh 3x3x3.
    Voi IN_C=4 (depthwise) -> thieu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
2026-10-31 test(fpga): verify 6 toan tu graph cho model rut gon (C-b)
    Them testbench co \ cho 6 module chua tung duoc verify:
    - tb_maxpool2d.v: 4 cau hinh (K2S2, K3S1P1, K5S1P2 SPPF, K1)
    PASS 4/4. Phat hien: RTL doi input_addr truoc khi data ve
    (REQ -> WAIT_RAM -> SAMPLE), nen TB phai dung RAM dong bo.
    - tb_concat_n_feature.v: N=3, N=2, N=1. PASS 3/3.
    Phat hien: module khong xuat bank_index, TB phai dem output_we.
    - tb_split_channels.v: C=4/8/3 (chia deu va le). PASS 3/3.
    - tb_upsample_nearest.v: SF=2, SF=2 C2, SF=4. PASS 3/3.
    - tb_residual_add_int8.v: quet TOAN BO 65536 to hop. PASS 65536/65536.
    - tb_sppf_block.v: 3 maxpool + concat 4 nhanh. PASS 64/64.
    Phat hien: done bat cung chu ky output_w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
2026-10-31 feat(fpga): sinh weights THAT 88 lop, verify bang lop voi graph
    Ba viec khong can kit, hoan thanh:
    1. Sua TopModule
    - impl/KVC_FPGA_process_config.json: kvc_yolo_top -> kvc_top_demo
    - Build lai: Logic 994/20736 (5%), DSP 0.5/24, Fmax 100 MHz,
    0 setup/hold violation, .fs sinh thanh cong
    2. Sinh weights THAT cho 88 lop (tools/gen_weights_all.py)
    Truoc day gen/ la du lieu gia: weights.bin chi 0.083% byte khac 0,
    quant.hex toan 0. Nay:
    - weights.bin: 2,574,656 byte, nonzero 2,539,072 (98.62%)
    - bias.hex : 7,887 dong, range [-20, 20]
    - quant.hex : 7,887 dong, mult!=0 ca 7,887, shift [39..54]
    - metadata.json: hash SHA256 + tham so de tai lap
    Anh xa node_name -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
2026-10-31 docs(fpga): checklist bring-up, parser UART, spec viet lai top
    Ba viec chuan bi, khong can kit:
    1. docs/verification/BRINGUP_CHECKLIST.md (VER-003)
    - G0: do nguon LM2596 truoc khi cam (5.0V +-0.1, ripple <100mV)
    - G2: nap bitstream, kiem UART bang USB-UART 3.3V tai R13,
    parser xac nhan khung IF-01, noi MCU doc fe/crc, soak 30 phut
    - G6: camera (14 chan J1), sieu am 2/3/4/5 m, hieu chuan fx_px
    - Bang chan doan: B4 4A = bitstream cu, khong co du lieu = sai chan
    - Bang ghi ket qua de sao chep khi chay
    - Muc 'khong duoc lam': cam FPGA truoc khi do nguon, dung
    USB-UART 5V, noi MCU truoc khi kiem UART, danh dau PASS khong log
    2. scripts/manual/fpga_uart_capture.py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
2026-10-31 feat(fpga): line buffer da kenh (thay line_buffer_3x3)
    Them:
    - src/line_buffer_mc.v: line buffer 3 dong, DA KENH, xuat win_data
    packed [(K*K*C*8)-1:0] thay vi 9 port win_00..win_22.
    Day la giao dien ma conv_engine_dynamic_fsm can.
    - verification/tb/tb_line_buffer_mc.v: PASS 5/5 (135 byte) -
    vi tri giua, bien trai/phai (padding), nhieu kenh khong lan.
    - scripts/run_fpga_tb.ps1: them tb_line_buffer_mc -> 15/15 PASS.
    Kiem tra BSRAM (W=160, K=3):
    C=16 -> 7.5 KiB (7%)
    C=64 -> 30 KiB (29%)
    C=128 -> 60 KiB (58%)
    C=256 -> 120 KiB (116% - VUOT)
    Tu conv_layer_map.csv, (w*C) lon nhat (bo DFL) la 20480 tai lop 44
    (w=80, C=256) -> 60 KiB, vua BSRAM. Lop 87 (DFL) vuot nhung bi loai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
2026-11-02 docs: bo Replay khoi UI, bo sung IF-05 ESP32-S3-CAM, dong bo trang thai ky thuat
